spyadrian/digital-scale-pcb-firmware/docs/slides-fr.pdf

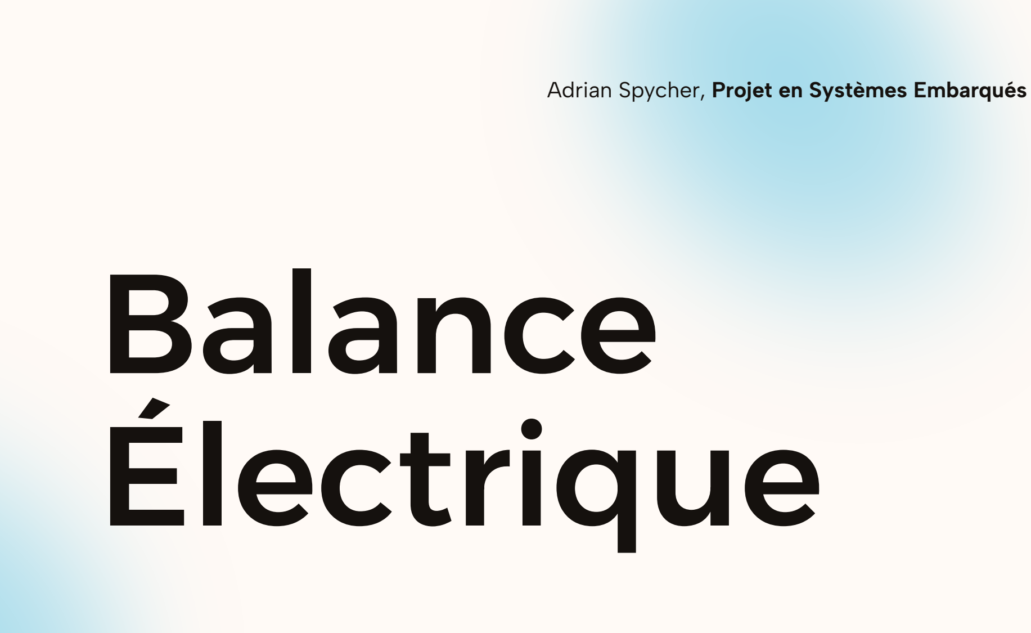
[picture p43: page 1]

# Balance Électrique

Adrian Spycher, Projet en Systèmes Embarqués

01 | Mon Projet
02 | Composants Principaux
03 | Ma Solution

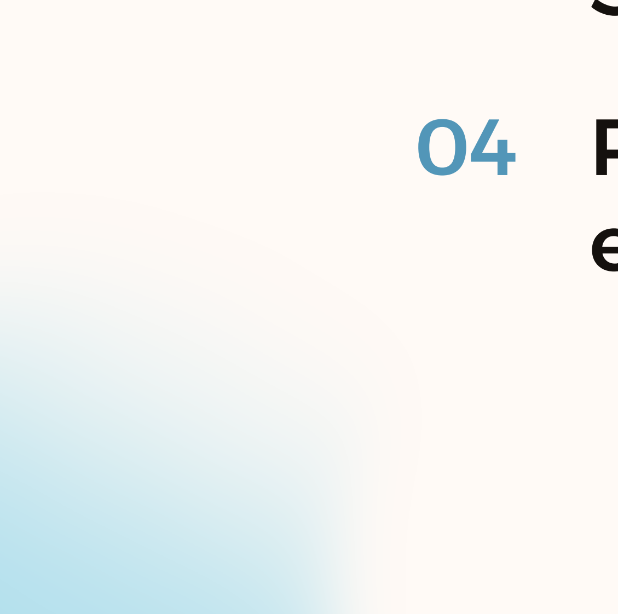
[picture p44: figure]

04 | Résultats et Problèmes

# Table des matières

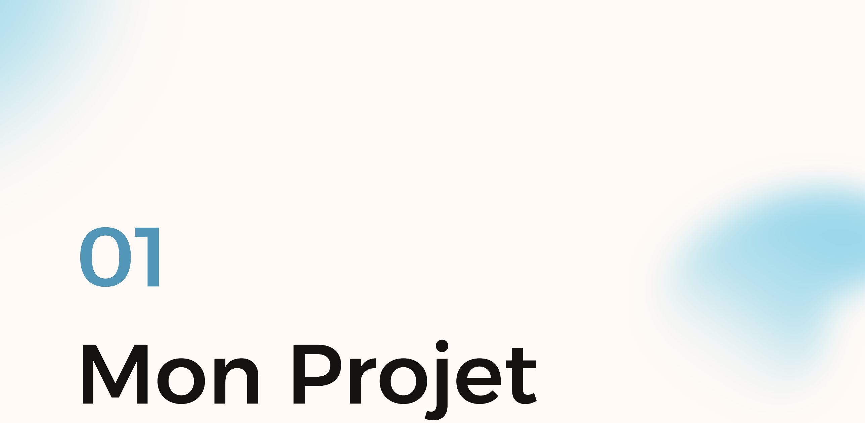
[picture p45: page 3]

01

# Mon Projet

# Balance

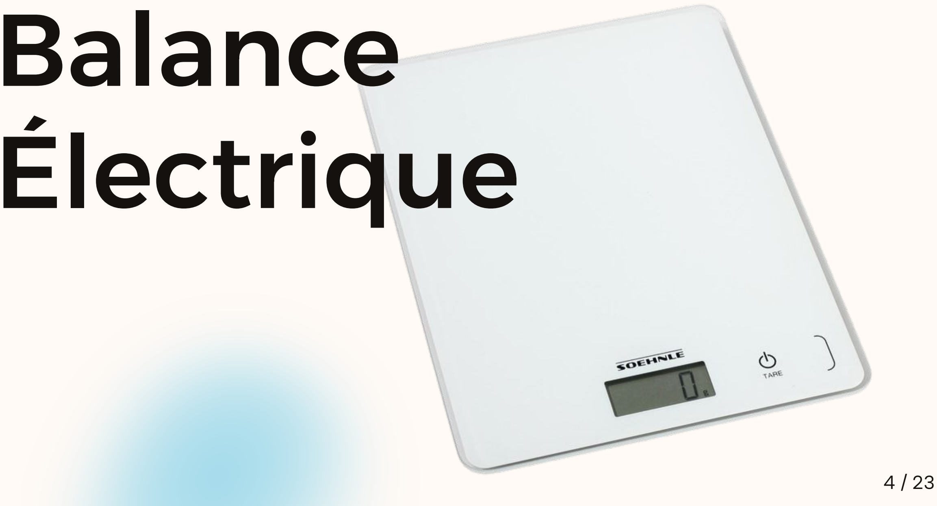
[picture p46: page 4]

# Électrique

NXP LPC804

# Contraintes

Deux I2C et GPIOs

## Basé sur un Microcontrôleur

## Protocole de Communication

SWDIO

Écran OLED 2x16 caractères

## Connecteur JTAG / SWDIO

## Capteur et Écran

Proche de celle du premier semestre

3cm x 3cm en dehors de l’écran

Autonome,

## sur Batterie

## Dimension Max

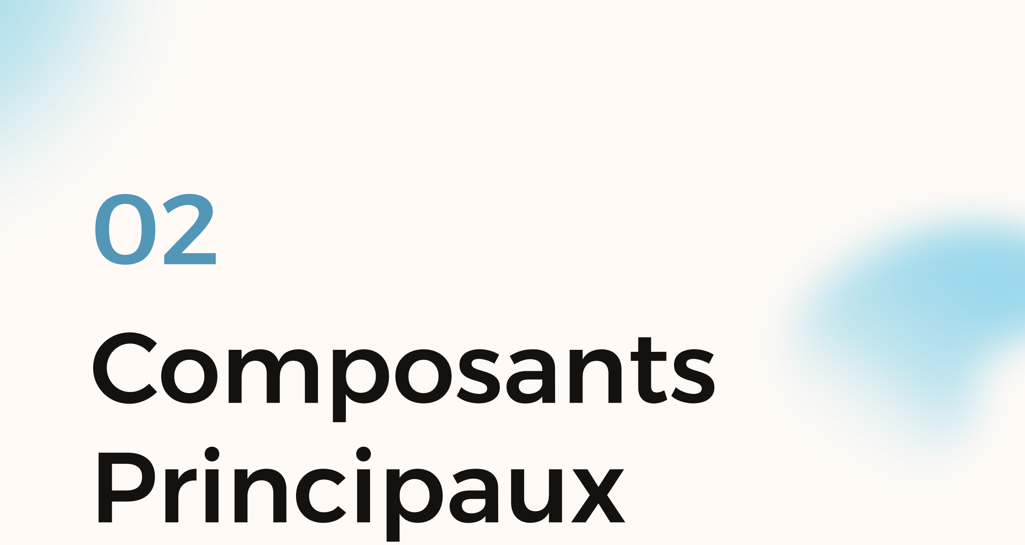
[picture p47: page 6]

# Principaux

02

# Composants

# Gestion de l’alimentation

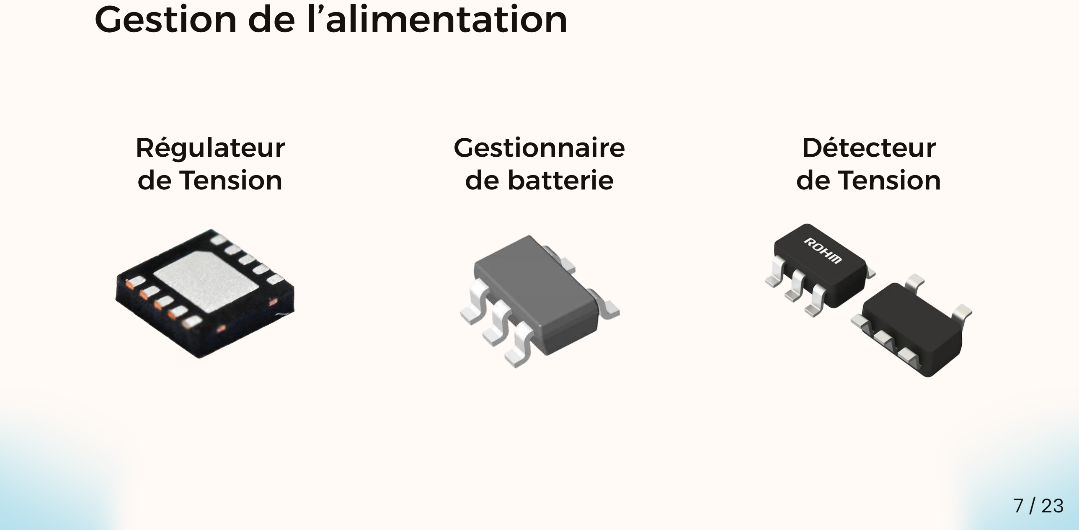
[picture p48: page 7]

## Régulateur de Tension

## Gestionnaire de batterie

## Détecteur de Tension

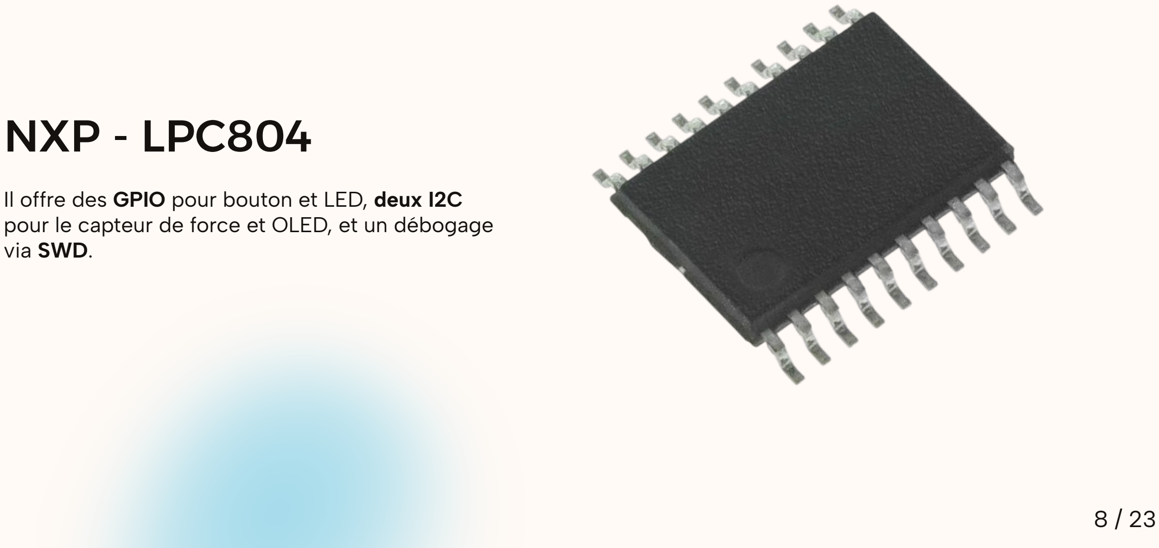
[picture p49: page 8]

# NXP - LPC804

Il offre des GPIO pour bouton et LED, deux I2C pour le capteur de force et OLED, et un débogage via SWD.

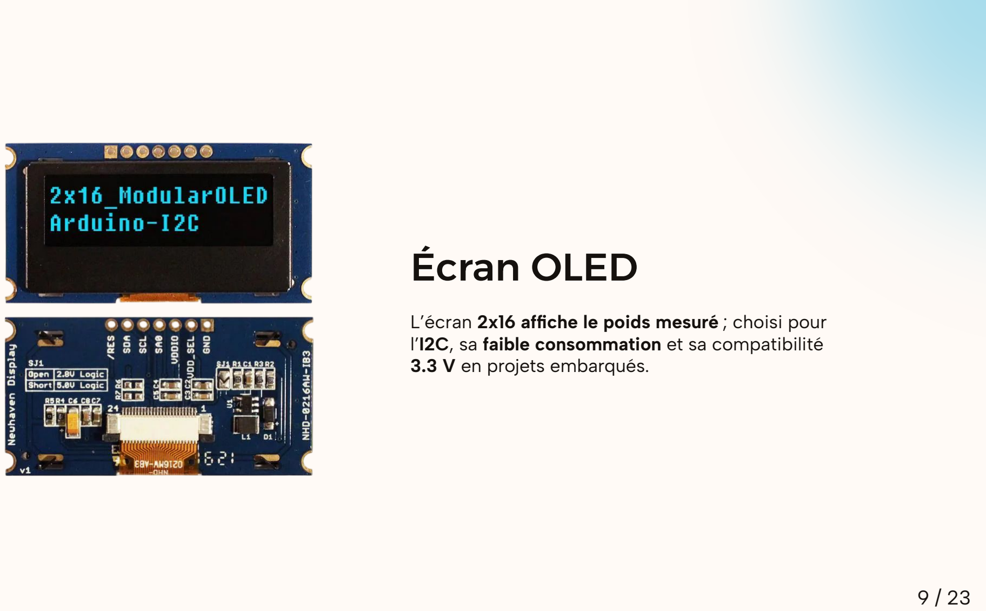
[picture p50: page 9]

# Écran OLED

L’écran 2x16 affiche le poids mesuré ; choisi pour l’I2C, sa faible consommation et sa compatibilité 3.3 V en projets embarqués.

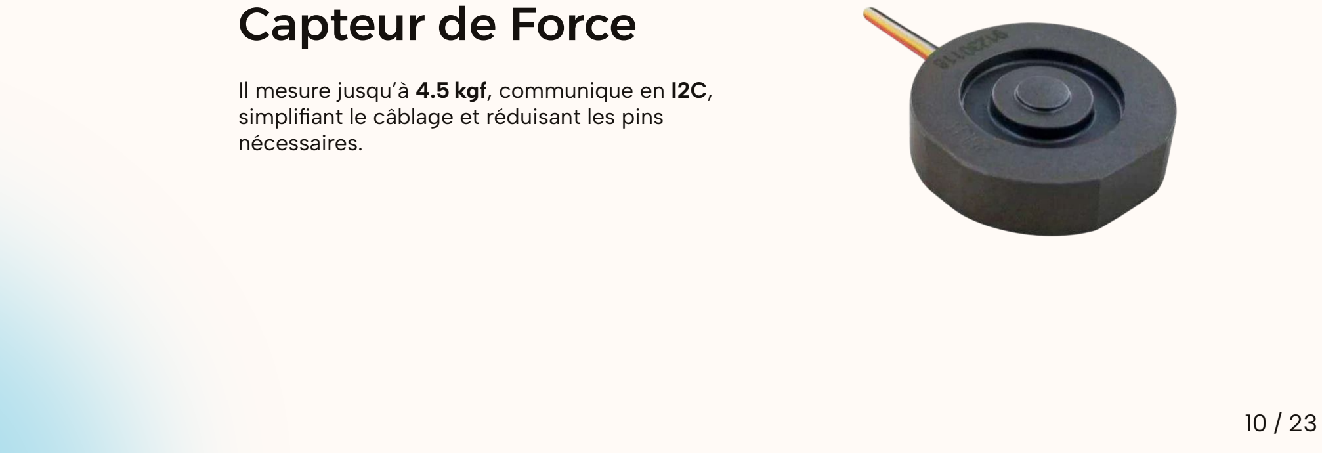
[picture p51: page 10]

# Capteur de Force

Il mesure jusqu’à 4.5 kgf, communique en I2C, simplifiant le câblage et réduisant les pins nécessaires.

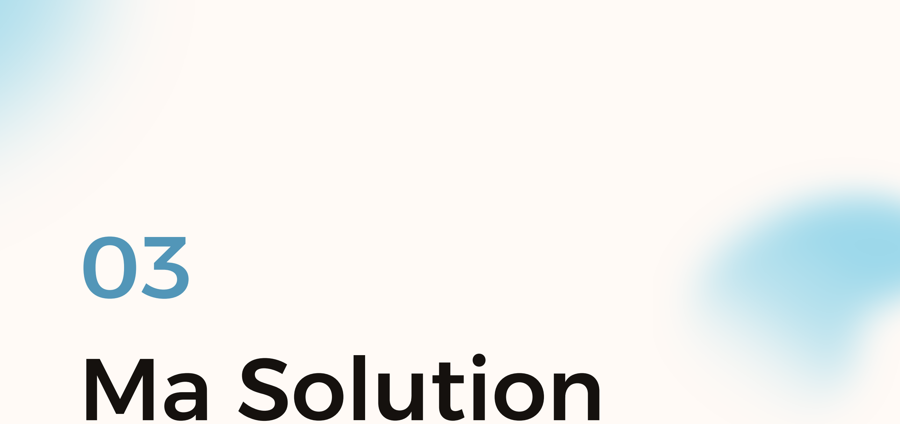
[picture p52: page 11]

03

# Ma Solution

# Schéma

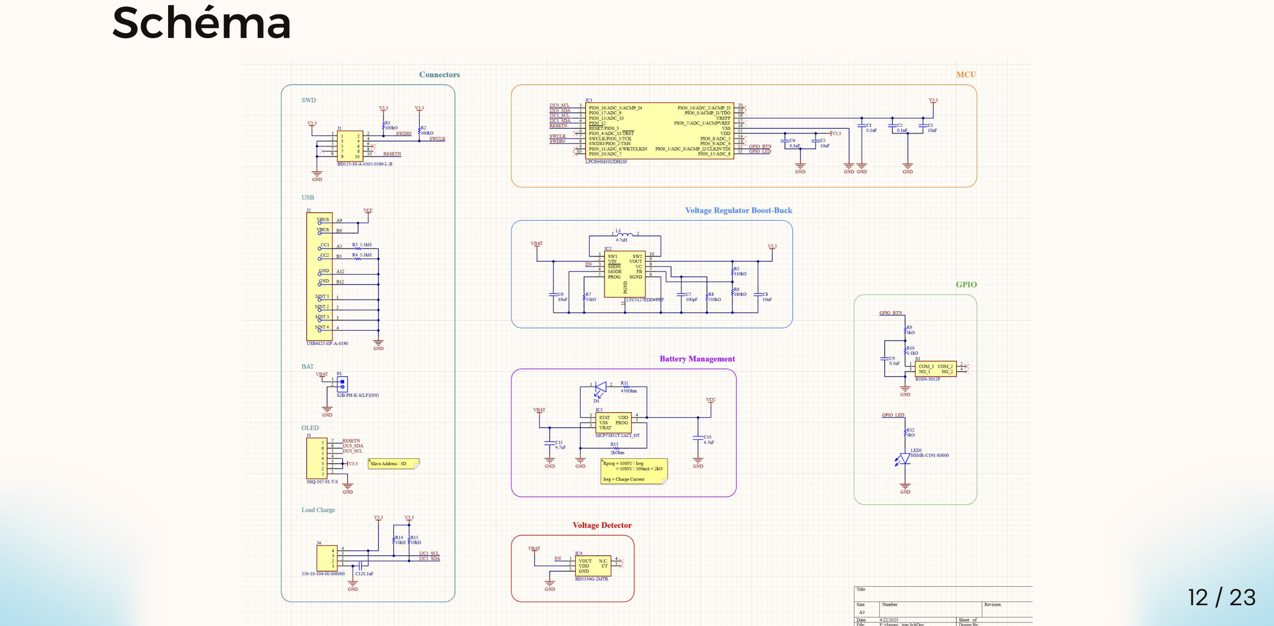
[picture p53: page 12]

# Schéma Bloc

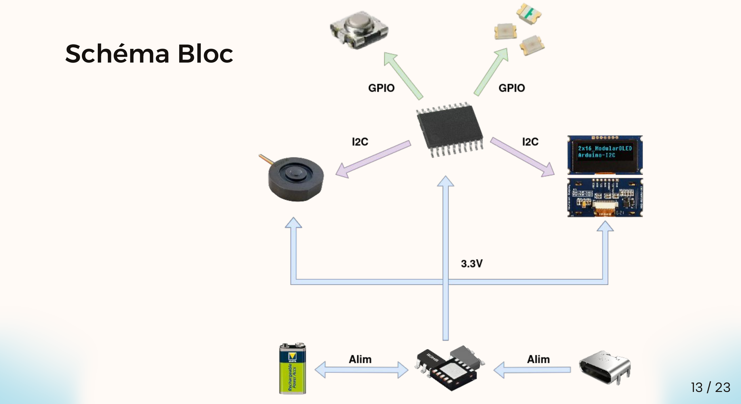
[picture p54: page 13]
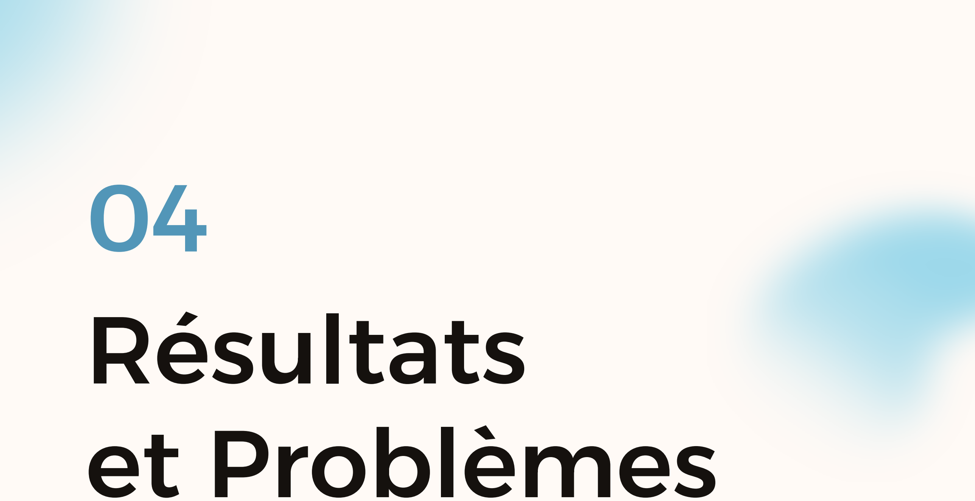
[picture p55: page 14]

# et Problèmes

04

# Résultats

## PCB Sur Altium

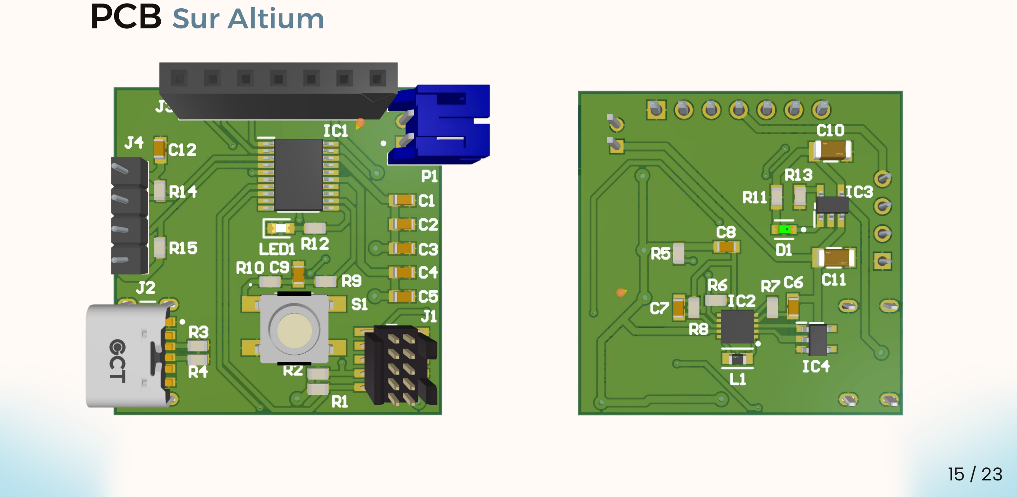
[picture p56: page 15]

## PCB Face avant

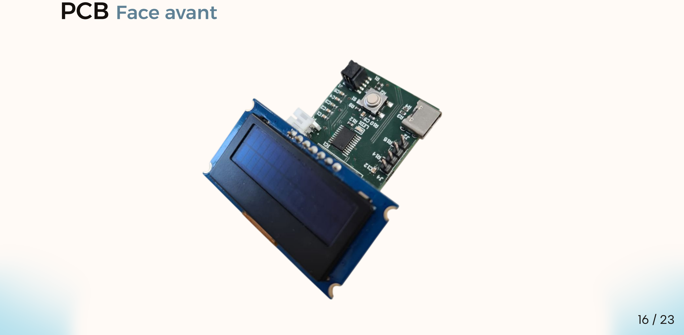
[picture p57: page 16]

## PCB Face arrière

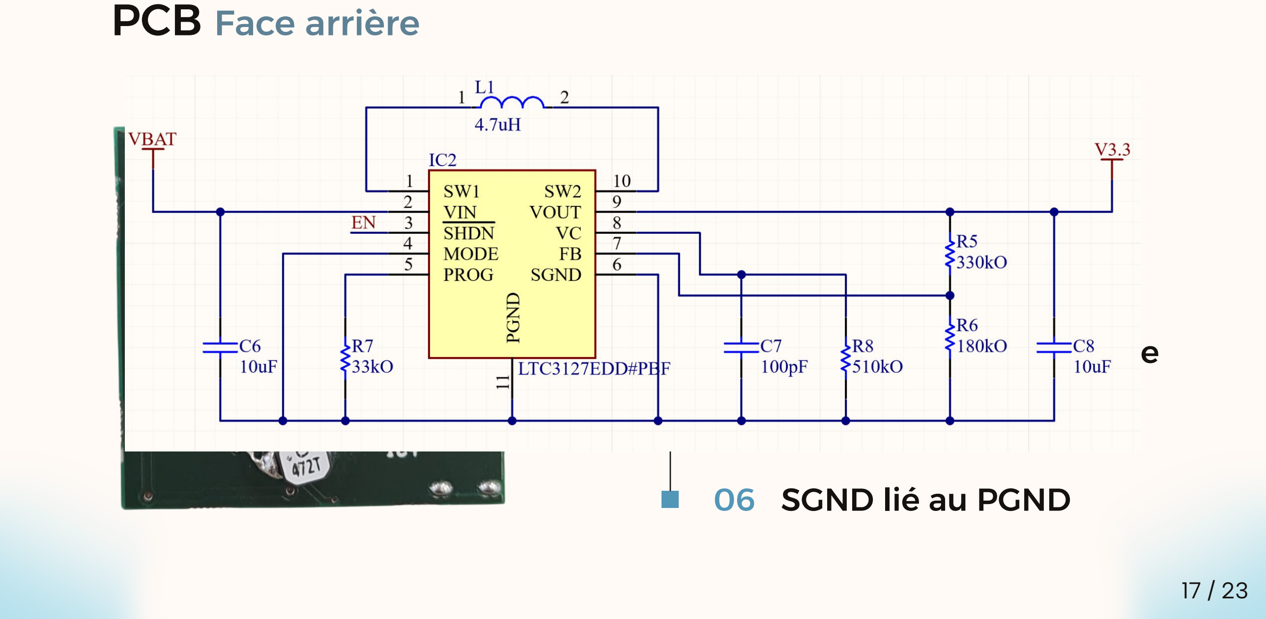
[picture p58: page 17]

01 | Signal Flottant
02 | Mauvais Footprint
03 | Tension entre 2 et 7 V
04 | Changement de Bobine
05 | Changement de COUT
06 | SGND lié au PGND

# Stabilité de la sortie 3.3V

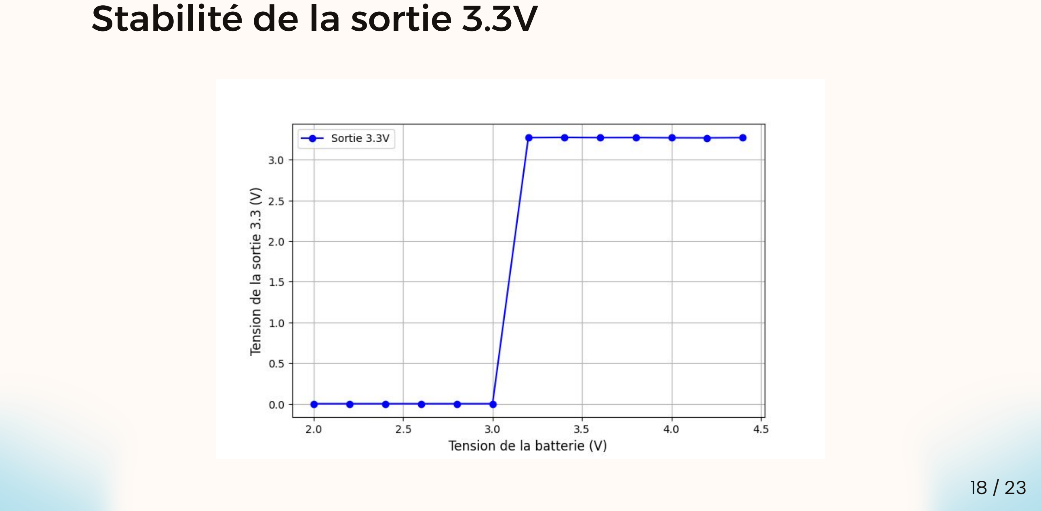
[picture p59: page 18]

# Programmation du PCB

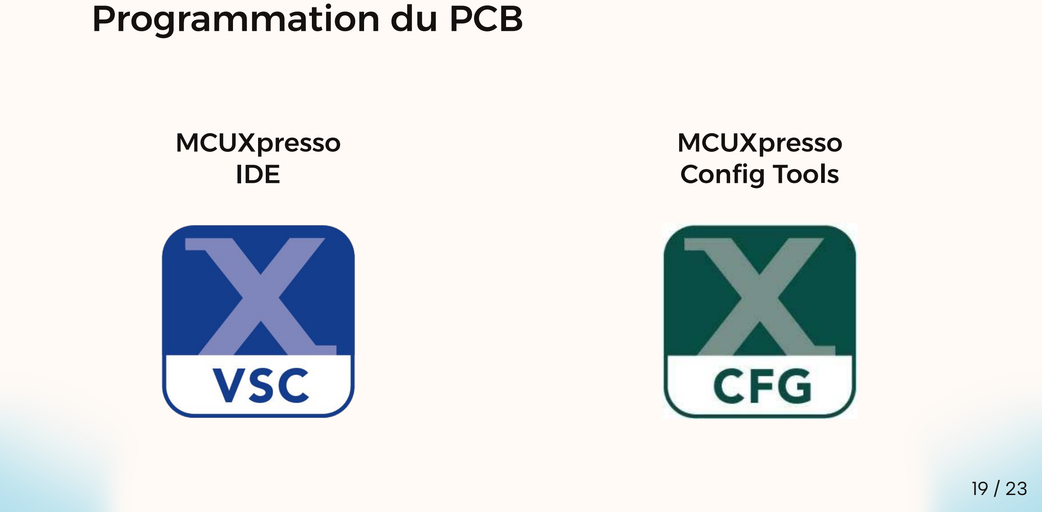
[picture p60: page 19]

## MCUXpresso IDE

## MCUXpresso Config Tools

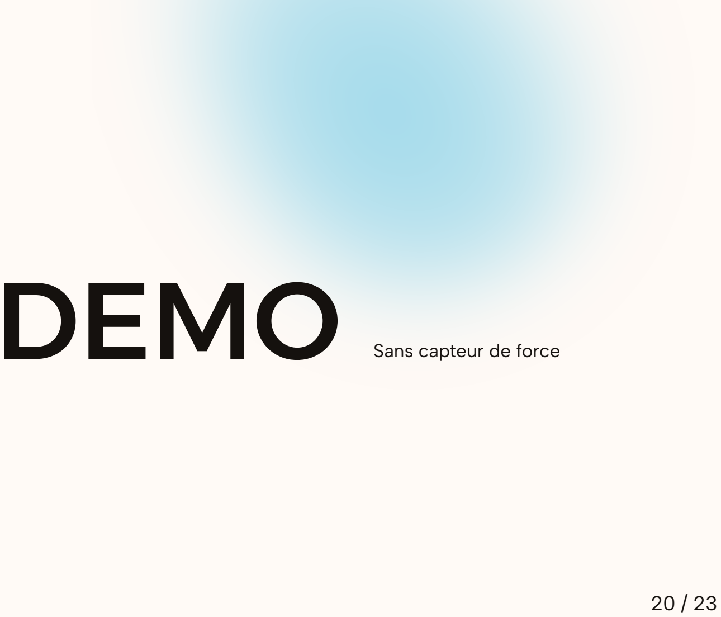
[picture p61: page 20]

# DEMO

Sans capteur de force

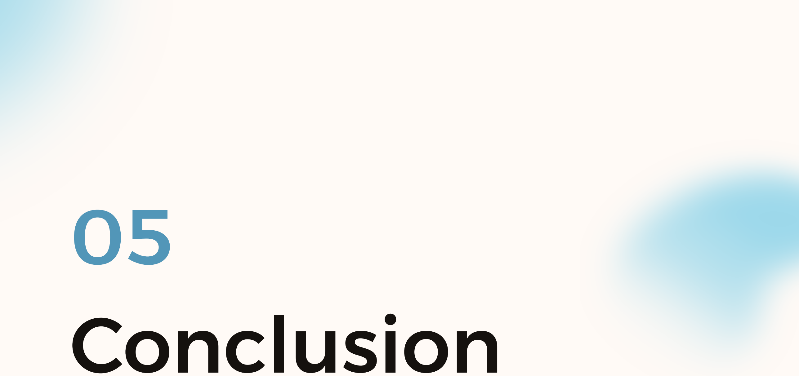
[picture p62: page 21]

05

# Conclusion

# Conclusion

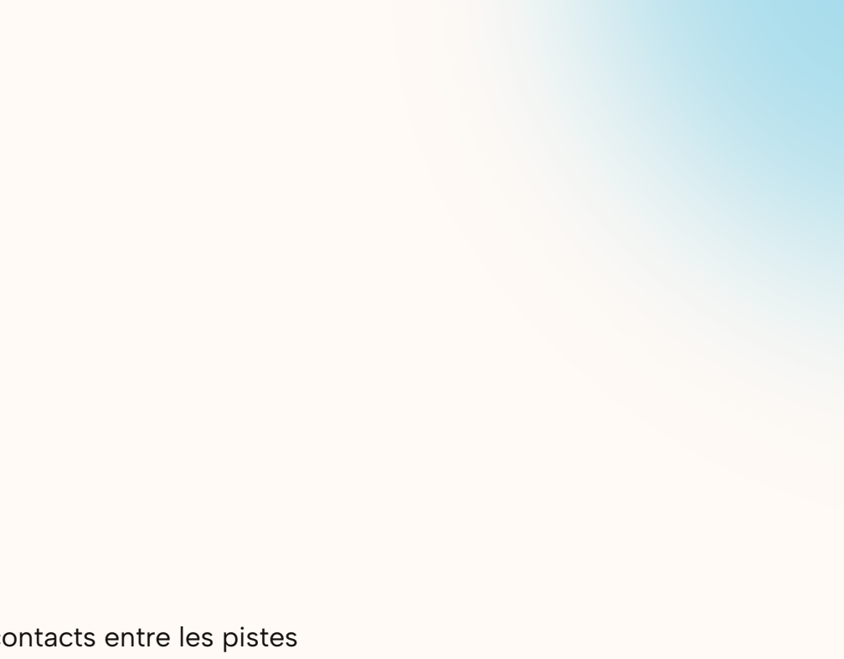
[picture p63: figure]

Lors d’un problème, je vérifierai plus rapidement les contacts entre les pistes

## Bilan du projet

## Si c’était à refaire

■ La conception et montage du PCB ■ À programmer le PCB
■ PCB fonctionnel

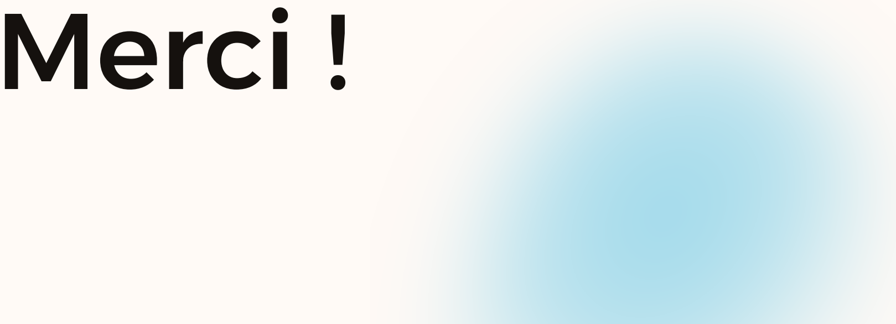
[picture p64: page 23]

# Merci !
