spyadrian/digital-scale-pcb-firmware/docs/photos/pcb-3d-back.png

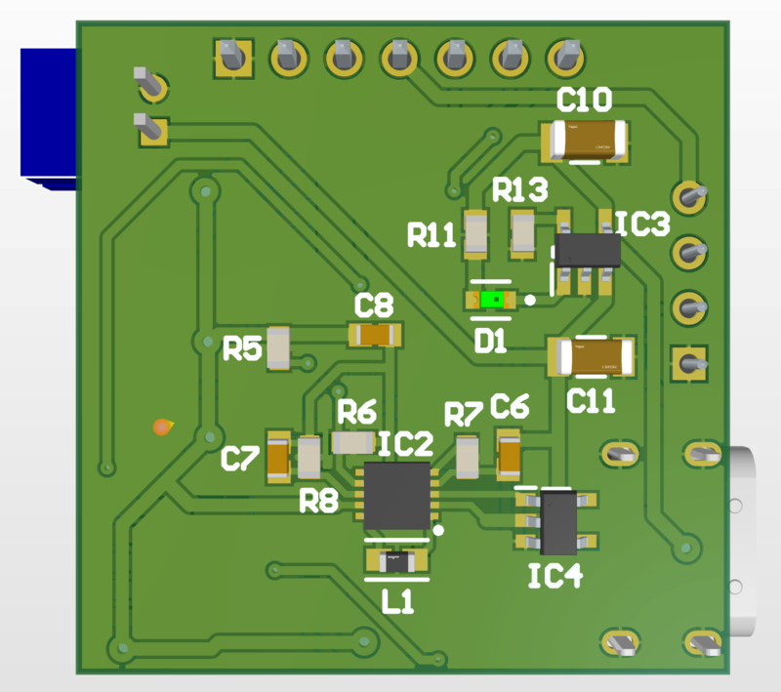
docs/photos/pcb-3d-back.png
