spyadrian/digital-scale-pcb-firmware/docs/photos/pcb-back.jpg

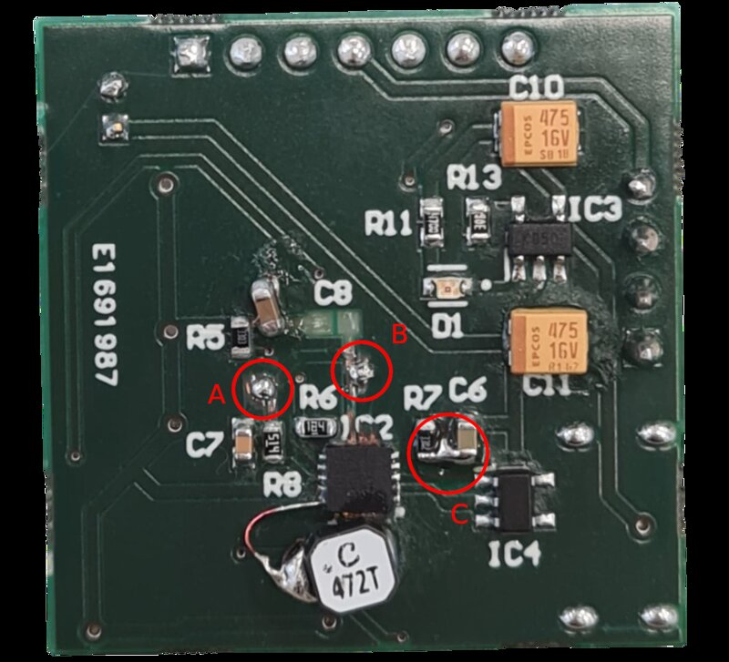
docs/photos/pcb-back.jpg
