spyadrian/digital-scale-pcb-firmware/hardware/Project Outputs for scale_project/scale_project.csv

Name | Description | Designator
0.1uF | Chip Capacitor, 100 pF, +/- 5%, 50 V, -55 to 125 degC, 0603 (1608 Metric), RoHS, Tape and Reel | C1
0.1uF | Chip Capacitor, 100 pF, +/- 5%, 50 V, -55 to 125 degC, 0603 (1608 Metric), RoHS, Tape and Reel | C2
10uF | Chip Capacitor, 100 pF, +/- 5%, 50 V, -55 to 125 degC, 0603 (1608 Metric), RoHS, Tape and Reel | C3
0.1uF | Chip Capacitor, 100 pF, +/- 5%, 50 V, -55 to 125 degC, 0603 (1608 Metric), RoHS, Tape and Reel | C4
10uF | Chip Capacitor, 100 pF, +/- 5%, 50 V, -55 to 125 degC, 0603 (1608 Metric), RoHS, Tape and Reel | C5
10uF | Chip Capacitor, 100 pF, +/- 5%, 50 V, -55 to 125 degC, 0603 (1608 Metric), RoHS, Tape and Reel | C6
100pF | Chip Capacitor, 100 pF, +/- 5%, 50 V, -55 to 125 degC, 0603 (1608 Metric), RoHS, Tape and Reel | C7
10uF | Chip Capacitor, 100 pF, +/- 5%, 50 V, -55 to 125 degC, 0603 (1608 Metric), RoHS, Tape and Reel | C8
0.1uF | Chip Capacitor, 100 pF, +/- 5%, 50 V, -55 to 125 degC, 0603 (1608 Metric), RoHS, Tape and Reel | C9
4.7uF | CAP CER 4.7UF 50V X7R 1206 | C10
4.7uF | CAP CER 4.7UF 50V X7R 1206 | C11
0.1uF | Chip Capacitor, 100 pF, +/- 5%, 50 V, -55 to 125 degC, 0603 (1608 Metric), RoHS, Tape and Reel | C12
LTST-C190GKT | LED GREEN CLEAR CHIP SMD | D1
LPC804M101JDH20J | Integrated Circuit | IC1
LTC3127EDD#PBF | Integrated Circuit | IC2
MCP73831T-2ACI_OT | Integrated Circuit | IC3
BD5330G-2MTR | Integrated Circuit | IC4
BD125-10-A-0305-0580-L-B | Connector | J1
USB4125-GF-A-0190 | CONN RCPT TYPE C 6P SMD RA | J2
SSQ-107-01-T-S | Connector | J3
350-10-104-00-006000 | Connector | J4
4.7uH | FIXED IND 4.7UH 80MA 600 MOHM | L1
HSMR-C191-S0000 | LED | LED1
S2B-PH-K-S(LF)(SN) | Male Header, Pitch 2 mm, 1 x 2 Position, Height 4.8 mm, Tail Length 3.4 mm, -25 to 85 degC, RoHS, Bulk | P1
100kO |  | R1
100kO |  | R2
5.1kO |  | R3
5.1kO |  | R4
330kO |  | R5
180kO |  | R6
33kO |  | R7
510kO |  | R8
1kO |  | R9
0.1kO |  | R10
470Ohm |  | R11
1kO |  | R12
2kOhm |  | R13
10kO |  | R14
10kO |  | R15
B3SN-3012P | Switch | S1
