spyadrian/digital-scale-pcb-firmware/hardware/scale_project.pdf

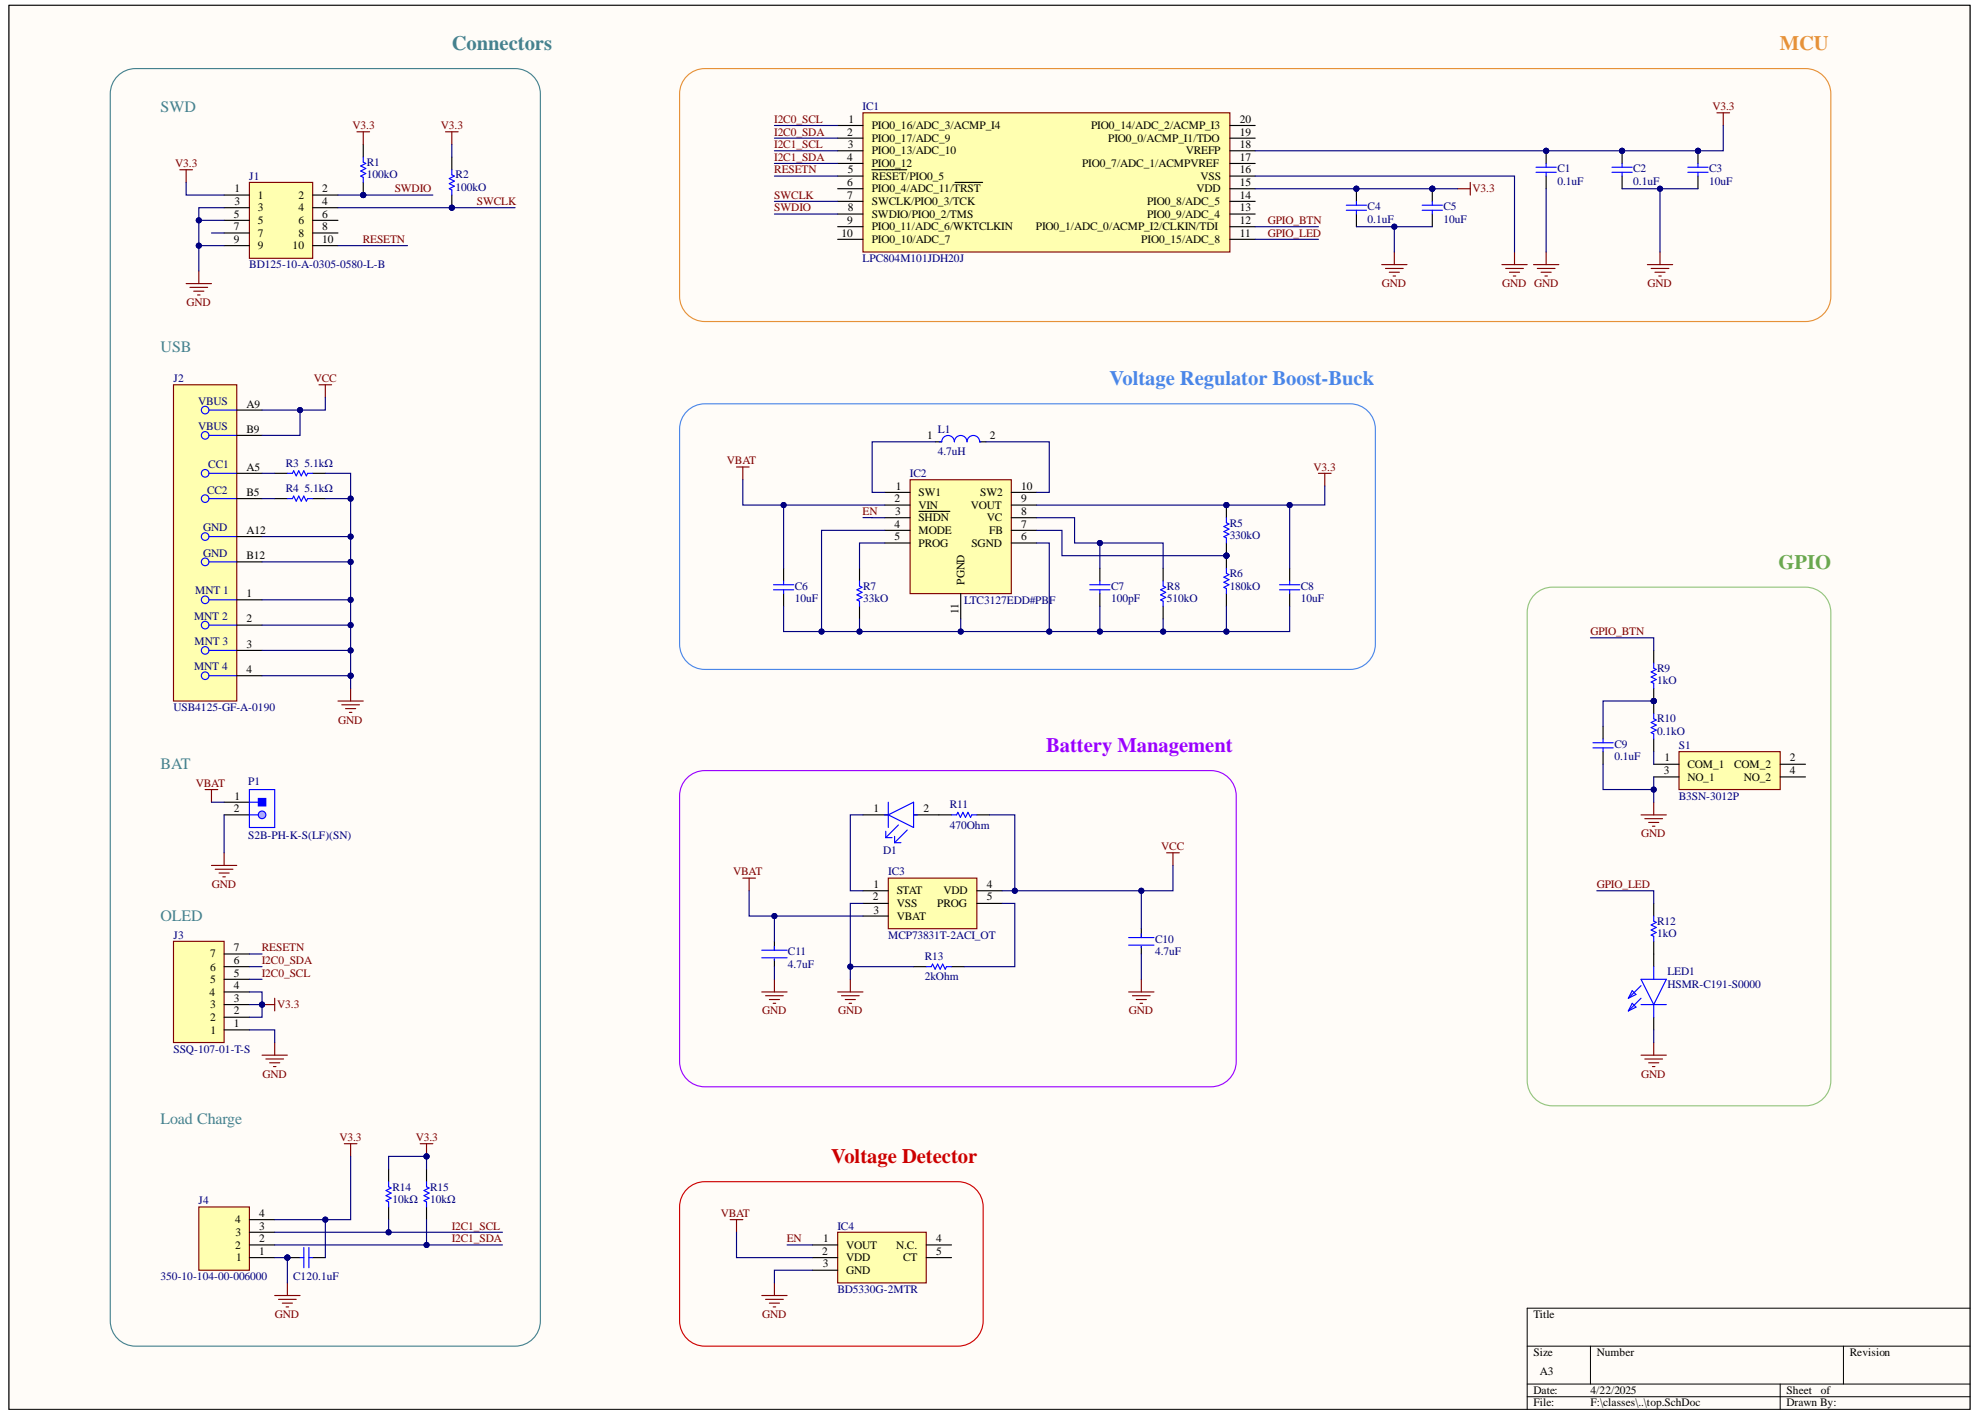
[picture p67: page 1]

Voltage Regulator Boost-Buck

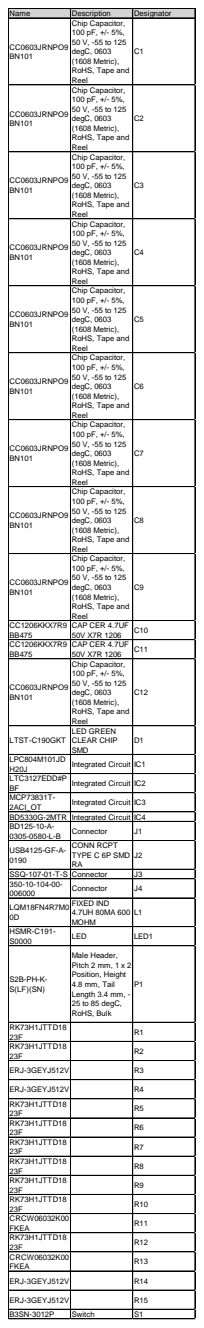
[picture p68: page 2]

Name | Description | Designator
CC0603JRNPO9 BN101 | Chip Capacitor, 100 pF, +/- 5%, 50 V, -55 to 125 degC, 0603 (1608 Metric), RoHS, Tape and Reel | C1

CC0603JRNPO9 BN101 | Chip Capacitor, 100 pF, +/- 5%, 50 V, -55 to 125 degC, 0603 (1608 Metric), RoHS, Tape and Reel | C2

CC0603JRNPO9 BN101 | Chip Capacitor, 100 pF, +/- 5%, 50 V, -55 to 125 degC, 0603 (1608 Metric), RoHS, Tape and Reel | C3

CC0603JRNPO9 BN101 | Chip Capacitor, 100 pF, +/- 5%, 50 V, -55 to 125 degC, 0603 (1608 Metric), RoHS, Tape and Reel | C4

CC0603JRNPO9 BN101 | Chip Capacitor, 100 pF, +/- 5%, 50 V, -55 to 125 degC, 0603 (1608 Metric), RoHS, Tape and Reel | C5

CC0603JRNPO9 BN101 | Chip Capacitor, 100 pF, +/- 5%, 50 V, -55 to 125 degC, 0603 (1608 Metric), RoHS, Tape and Reel | C6

CC0603JRNPO9 BN101 | Chip Capacitor, 100 pF, +/- 5%, 50 V, -55 to 125 degC, 0603 (1608 Metric), RoHS, Tape and Reel | C7

CC0603JRNPO9 BN101 | Chip Capacitor, 100 pF, +/- 5%, 50 V, -55 to 125 degC, 0603 (1608 Metric), RoHS, Tape and Reel | C8

CC0603JRNPO9 BN101 | Chip Capacitor, 100 pF, +/- 5%, 50 V, -55 to 125 degC, 0603 (1608 Metric), RoHS, Tape and Reel | C9

CC1206KKX7R9 BB475 | CAP CER 4.7UF 50V X7R 1206 | C10

CC1206KKX7R9 BB475 | CAP CER 4.7UF 50V X7R 1206 | C11

CC0603JRNPO9 BN101 | Chip Capacitor, 100 pF, +/- 5%, 50 V, -55 to 125 degC, 0603 (1608 Metric), RoHS, Tape and Reel | C12

LTST-C190GKT | LED GREEN CLEAR CHIP SMD | D1

LPC804M101JD H20J | Integrated Circuit | IC1

LTC3127EDD#P BF | Integrated Circuit | IC2

MCP73831T-2ACI_OT | Integrated Circuit | IC3

BD5330G-2MTR | Integrated Circuit | IC4
BD125-10-A-0305-0580-L-B | Connector | J1

USB4125-GF-A-0190 | CONN RCPT TYPE C 6P SMD RA | J2

SSQ-107-01-T-S | Connector | J3
350-10-104-00-006000 | Connector | J4

LQM18FN4R7M0 0D | FIXED IND 4.7UH 80MA 600 MOHM | L1

HSMR-C191-S0000 | LED | LED1

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

RK73H1JTTD18 23F | | R1

RK73H1JTTD18 23F | | R2

ERJ-3GEYJ512V | | R3

ERJ-3GEYJ512V | | R4

RK73H1JTTD18 23F | | R5

RK73H1JTTD18 23F | | R6

RK73H1JTTD18 23F | | R7

RK73H1JTTD18 23F | | R8

RK73H1JTTD18 23F | | R9

RK73H1JTTD18 23F | | R10

CRCW06032K00 FKEA | | R11

RK73H1JTTD18 23F | | R12

CRCW06032K00 FKEA | | R13

ERJ-3GEYJ512V | | R14

ERJ-3GEYJ512V | | R15

B3SN-3012P | Switch | S1
