spyadrian/digital-scale-pcb-firmware/(list of files, drawings)

Other design files:
hardware/PCB1.PcbDoc
hardware/PcbLib1.PcbLib
hardware/scale_project.PrjPcb
hardware/Schlib1.SchLib
hardware/top.SchDoc
