spyadrian/digital-scale-pcb-firmware/firmware/device/periph5/PERI_PINT.h

/*
** ###################################################################
**     Processors:          LPC804M101JDH20
**                          LPC804M101JDH24
**                          LPC804M101JHI33
**                          LPC804M111JDH24
**                          LPC804UK
**
**     Version:             rev. 1.0, 2018-01-09
**     Build:               b240704
**
**     Abstract:
**         CMSIS Peripheral Access Layer for PINT
**
**     Copyright 1997-2016 Freescale Semiconductor, Inc.
**     Copyright 2016-2024 NXP
**     SPDX-License-Identifier: BSD-3-Clause
**
**     http:                 www.nxp.com
**     mail:                 support@nxp.com
**
**     Revisions:
**     - rev. 1.0 (2018-01-09)
**         Initial version.
**
** ###################################################################
*/

/*!
 * @file PINT.h
 * @version 1.0
 * @date 2018-01-09
 * @brief CMSIS Peripheral Access Layer for PINT
 *
 * CMSIS Peripheral Access Layer for PINT
 */

#if !defined(PINT_H_)
#define PINT_H_                                  /**< Symbol preventing repeated inclusion */

#if (defined(CPU_LPC804M101JDH20) || defined(CPU_LPC804M101JDH24) || defined(CPU_LPC804M101JHI33) || defined(CPU_LPC804M111JDH24) || defined(CPU_LPC804UK))
#include "LPC804_COMMON.h"
#else
  #error "No valid CPU defined!"
#endif

/* ----------------------------------------------------------------------------
   -- Device Peripheral Access Layer
   ---------------------------------------------------------------------------- */

/*!
 * @addtogroup Peripheral_access_layer Device Peripheral Access Layer
 * @{
 */


/*
** Start of section using anonymous unions
*/

#if defined(__ARMCC_VERSION)
  #if (__ARMCC_VERSION >= 6010050)
    #pragma clang diagnostic push
  #else
    #pragma push
    #pragma anon_unions
  #endif
#elif defined(__GNUC__)
  /* anonymous unions are enabled by default */
#elif defined(__IAR_SYSTEMS_ICC__)
  #pragma language=extended
#else
  #error Not supported compiler type
#endif

/* ----------------------------------------------------------------------------
   -- PINT Peripheral Access Layer
   ---------------------------------------------------------------------------- */

/*!
 * @addtogroup PINT_Peripheral_Access_Layer PINT Peripheral Access Layer
 * @{
 */

/** PINT - Register Layout Typedef */
typedef struct {
  __IO uint32_t ISEL;                              /**< Pin Interrupt Mode register, offset: 0x0 */
  __IO uint32_t IENR;                              /**< Pin interrupt level or rising edge interrupt enable register, offset: 0x4 */
  __O  uint32_t SIENR;                             /**< Pin interrupt level or rising edge interrupt set register, offset: 0x8 */
  __O  uint32_t CIENR;                             /**< Pin interrupt level (rising edge interrupt) clear register, offset: 0xC */
  __IO uint32_t IENF;                              /**< Pin interrupt active level or falling edge interrupt enable register, offset: 0x10 */
  __O  uint32_t SIENF;                             /**< Pin interrupt active level or falling edge interrupt set register, offset: 0x14 */
  __O  uint32_t CIENF;                             /**< Pin interrupt active level or falling edge interrupt clear register, offset: 0x18 */
  __IO uint32_t RISE;                              /**< Pin interrupt rising edge register, offset: 0x1C */
  __IO uint32_t FALL;                              /**< Pin interrupt falling edge register, offset: 0x20 */
  __IO uint32_t IST;                               /**< Pin interrupt status register, offset: 0x24 */
  __IO uint32_t PMCTRL;                            /**< Pattern match interrupt control register, offset: 0x28 */
  __IO uint32_t PMSRC;                             /**< Pattern match interrupt bit-slice source register, offset: 0x2C */
  __IO uint32_t PMCFG;                             /**< Pattern match interrupt bit slice configuration register, offset: 0x30 */
} PINT_Type;

/* ----------------------------------------------------------------------------
   -- PINT Register Masks
   ---------------------------------------------------------------------------- */

/*!
 * @addtogroup PINT_Register_Masks PINT Register Masks
 * @{
 */

/*! @name ISEL - Pin Interrupt Mode register */
/*! @{ */

#define PINT_ISEL_PMODE_MASK                     (0xFFU)
#define PINT_ISEL_PMODE_SHIFT                    (0U)
/*! PMODE - Selects the interrupt mode for each pin interrupt. Bit n configures the pin interrupt
 *    selected in PINTSELn. 0 = Edge sensitive 1 = Level sensitive
 */
#define PINT_ISEL_PMODE(x)                       (((uint32_t)(((uint32_t)(x)) << PINT_ISEL_PMODE_SHIFT)) & PINT_ISEL_PMODE_MASK)
/*! @} */

/*! @name IENR - Pin interrupt level or rising edge interrupt enable register */
/*! @{ */

#define PINT_IENR_ENRL_MASK                      (0xFFU)
#define PINT_IENR_ENRL_SHIFT                     (0U)
/*! ENRL - Enables the rising edge or level interrupt for each pin interrupt. Bit n configures the
 *    pin interrupt selected in PINTSELn. 0 = Disable rising edge or level interrupt. 1 = Enable
 *    rising edge or level interrupt.
 */
#define PINT_IENR_ENRL(x)                        (((uint32_t)(((uint32_t)(x)) << PINT_IENR_ENRL_SHIFT)) & PINT_IENR_ENRL_MASK)
/*! @} */

/*! @name SIENR - Pin interrupt level or rising edge interrupt set register */
/*! @{ */

#define PINT_SIENR_SETENRL_MASK                  (0xFFU)
#define PINT_SIENR_SETENRL_SHIFT                 (0U)
/*! SETENRL - Ones written to this address set bits in the IENR, thus enabling interrupts. Bit n
 *    sets bit n in the IENR register. 0 = No operation. 1 = Enable rising edge or level interrupt.
 */
#define PINT_SIENR_SETENRL(x)                    (((uint32_t)(((uint32_t)(x)) << PINT_SIENR_SETENRL_SHIFT)) & PINT_SIENR_SETENRL_MASK)
/*! @} */

/*! @name CIENR - Pin interrupt level (rising edge interrupt) clear register */
/*! @{ */

#define PINT_CIENR_CENRL_MASK                    (0xFFU)
#define PINT_CIENR_CENRL_SHIFT                   (0U)
/*! CENRL - Ones written to this address clear bits in the IENR, thus disabling the interrupts. Bit
 *    n clears bit n in the IENR register. 0 = No operation. 1 = Disable rising edge or level
 *    interrupt.
 */
#define PINT_CIENR_CENRL(x)                      (((uint32_t)(((uint32_t)(x)) << PINT_CIENR_CENRL_SHIFT)) & PINT_CIENR_CENRL_MASK)
/*! @} */

/*! @name IENF - Pin interrupt active level or falling edge interrupt enable register */
/*! @{ */

#define PINT_IENF_ENAF_MASK                      (0xFFU)
#define PINT_IENF_ENAF_SHIFT                     (0U)
/*! ENAF - Enables the falling edge or configures the active level interrupt for each pin interrupt.
 *    Bit n configures the pin interrupt selected in PINTSELn. 0 = Disable falling edge interrupt
 *    or set active interrupt level LOW. 1 = Enable falling edge interrupt enabled or set active
 *    interrupt level HIGH.
 */
#define PINT_IENF_ENAF(x)                        (((uint32_t)(((uint32_t)(x)) << PINT_IENF_ENAF_SHIFT)) & PINT_IENF_ENAF_MASK)
/*! @} */

/*! @name SIENF - Pin interrupt active level or falling edge interrupt set register */
/*! @{ */

#define PINT_SIENF_SETENAF_MASK                  (0xFFU)
#define PINT_SIENF_SETENAF_SHIFT                 (0U)
/*! SETENAF - Ones written to this address set bits in the IENF, thus enabling interrupts. Bit n
 *    sets bit n in the IENF register. 0 = No operation. 1 = Select HIGH-active interrupt or enable
 *    falling edge interrupt.
 */
#define PINT_SIENF_SETENAF(x)                    (((uint32_t)(((uint32_t)(x)) << PINT_SIENF_SETENAF_SHIFT)) & PINT_SIENF_SETENAF_MASK)
/*! @} */

/*! @name CIENF - Pin interrupt active level or falling edge interrupt clear register */
/*! @{ */

#define PINT_CIENF_CENAF_MASK                    (0xFFU)
#define PINT_CIENF_CENAF_SHIFT                   (0U)
/*! CENAF - Ones written to this address clears bits in the IENF, thus disabling interrupts. Bit n
 *    clears bit n in the IENF register. 0 = No operation. 1 = LOW-active interrupt selected or
 *    falling edge interrupt disabled.
 */
#define PINT_CIENF_CENAF(x)                      (((uint32_t)(((uint32_t)(x)) << PINT_CIENF_CENAF_SHIFT)) & PINT_CIENF_CENAF_MASK)
/*! @} */

/*! @name RISE - Pin interrupt rising edge register */
/*! @{ */

#define PINT_RISE_RDET_MASK                      (0xFFU)
#define PINT_RISE_RDET_SHIFT                     (0U)
/*! RDET - Rising edge detect. Bit n detects the rising edge of the pin selected in PINTSELn. Read
 *    0: No rising edge has been detected on this pin since Reset or the last time a one was written
 *    to this bit. Write 0: no operation. Read 1: a rising edge has been detected since Reset or the
 *    last time a one was written to this bit. Write 1: clear rising edge detection for this pin.
 */
#define PINT_RISE_RDET(x)                        (((uint32_t)(((uint32_t)(x)) << PINT_RISE_RDET_SHIFT)) & PINT_RISE_RDET_MASK)
/*! @} */

/*! @name FALL - Pin interrupt falling edge register */
/*! @{ */

#define PINT_FALL_FDET_MASK                      (0xFFU)
#define PINT_FALL_FDET_SHIFT                     (0U)
/*! FDET - Falling edge detect. Bit n detects the falling edge of the pin selected in PINTSELn. Read
 *    0: No falling edge has been detected on this pin since Reset or the last time a one was
 *    written to this bit. Write 0: no operation. Read 1: a falling edge has been detected since Reset or
 *    the last time a one was written to this bit. Write 1: clear falling edge detection for this
 *    pin.
 */
#define PINT_FALL_FDET(x)                        (((uint32_t)(((uint32_t)(x)) << PINT_FALL_FDET_SHIFT)) & PINT_FALL_FDET_MASK)
/*! @} */

/*! @name IST - Pin interrupt status register */
/*! @{ */

#define PINT_IST_PSTAT_MASK                      (0xFFU)
#define PINT_IST_PSTAT_SHIFT                     (0U)
/*! PSTAT - Pin interrupt status. Bit n returns the status, clears the edge interrupt, or inverts
 *    the active level of the pin selected in PINTSELn. Read 0: interrupt is not being requested for
 *    this interrupt pin. Write 0: no operation. Read 1: interrupt is being requested for this
 *    interrupt pin. Write 1 (edge-sensitive): clear rising- and falling-edge detection for this pin.
 *    Write 1 (level-sensitive): switch the active level for this pin (in the IENF register).
 */
#define PINT_IST_PSTAT(x)                        (((uint32_t)(((uint32_t)(x)) << PINT_IST_PSTAT_SHIFT)) & PINT_IST_PSTAT_MASK)
/*! @} */

/*! @name PMCTRL - Pattern match interrupt control register */
/*! @{ */

#define PINT_PMCTRL_SEL_PMATCH_MASK              (0x1U)
#define PINT_PMCTRL_SEL_PMATCH_SHIFT             (0U)
/*! SEL_PMATCH - Specifies whether the 8 pin interrupts are controlled by the pin interrupt function or by the pattern match function.
 *  0b0..Pin interrupt. Interrupts are driven in response to the standard pin interrupt function.
 *  0b1..Pattern match. Interrupts are driven in response to pattern matches.
 */
#define PINT_PMCTRL_SEL_PMATCH(x)                (((uint32_t)(((uint32_t)(x)) << PINT_PMCTRL_SEL_PMATCH_SHIFT)) & PINT_PMCTRL_SEL_PMATCH_MASK)

#define PINT_PMCTRL_ENA_RXEV_MASK                (0x2U)
#define PINT_PMCTRL_ENA_RXEV_SHIFT               (1U)
/*! ENA_RXEV - Enables the RXEV output to the CPU and/or to a GPIO output when the specified boolean expression evaluates to true.
 *  0b0..Disabled. RXEV output to the CPU is disabled.
 *  0b1..Enabled. RXEV output to the CPU is enabled.
 */
#define PINT_PMCTRL_ENA_RXEV(x)                  (((uint32_t)(((uint32_t)(x)) << PINT_PMCTRL_ENA_RXEV_SHIFT)) & PINT_PMCTRL_ENA_RXEV_MASK)

#define PINT_PMCTRL_PMAT_MASK                    (0xFF000000U)
#define PINT_PMCTRL_PMAT_SHIFT                   (24U)
/*! PMAT - This field displays the current state of pattern matches. A 1 in any bit of this field
 *    indicates that the corresponding product term is matched by the current state of the appropriate
 *    inputs.
 */
#define PINT_PMCTRL_PMAT(x)                      (((uint32_t)(((uint32_t)(x)) << PINT_PMCTRL_PMAT_SHIFT)) & PINT_PMCTRL_PMAT_MASK)
/*! @} */

/*! @name PMSRC - Pattern match interrupt bit-slice source register */
/*! @{ */

#define PINT_PMSRC_SRC0_MASK                     (0x700U)
#define PINT_PMSRC_SRC0_SHIFT                    (8U)
/*! SRC0 - Selects the input source for bit slice 0
 *  0b000..Input 0. Selects the pin selected in the PINTSEL0 register as the source to bit slice 0.
 *  0b001..Input 1. Selects the pin selected in the PINTSEL1 register as the source to bit slice 0.
 *  0b010..Input 2. Selects the pin selected in the PINTSEL2 register as the source to bit slice 0.
 *  0b011..Input 3. Selects the pin selected in the PINTSEL3 register as the source to bit slice 0.
 *  0b100..Input 4. Selects the pin selected in the PINTSEL4 register as the source to bit slice 0.
 *  0b101..Input 5. Selects the pin selected in the PINTSEL5 register as the source to bit slice 0.
 *  0b110..Input 6. Selects the pin selected in the PINTSEL6 register as the source to bit slice 0.
 *  0b111..Input 7. Selects the pin selected in the PINTSEL7 register as the source to bit slice 0.
 */
#define PINT_PMSRC_SRC0(x)                       (((uint32_t)(((uint32_t)(x)) << PINT_PMSRC_SRC0_SHIFT)) & PINT_PMSRC_SRC0_MASK)

#define PINT_PMSRC_SRC1_MASK                     (0x3800U)
#define PINT_PMSRC_SRC1_SHIFT                    (11U)
/*! SRC1 - Selects the input source for bit slice 1
 *  0b000..Input 0. Selects the pin selected in the PINTSEL0 register as the source to bit slice 1.
 *  0b001..Input 1. Selects the pin selected in the PINTSEL1 register as the source to bit slice 1.
 *  0b010..Input 2. Selects the pin selected in the PINTSEL2 register as the source to bit slice 1.
 *  0b011..Input 3. Selects the pin selected in the PINTSEL3 register as the source to bit slice 1.
 *  0b100..Input 4. Selects the pin selected in the PINTSEL4 register as the source to bit slice 1.
 *  0b101..Input 5. Selects the pin selected in the PINTSEL5 register as the source to bit slice 1.
 *  0b110..Input 6. Selects the pin selected in the PINTSEL6 register as the source to bit slice 1.
 *  0b111..Input 7. Selects the pin selected in the PINTSEL7 register as the source to bit slice 1.
 */
#define PINT_PMSRC_SRC1(x)                       (((uint32_t)(((uint32_t)(x)) << PINT_PMSRC_SRC1_SHIFT)) & PINT_PMSRC_SRC1_MASK)

#define PINT_PMSRC_SRC2_MASK                     (0x1C000U)
#define PINT_PMSRC_SRC2_SHIFT                    (14U)
/*! SRC2 - Selects the input source for bit slice 2
 *  0b000..Input 0. Selects the pin selected in the PINTSEL0 register as the source to bit slice 2.
 *  0b001..Input 1. Selects the pin selected in the PINTSEL1 register as the source to bit slice 2.
 *  0b010..Input 2. Selects the pin selected in the PINTSEL2 register as the source to bit slice 2.
 *  0b011..Input 3. Selects the pin selected in the PINTSEL3 register as the source to bit slice 2.
 *  0b100..Input 4. Selects the pin selected in the PINTSEL4 register as the source to bit slice 2.
 *  0b101..Input 5. Selects the pin selected in the PINTSEL5 register as the source to bit slice 2.
 *  0b110..Input 6. Selects the pin selected in the PINTSEL6 register as the source to bit slice 2.
 *  0b111..Input 7. Selects the pin selected in the PINTSEL7 register as the source to bit slice 2.
 */
#define PINT_PMSRC_SRC2(x)                       (((uint32_t)(((uint32_t)(x)) << PINT_PMSRC_SRC2_SHIFT)) & PINT_PMSRC_SRC2_MASK)

#define PINT_PMSRC_SRC3_MASK                     (0xE0000U)
#define PINT_PMSRC_SRC3_SHIFT                    (17U)
/*! SRC3 - Selects the input source for bit slice 3
 *  0b000..Input 0. Selects the pin selected in the PINTSEL0 register as the source to bit slice 3.
 *  0b001..Input 1. Selects the pin selected in the PINTSEL1 register as the source to bit slice 3.
 *  0b010..Input 2. Selects the pin selected in the PINTSEL2 register as the source to bit slice 3.
 *  0b011..Input 3. Selects the pin selected in the PINTSEL3 register as the source to bit slice 3.
 *  0b100..Input 4. Selects the pin selected in the PINTSEL4 register as the source to bit slice 3.
 *  0b101..Input 5. Selects the pin selected in the PINTSEL5 register as the source to bit slice 3.
 *  0b110..Input 6. Selects the pin selected in the PINTSEL6 register as the source to bit slice 3.
 *  0b111..Input 7. Selects the pin selected in the PINTSEL7 register as the source to bit slice 3.
 */
#define PINT_PMSRC_SRC3(x)                       (((uint32_t)(((uint32_t)(x)) << PINT_PMSRC_SRC3_SHIFT)) & PINT_PMSRC_SRC3_MASK)

#define PINT_PMSRC_SRC4_MASK                     (0x700000U)
#define PINT_PMSRC_SRC4_SHIFT                    (20U)
/*! SRC4 - Selects the input source for bit slice 4
 *  0b000..Input 0. Selects the pin selected in the PINTSEL0 register as the source to bit slice 4.
 *  0b001..Input 1. Selects the pin selected in the PINTSEL1 register as the source to bit slice 4.
 *  0b010..Input 2. Selects the pin selected in the PINTSEL2 register as the source to bit slice 4.
 *  0b011..Input 3. Selects the pin selected in the PINTSEL3 register as the source to bit slice 4.
 *  0b100..Input 4. Selects the pin selected in the PINTSEL4 register as the source to bit slice 4.
 *  0b101..Input 5. Selects the pin selected in the PINTSEL5 register as the source to bit slice 4.
 *  0b110..Input 6. Selects the pin selected in the PINTSEL6 register as the source to bit slice 4.
 *  0b111..Input 7. Selects the pin selected in the PINTSEL7 register as the source to bit slice 4.
 */
#define PINT_PMSRC_SRC4(x)                       (((uint32_t)(((uint32_t)(x)) << PINT_PMSRC_SRC4_SHIFT)) & PINT_PMSRC_SRC4_MASK)

#define PINT_PMSRC_SRC5_MASK                     (0x3800000U)
#define PINT_PMSRC_SRC5_SHIFT                    (23U)
/*! SRC5 - Selects the input source for bit slice 5
 *  0b000..Input 0. Selects the pin selected in the PINTSEL0 register as the source to bit slice 5.
 *  0b001..Input 1. Selects the pin selected in the PINTSEL1 register as the source to bit slice 5.
 *  0b010..Input 2. Selects the pin selected in the PINTSEL2 register as the source to bit slice 5.
 *  0b011..Input 3. Selects the pin selected in the PINTSEL3 register as the source to bit slice 5.
 *  0b100..Input 4. Selects the pin selected in the PINTSEL4 register as the source to bit slice 5.
 *  0b101..Input 5. Selects the pin selected in the PINTSEL5 register as the source to bit slice 5.
 *  0b110..Input 6. Selects the pin selected in the PINTSEL6 register as the source to bit slice 5.
 *  0b111..Input 7. Selects the pin selected in the PINTSEL7 register as the source to bit slice 5.
 */
#define PINT_PMSRC_SRC5(x)                       (((uint32_t)(((uint32_t)(x)) << PINT_PMSRC_SRC5_SHIFT)) & PINT_PMSRC_SRC5_MASK)

#define PINT_PMSRC_SRC6_MASK                     (0x1C000000U)
#define PINT_PMSRC_SRC6_SHIFT                    (26U)
/*! SRC6 - Selects the input source for bit slice 6
 *  0b000..Input 0. Selects the pin selected in the PINTSEL0 register as the source to bit slice 6.
 *  0b001..Input 1. Selects the pin selected in the PINTSEL1 register as the source to bit slice 6.
 *  0b010..Input 2. Selects the pin selected in the PINTSEL2 register as the source to bit slice 6.
 *  0b011..Input 3. Selects the pin selected in the PINTSEL3 register as the source to bit slice 6.
 *  0b100..Input 4. Selects the pin selected in the PINTSEL4 register as the source to bit slice 6.
 *  0b101..Input 5. Selects the pin selected in the PINTSEL5 register as the source to bit slice 6.
 *  0b110..Input 6. Selects the pin selected in the PINTSEL6 register as the source to bit slice 6.
 *  0b111..Input 7. Selects the pin selected in the PINTSEL7 register as the source to bit slice 6.
 */
#define PINT_PMSRC_SRC6(x)                       (((uint32_t)(((uint32_t)(x)) << PINT_PMSRC_SRC6_SHIFT)) & PINT_PMSRC_SRC6_MASK)

#define PINT_PMSRC_SRC7_MASK                     (0xE0000000U)
#define PINT_PMSRC_SRC7_SHIFT                    (29U)
/*! SRC7 - Selects the input source for bit slice 7
 *  0b000..Input 0. Selects the pin selected in the PINTSEL0 register as the source to bit slice 7.
 *  0b001..Input 1. Selects the pin selected in the PINTSEL1 register as the source to bit slice 7.
 *  0b010..Input 2. Selects the pin selected in the PINTSEL2 register as the source to bit slice 7.
 *  0b011..Input 3. Selects the pin selected in the PINTSEL3 register as the source to bit slice 7.
 *  0b100..Input 4. Selects the pin selected in the PINTSEL4 register as the source to bit slice 7.
 *  0b101..Input 5. Selects the pin selected in the PINTSEL5 register as the source to bit slice 7.
 *  0b110..Input 6. Selects the pin selected in the PINTSEL6 register as the source to bit slice 7.
 *  0b111..Input 7. Selects the pin selected in the PINTSEL7 register as the source to bit slice 7.
 */
#define PINT_PMSRC_SRC7(x)                       (((uint32_t)(((uint32_t)(x)) << PINT_PMSRC_SRC7_SHIFT)) & PINT_PMSRC_SRC7_MASK)
/*! @} */

/*! @name PMCFG - Pattern match interrupt bit slice configuration register */
/*! @{ */

#define PINT_PMCFG_PROD_ENDPTS0_MASK             (0x1U)
#define PINT_PMCFG_PROD_ENDPTS0_SHIFT            (0U)
/*! PROD_ENDPTS0 - Determines whether slice 0 is an endpoint.
 *  0b0..No effect. Slice 0 is not an endpoint.
 *  0b1..endpoint. Slice 0 is the endpoint of a product term (minterm). Pin interrupt 0 in the NVIC is raised if the minterm evaluates as true.
 */
#define PINT_PMCFG_PROD_ENDPTS0(x)               (((uint32_t)(((uint32_t)(x)) << PINT_PMCFG_PROD_ENDPTS0_SHIFT)) & PINT_PMCFG_PROD_ENDPTS0_MASK)

#define PINT_PMCFG_PROD_ENDPTS1_MASK             (0x2U)
#define PINT_PMCFG_PROD_ENDPTS1_SHIFT            (1U)
/*! PROD_ENDPTS1 - Determines whether slice 1 is an endpoint.
 *  0b0..No effect. Slice 1 is not an endpoint.
 *  0b1..endpoint. Slice 1 is the endpoint of a product term (minterm). Pin interrupt 1 in the NVIC is raised if the minterm evaluates as true.
 */
#define PINT_PMCFG_PROD_ENDPTS1(x)               (((uint32_t)(((uint32_t)(x)) << PINT_PMCFG_PROD_ENDPTS1_SHIFT)) & PINT_PMCFG_PROD_ENDPTS1_MASK)

#define PINT_PMCFG_PROD_ENDPTS2_MASK             (0x4U)
#define PINT_PMCFG_PROD_ENDPTS2_SHIFT            (2U)
/*! PROD_ENDPTS2 - Determines whether slice 2 is an endpoint.
 *  0b0..No effect. Slice 2 is not an endpoint.
 *  0b1..endpoint. Slice 2 is the endpoint of a product term (minterm). Pin interrupt 2 in the NVIC is raised if the minterm evaluates as true.
 */
#define PINT_PMCFG_PROD_ENDPTS2(x)               (((uint32_t)(((uint32_t)(x)) << PINT_PMCFG_PROD_ENDPTS2_SHIFT)) & PINT_PMCFG_PROD_ENDPTS2_MASK)

#define PINT_PMCFG_PROD_ENDPTS3_MASK             (0x8U)
#define PINT_PMCFG_PROD_ENDPTS3_SHIFT            (3U)
/*! PROD_ENDPTS3 - Determines whether slice 3 is an endpoint.
 *  0b0..No effect. Slice 3 is not an endpoint.
 *  0b1..endpoint. Slice 3 is the endpoint of a product term (minterm). Pin interrupt 3 in the NVIC is raised if the minterm evaluates as true.
 */
#define PINT_PMCFG_PROD_ENDPTS3(x)               (((uint32_t)(((uint32_t)(x)) << PINT_PMCFG_PROD_ENDPTS3_SHIFT)) & PINT_PMCFG_PROD_ENDPTS3_MASK)

#define PINT_PMCFG_PROD_ENDPTS4_MASK             (0x10U)
#define PINT_PMCFG_PROD_ENDPTS4_SHIFT            (4U)
/*! PROD_ENDPTS4 - Determines whether slice 4 is an endpoint.
 *  0b0..No effect. Slice 4 is not an endpoint.
 *  0b1..endpoint. Slice 4 is the endpoint of a product term (minterm). Pin interrupt 4 in the NVIC is raised if the minterm evaluates as true.
 */
#define PINT_PMCFG_PROD_ENDPTS4(x)               (((uint32_t)(((uint32_t)(x)) << PINT_PMCFG_PROD_ENDPTS4_SHIFT)) & PINT_PMCFG_PROD_ENDPTS4_MASK)

#define PINT_PMCFG_PROD_ENDPTS5_MASK             (0x20U)
#define PINT_PMCFG_PROD_ENDPTS5_SHIFT            (5U)
/*! PROD_ENDPTS5 - Determines whether slice 5 is an endpoint.
 *  0b0..No effect. Slice 5 is not an endpoint.
 *  0b1..endpoint. Slice 5 is the endpoint of a product term (minterm). Pin interrupt 5 in the NVIC is raised if the minterm evaluates as true.
 */
#define PINT_PMCFG_PROD_ENDPTS5(x)               (((uint32_t)(((uint32_t)(x)) << PINT_PMCFG_PROD_ENDPTS5_SHIFT)) & PINT_PMCFG_PROD_ENDPTS5_MASK)

#define PINT_PMCFG_PROD_ENDPTS6_MASK             (0x40U)
#define PINT_PMCFG_PROD_ENDPTS6_SHIFT            (6U)
/*! PROD_ENDPTS6 - Determines whether slice 6 is an endpoint.
 *  0b0..No effect. Slice 6 is not an endpoint.
 *  0b1..endpoint. Slice 6 is the endpoint of a product term (minterm). Pin interrupt 6 in the NVIC is raised if the minterm evaluates as true.
 */
#define PINT_PMCFG_PROD_ENDPTS6(x)               (((uint32_t)(((uint32_t)(x)) << PINT_PMCFG_PROD_ENDPTS6_SHIFT)) & PINT_PMCFG_PROD_ENDPTS6_MASK)

#define PINT_PMCFG_CFG0_MASK                     (0x700U)
#define PINT_PMCFG_CFG0_SHIFT                    (8U)
/*! CFG0 - Specifies the match contribution condition for bit slice 0.
 *  0b000..Constant HIGH. This bit slice always contributes to a product term match.
 *  0b001..Sticky rising edge. Match occurs if a rising edge on the specified input has occurred since the last
 *         time the edge detection for this bit slice was cleared. This bit is only cleared when the PMCFG or the
 *         PMSRC registers are written to.
 *  0b010..Sticky falling edge. Match occurs if a falling edge on the specified input has occurred since the last
 *         time the edge detection for this bit slice was cleared. This bit is only cleared when the PMCFG or the
 *         PMSRC registers are written to.
 *  0b011..Sticky rising or falling edge. Match occurs if either a rising or falling edge on the specified input
 *         has occurred since the last time the edge detection for this bit slice was cleared. This bit is only
 *         cleared when the PMCFG or the PMSRC registers are written to.
 *  0b100..High level. Match (for this bit slice) occurs when there is a high level on the input specified for this bit slice in the PMSRC register.
 *  0b101..Low level. Match occurs when there is a low level on the specified input.
 *  0b110..Constant 0. This bit slice never contributes to a match (should be used to disable any unused bit slices).
 *  0b111..Event. Non-sticky rising or falling edge. Match occurs on an event - i.e. when either a rising or
 *         falling edge is first detected on the specified input (this is a non-sticky version of value 0x3) . This bit
 *         is cleared after one clock cycle.
 */
#define PINT_PMCFG_CFG0(x)                       (((uint32_t)(((uint32_t)(x)) << PINT_PMCFG_CFG0_SHIFT)) & PINT_PMCFG_CFG0_MASK)

#define PINT_PMCFG_CFG1_MASK                     (0x3800U)
#define PINT_PMCFG_CFG1_SHIFT                    (11U)
/*! CFG1 - Specifies the match contribution condition for bit slice 1.
 *  0b000..Constant HIGH. This bit slice always contributes to a product term match.
 *  0b001..Sticky rising edge. Match occurs if a rising edge on the specified input has occurred since the last
 *         time the edge detection for this bit slice was cleared. This bit is only cleared when the PMCFG or the
 *         PMSRC registers are written to.
 *  0b010..Sticky falling edge. Match occurs if a falling edge on the specified input has occurred since the last
 *         time the edge detection for this bit slice was cleared. This bit is only cleared when the PMCFG or the
 *         PMSRC registers are written to.
 *  0b011..Sticky rising or falling edge. Match occurs if either a rising or falling edge on the specified input
 *         has occurred since the last time the edge detection for this bit slice was cleared. This bit is only
 *         cleared when the PMCFG or the PMSRC registers are written to.
 *  0b100..High level. Match (for this bit slice) occurs when there is a high level on the input specified for this bit slice in the PMSRC register.
 *  0b101..Low level. Match occurs when there is a low level on the specified input.
 *  0b110..Constant 0. This bit slice never contributes to a match (should be used to disable any unused bit slices).
 *  0b111..Event. Non-sticky rising or falling edge. Match occurs on an event - i.e. when either a rising or
 *         falling edge is first detected on the specified input (this is a non-sticky version of value 0x3) . This bit
 *         is cleared after one clock cycle.
 */
#define PINT_PMCFG_CFG1(x)                       (((uint32_t)(((uint32_t)(x)) << PINT_PMCFG_CFG1_SHIFT)) & PINT_PMCFG_CFG1_MASK)

#define PINT_PMCFG_CFG2_MASK                     (0x1C000U)
#define PINT_PMCFG_CFG2_SHIFT                    (14U)
/*! CFG2 - Specifies the match contribution condition for bit slice 2.
 *  0b000..Constant HIGH. This bit slice always contributes to a product term match.
 *  0b001..Sticky rising edge. Match occurs if a rising edge on the specified input has occurred since the last
 *         time the edge detection for this bit slice was cleared. This bit is only cleared when the PMCFG or the
 *         PMSRC registers are written to.
 *  0b010..Sticky falling edge. Match occurs if a falling edge on the specified input has occurred since the last
 *         time the edge detection for this bit slice was cleared. This bit is only cleared when the PMCFG or the
 *         PMSRC registers are written to.
 *  0b011..Sticky rising or falling edge. Match occurs if either a rising or falling edge on the specified input
 *         has occurred since the last time the edge detection for this bit slice was cleared. This bit is only
 *         cleared when the PMCFG or the PMSRC registers are written to.
 *  0b100..High level. Match (for this bit slice) occurs when there is a high level on the input specified for this bit slice in the PMSRC register.
 *  0b101..Low level. Match occurs when there is a low level on the specified input.
 *  0b110..Constant 0. This bit slice never contributes to a match (should be used to disable any unused bit slices).
 *  0b111..Event. Non-sticky rising or falling edge. Match occurs on an event - i.e. when either a rising or
 *         falling edge is first detected on the specified input (this is a non-sticky version of value 0x3) . This bit
 *         is cleared after one clock cycle.
 */
#define PINT_PMCFG_CFG2(x)                       (((uint32_t)(((uint32_t)(x)) << PINT_PMCFG_CFG2_SHIFT)) & PINT_PMCFG_CFG2_MASK)

#define PINT_PMCFG_CFG3_MASK                     (0xE0000U)
#define PINT_PMCFG_CFG3_SHIFT                    (17U)
/*! CFG3 - Specifies the match contribution condition for bit slice 3.
 *  0b000..Constant HIGH. This bit slice always contributes to a product term match.
 *  0b001..Sticky rising edge. Match occurs if a rising edge on the specified input has occurred since the last
 *         time the edge detection for this bit slice was cleared. This bit is only cleared when the PMCFG or the
 *         PMSRC registers are written to.
 *  0b010..Sticky falling edge. Match occurs if a falling edge on the specified input has occurred since the last
 *         time the edge detection for this bit slice was cleared. This bit is only cleared when the PMCFG or the
 *         PMSRC registers are written to.
 *  0b011..Sticky rising or falling edge. Match occurs if either a rising or falling edge on the specified input
 *         has occurred since the last time the edge detection for this bit slice was cleared. This bit is only
 *         cleared when the PMCFG or the PMSRC registers are written to.
 *  0b100..High level. Match (for this bit slice) occurs when there is a high level on the input specified for this bit slice in the PMSRC register.
 *  0b101..Low level. Match occurs when there is a low level on the specified input.
 *  0b110..Constant 0. This bit slice never contributes to a match (should be used to disable any unused bit slices).
 *  0b111..Event. Non-sticky rising or falling edge. Match occurs on an event - i.e. when either a rising or
 *         falling edge is first detected on the specified input (this is a non-sticky version of value 0x3) . This bit
 *         is cleared after one clock cycle.
 */
#define PINT_PMCFG_CFG3(x)                       (((uint32_t)(((uint32_t)(x)) << PINT_PMCFG_CFG3_SHIFT)) & PINT_PMCFG_CFG3_MASK)

#define PINT_PMCFG_CFG4_MASK                     (0x700000U)
#define PINT_PMCFG_CFG4_SHIFT                    (20U)
/*! CFG4 - Specifies the match contribution condition for bit slice 4.
 *  0b000..Constant HIGH. This bit slice always contributes to a product term match.
 *  0b001..Sticky rising edge. Match occurs if a rising edge on the specified input has occurred since the last
 *         time the edge detection for this bit slice was cleared. This bit is only cleared when the PMCFG or the
 *         PMSRC registers are written to.
 *  0b010..Sticky falling edge. Match occurs if a falling edge on the specified input has occurred since the last
 *         time the edge detection for this bit slice was cleared. This bit is only cleared when the PMCFG or the
 *         PMSRC registers are written to.
 *  0b011..Sticky rising or falling edge. Match occurs if either a rising or falling edge on the specified input
 *         has occurred since the last time the edge detection for this bit slice was cleared. This bit is only
 *         cleared when the PMCFG or the PMSRC registers are written to.
 *  0b100..High level. Match (for this bit slice) occurs when there is a high level on the input specified for this bit slice in the PMSRC register.
 *  0b101..Low level. Match occurs when there is a low level on the specified input.
 *  0b110..Constant 0. This bit slice never contributes to a match (should be used to disable any unused bit slices).
 *  0b111..Event. Non-sticky rising or falling edge. Match occurs on an event - i.e. when either a rising or
 *         falling edge is first detected on the specified input (this is a non-sticky version of value 0x3) . This bit
 *         is cleared after one clock cycle.
 */
#define PINT_PMCFG_CFG4(x)                       (((uint32_t)(((uint32_t)(x)) << PINT_PMCFG_CFG4_SHIFT)) & PINT_PMCFG_CFG4_MASK)

#define PINT_PMCFG_CFG5_MASK                     (0x3800000U)
#define PINT_PMCFG_CFG5_SHIFT                    (23U)
/*! CFG5 - Specifies the match contribution condition for bit slice 5.
 *  0b000..Constant HIGH. This bit slice always contributes to a product term match.
 *  0b001..Sticky rising edge. Match occurs if a rising edge on the specified input has occurred since the last
 *         time the edge detection for this bit slice was cleared. This bit is only cleared when the PMCFG or the
 *         PMSRC registers are written to.
 *  0b010..Sticky falling edge. Match occurs if a falling edge on the specified input has occurred since the last
 *         time the edge detection for this bit slice was cleared. This bit is only cleared when the PMCFG or the
 *         PMSRC registers are written to.
 *  0b011..Sticky rising or falling edge. Match occurs if either a rising or falling edge on the specified input
 *         has occurred since the last time the edge detection for this bit slice was cleared. This bit is only
 *         cleared when the PMCFG or the PMSRC registers are written to.
 *  0b100..High level. Match (for this bit slice) occurs when there is a high level on the input specified for this bit slice in the PMSRC register.
 *  0b101..Low level. Match occurs when there is a low level on the specified input.
 *  0b110..Constant 0. This bit slice never contributes to a match (should be used to disable any unused bit slices).
 *  0b111..Event. Non-sticky rising or falling edge. Match occurs on an event - i.e. when either a rising or
 *         falling edge is first detected on the specified input (this is a non-sticky version of value 0x3) . This bit
 *         is cleared after one clock cycle.
 */
#define PINT_PMCFG_CFG5(x)                       (((uint32_t)(((uint32_t)(x)) << PINT_PMCFG_CFG5_SHIFT)) & PINT_PMCFG_CFG5_MASK)

#define PINT_PMCFG_CFG6_MASK                     (0x1C000000U)
#define PINT_PMCFG_CFG6_SHIFT                    (26U)
/*! CFG6 - Specifies the match contribution condition for bit slice 6.
 *  0b000..Constant HIGH. This bit slice always contributes to a product term match.
 *  0b001..Sticky rising edge. Match occurs if a rising edge on the specified input has occurred since the last
 *         time the edge detection for this bit slice was cleared. This bit is only cleared when the PMCFG or the
 *         PMSRC registers are written to.
 *  0b010..Sticky falling edge. Match occurs if a falling edge on the specified input has occurred since the last
 *         time the edge detection for this bit slice was cleared. This bit is only cleared when the PMCFG or the
 *         PMSRC registers are written to.
 *  0b011..Sticky rising or falling edge. Match occurs if either a rising or falling edge on the specified input
 *         has occurred since the last time the edge detection for this bit slice was cleared. This bit is only
 *         cleared when the PMCFG or the PMSRC registers are written to.
 *  0b100..High level. Match (for this bit slice) occurs when there is a high level on the input specified for this bit slice in the PMSRC register.
 *  0b101..Low level. Match occurs when there is a low level on the specified input.
 *  0b110..Constant 0. This bit slice never contributes to a match (should be used to disable any unused bit slices).
 *  0b111..Event. Non-sticky rising or falling edge. Match occurs on an event - i.e. when either a rising or
 *         falling edge is first detected on the specified input (this is a non-sticky version of value 0x3) . This bit
 *         is cleared after one clock cycle.
 */
#define PINT_PMCFG_CFG6(x)                       (((uint32_t)(((uint32_t)(x)) << PINT_PMCFG_CFG6_SHIFT)) & PINT_PMCFG_CFG6_MASK)

#define PINT_PMCFG_CFG7_MASK                     (0xE0000000U)
#define PINT_PMCFG_CFG7_SHIFT                    (29U)
/*! CFG7 - Specifies the match contribution condition for bit slice 7.
 *  0b000..Constant HIGH. This bit slice always contributes to a product term match.
 *  0b001..Sticky rising edge. Match occurs if a rising edge on the specified input has occurred since the last
 *         time the edge detection for this bit slice was cleared. This bit is only cleared when the PMCFG or the
 *         PMSRC registers are written to.
 *  0b010..Sticky falling edge. Match occurs if a falling edge on the specified input has occurred since the last
 *         time the edge detection for this bit slice was cleared. This bit is only cleared when the PMCFG or the
 *         PMSRC registers are written to.
 *  0b011..Sticky rising or falling edge. Match occurs if either a rising or falling edge on the specified input
 *         has occurred since the last time the edge detection for this bit slice was cleared. This bit is only
 *         cleared when the PMCFG or the PMSRC registers are written to.
 *  0b100..High level. Match (for this bit slice) occurs when there is a high level on the input specified for this bit slice in the PMSRC register.
 *  0b101..Low level. Match occurs when there is a low level on the specified input.
 *  0b110..Constant 0. This bit slice never contributes to a match (should be used to disable any unused bit slices).
 *  0b111..Event. Non-sticky rising or falling edge. Match occurs on an event - i.e. when either a rising or
 *         falling edge is first detected on the specified input (this is a non-sticky version of value 0x3) . This bit
 *         is cleared after one clock cycle.
 */
#define PINT_PMCFG_CFG7(x)                       (((uint32_t)(((uint32_t)(x)) << PINT_PMCFG_CFG7_SHIFT)) & PINT_PMCFG_CFG7_MASK)
/*! @} */


/*!
 * @}
 */ /* end of group PINT_Register_Masks */


/*!
 * @}
 */ /* end of group PINT_Peripheral_Access_Layer */


/*
** End of section using anonymous unions
*/

#if defined(__ARMCC_VERSION)
  #if (__ARMCC_VERSION >= 6010050)
    #pragma clang diagnostic pop
  #else
    #pragma pop
  #endif
#elif defined(__GNUC__)
  /* leave anonymous unions enabled */
#elif defined(__IAR_SYSTEMS_ICC__)
  #pragma language=default
#else
  #error Not supported compiler type
#endif

/*!
 * @}
 */ /* end of group Peripheral_access_layer */


#endif  /* PINT_H_ */
