spyadrian/digital-scale-pcb-firmware/firmware/device/LPC804_COMMON.h

/*
** ###################################################################
**     Processors:          LPC804M101JDH20
**                          LPC804M101JDH24
**                          LPC804M101JHI33
**                          LPC804M111JDH24
**                          LPC804UK
**
**     Compilers:           GNU C Compiler
**                          IAR ANSI C/C++ Compiler for ARM
**                          Keil ARM C/C++ Compiler
**                          MCUXpresso Compiler
**
**     Reference manual:    LPC804 User manual Rev.1.0  24 Jan 2018
**     Version:             rev. 1.0, 2018-01-09
**     Build:               b240704
**
**     Abstract:
**         CMSIS Peripheral Access Layer for LPC804
**
**     Copyright 1997-2016 Freescale Semiconductor, Inc.
**     Copyright 2016-2024 NXP
**     SPDX-License-Identifier: BSD-3-Clause
**
**     http:                 www.nxp.com
**     mail:                 support@nxp.com
**
**     Revisions:
**     - rev. 1.0 (2018-01-09)
**         Initial version.
**
** ###################################################################
*/

/*!
 * @file LPC804_COMMON.h
 * @version 1.0
 * @date 2018-01-09
 * @brief CMSIS Peripheral Access Layer for LPC804
 *
 * CMSIS Peripheral Access Layer for LPC804
 */

#if !defined(LPC804_COMMON_H_)
#define LPC804_COMMON_H_                         /**< Symbol preventing repeated inclusion */

/** Memory map major version (memory maps with equal major version number are
 * compatible) */
#define MCU_MEM_MAP_VERSION 0x0100U
/** Memory map minor version */
#define MCU_MEM_MAP_VERSION_MINOR 0x0000U


/* ----------------------------------------------------------------------------
   -- Interrupt vector numbers
   ---------------------------------------------------------------------------- */

/*!
 * @addtogroup Interrupt_vector_numbers Interrupt vector numbers
 * @{
 */

/** Interrupt Number Definitions */
#define NUMBER_OF_INT_VECTORS 48                 /**< Number of interrupts in the Vector table */

typedef enum IRQn {
  /* Auxiliary constants */
  NotAvail_IRQn                = -128,             /**< Not available device specific interrupt */

  /* Core interrupts */
  NonMaskableInt_IRQn          = -14,              /**< Non Maskable Interrupt */
  HardFault_IRQn               = -13,              /**< Cortex-M0 SV Hard Fault Interrupt */
  SVCall_IRQn                  = -5,               /**< Cortex-M0 SV Call Interrupt */
  PendSV_IRQn                  = -2,               /**< Cortex-M0 Pend SV Interrupt */
  SysTick_IRQn                 = -1,               /**< Cortex-M0 System Tick Interrupt */

  /* Device specific interrupts */
  SPI0_IRQn                    = 0,                /**< SPI0 interrupt */
  Reserved17_IRQn              = 1,                /**< Reserved interrupt */
  DAC0_IRQn                    = 2,                /**< DAC0 interrupt */
  USART0_IRQn                  = 3,                /**< USART0 interrupt */
  USART1_IRQn                  = 4,                /**< USART1 interrupt */
  Reserved21_IRQn              = 5,                /**< Reserved interrupt */
  Reserved22_IRQn              = 6,                /**< Reserved interrupt */
  I2C1_IRQn                    = 7,                /**< I2C1 interrupt */
  I2C0_IRQn                    = 8,                /**< I2C0 interrupt */
  Reserved25_IRQn              = 9,                /**< Reserved interrupt */
  MRT0_IRQn                    = 10,               /**< Multi-rate timer interrupt */
  CMP_CAPT_IRQn                = 11,               /**< Analog comparator interrupt or Capacitive Touch interrupt */
  WDT_IRQn                     = 12,               /**< Windowed watchdog timer interrupt */
  BOD_IRQn                     = 13,               /**< BOD interrupts */
  FLASH_IRQn                   = 14,               /**< flash interrupt */
  WKT_IRQn                     = 15,               /**< Self-wake-up timer interrupt */
  ADC_SEQA_IRQn                = 16,               /**< ADC sequence A completion. */
  ADC_SEQB_IRQn                = 17,               /**< ADC sequence B completion. */
  ADC_THCMP_IRQn               = 18,               /**< ADC threshold compare and error. */
  ADC_OVR_IRQn                 = 19,               /**< ADC overrun */
  Reserved36_IRQn              = 20,               /**< Reserved interrupt */
  Reserved37_IRQn              = 21,               /**< Reserved interrupt */
  Reserved38_IRQn              = 22,               /**< Reserved interrupt */
  CTIMER0_IRQn                 = 23,               /**< Timer interrupt */
  PIN_INT0_IRQn                = 24,               /**< Pin interrupt 0 or pattern match engine slice 0 interrupt */
  PIN_INT1_IRQn                = 25,               /**< Pin interrupt 1 or pattern match engine slice 1 interrupt */
  PIN_INT2_IRQn                = 26,               /**< Pin interrupt 2 or pattern match engine slice 2 interrupt */
  PIN_INT3_IRQn                = 27,               /**< Pin interrupt 3 or pattern match engine slice 3 interrupt */
  PIN_INT4_IRQn                = 28,               /**< Pin interrupt 4 or pattern match engine slice 4 interrupt */
  PIN_INT5_IRQn                = 29,               /**< Pin interrupt 5 or pattern match engine slice 5 interrupt */
  PIN_INT6_IRQn                = 30,               /**< Pin interrupt 6 or pattern match engine slice 6 interrupt */
  PIN_INT7_IRQn                = 31                /**< Pin interrupt 7 or pattern match engine slice 7 interrupt */
} IRQn_Type;

/*!
 * @}
 */ /* end of group Interrupt_vector_numbers */


/* ----------------------------------------------------------------------------
   -- Cortex M0 Core Configuration
   ---------------------------------------------------------------------------- */

/*!
 * @addtogroup Cortex_Core_Configuration Cortex M0 Core Configuration
 * @{
 */

#define __CM0PLUS_REV                  0x0000    /**< Core revision r0p0 */
#define __MPU_PRESENT                  0         /**< Defines if an MPU is present or not */
#define __VTOR_PRESENT                 1         /**< Defines if VTOR is present or not */
#define __NVIC_PRIO_BITS               2         /**< Number of priority bits implemented in the NVIC */
#define __Vendor_SysTickConfig         0         /**< Vendor specific implementation of SysTickConfig is defined */

#include "core_cm0plus.h"              /* Core Peripheral Access Layer */
#include "system_LPC804.h"             /* Device specific configuration file */

#define LPC804_SERIES
/* CPU specific feature definitions */
#include "LPC804_features.h"

/*!
 * @}
 */ /* end of group Cortex_Core_Configuration */


/* ACOMP - Peripheral instance base addresses */
/** Peripheral ACOMP base address */
#define ACOMP_BASE                               (0x40024000u)
/** Peripheral ACOMP base pointer */
#define ACOMP                                    ((ACOMP_Type *)ACOMP_BASE)
/** Array initializer of ACOMP peripheral base addresses */
#define ACOMP_BASE_ADDRS                         { ACOMP_BASE }
/** Array initializer of ACOMP peripheral base pointers */
#define ACOMP_BASE_PTRS                          { ACOMP }

/* ADC - Peripheral instance base addresses */
/** Peripheral ADC base address */
#define ADC_BASE                                 (0x4001C000u)
/** Peripheral ADC base pointer */
#define ADC                                      ((ADC_Type *)ADC_BASE)
/** Array initializer of ADC peripheral base addresses */
#define ADC_BASE_ADDRS                           { ADC_BASE }
/** Array initializer of ADC peripheral base pointers */
#define ADC_BASE_PTRS                            { ADC }
/** Interrupt vectors for the ADC peripheral type */
#define ADC_SEQ_IRQS                             { ADC_SEQA_IRQn, ADC_SEQB_IRQn }
#define ADC_THCMP_IRQS                           { ADC_THCMP_IRQn }

/* CAPT - Peripheral instance base addresses */
/** Peripheral CAPT base address */
#define CAPT_BASE                                (0x40060000u)
/** Peripheral CAPT base pointer */
#define CAPT                                     ((CAPT_Type *)CAPT_BASE)
/** Array initializer of CAPT peripheral base addresses */
#define CAPT_BASE_ADDRS                          { CAPT_BASE }
/** Array initializer of CAPT peripheral base pointers */
#define CAPT_BASE_PTRS                           { CAPT }
/** Interrupt vectors for the CAPT peripheral type */
#define CAPT_IRQS                                { CMP_CAPT_IRQn }

/* CRC - Peripheral instance base addresses */
/** Peripheral CRC base address */
#define CRC_BASE                                 (0x50000000u)
/** Peripheral CRC base pointer */
#define CRC                                      ((CRC_Type *)CRC_BASE)
/** Array initializer of CRC peripheral base addresses */
#define CRC_BASE_ADDRS                           { CRC_BASE }
/** Array initializer of CRC peripheral base pointers */
#define CRC_BASE_PTRS                            { CRC }

/* CTIMER - Peripheral instance base addresses */
/** Peripheral CTIMER0 base address */
#define CTIMER0_BASE                             (0x40038000u)
/** Peripheral CTIMER0 base pointer */
#define CTIMER0                                  ((CTIMER_Type *)CTIMER0_BASE)
/** Array initializer of CTIMER peripheral base addresses */
#define CTIMER_BASE_ADDRS                        { CTIMER0_BASE }
/** Array initializer of CTIMER peripheral base pointers */
#define CTIMER_BASE_PTRS                         { CTIMER0 }
/** Interrupt vectors for the CTIMER peripheral type */
#define CTIMER_IRQS                              { CTIMER0_IRQn }

/* DAC - Peripheral instance base addresses */
/** Peripheral DAC0 base address */
#define DAC0_BASE                                (0x40014000u)
/** Peripheral DAC0 base pointer */
#define DAC0                                     ((DAC_Type *)DAC0_BASE)
/** Array initializer of DAC peripheral base addresses */
#define DAC_BASE_ADDRS                           { DAC0_BASE }
/** Array initializer of DAC peripheral base pointers */
#define DAC_BASE_PTRS                            { DAC0 }

/* GPIO - Peripheral instance base addresses */
/** Peripheral GPIO base address */
#define GPIO_BASE                                (0xA0000000u)
/** Peripheral GPIO base pointer */
#define GPIO                                     ((GPIO_Type *)GPIO_BASE)
/** Array initializer of GPIO peripheral base addresses */
#define GPIO_BASE_ADDRS                          { GPIO_BASE }
/** Array initializer of GPIO peripheral base pointers */
#define GPIO_BASE_PTRS                           { GPIO }

/* I2C - Peripheral instance base addresses */
/** Peripheral I2C0 base address */
#define I2C0_BASE                                (0x40050000u)
/** Peripheral I2C0 base pointer */
#define I2C0                                     ((I2C_Type *)I2C0_BASE)
/** Peripheral I2C1 base address */
#define I2C1_BASE                                (0x40054000u)
/** Peripheral I2C1 base pointer */
#define I2C1                                     ((I2C_Type *)I2C1_BASE)
/** Array initializer of I2C peripheral base addresses */
#define I2C_BASE_ADDRS                           { I2C0_BASE, I2C1_BASE }
/** Array initializer of I2C peripheral base pointers */
#define I2C_BASE_PTRS                            { I2C0, I2C1 }
/** Interrupt vectors for the I2C peripheral type */
#define I2C_IRQS                                 { I2C0_IRQn, I2C1_IRQn }

/* IOCON - Peripheral instance base addresses */
/** Peripheral IOCON base address */
#define IOCON_BASE                               (0x40044000u)
/** Peripheral IOCON base pointer */
#define IOCON                                    ((IOCON_Type *)IOCON_BASE)
/** Array initializer of IOCON peripheral base addresses */
#define IOCON_BASE_ADDRS                         { IOCON_BASE }
/** Array initializer of IOCON peripheral base pointers */
#define IOCON_BASE_PTRS                          { IOCON }

/* MRT - Peripheral instance base addresses */
/** Peripheral MRT0 base address */
#define MRT0_BASE                                (0x40004000u)
/** Peripheral MRT0 base pointer */
#define MRT0                                     ((MRT_Type *)MRT0_BASE)
/** Array initializer of MRT peripheral base addresses */
#define MRT_BASE_ADDRS                           { MRT0_BASE }
/** Array initializer of MRT peripheral base pointers */
#define MRT_BASE_PTRS                            { MRT0 }
/** Interrupt vectors for the MRT peripheral type */
#define MRT_IRQS                                 { MRT0_IRQn }

/* PINT - Peripheral instance base addresses */
/** Peripheral PINT base address */
#define PINT_BASE                                (0xA0004000u)
/** Peripheral PINT base pointer */
#define PINT                                     ((PINT_Type *)PINT_BASE)
/** Array initializer of PINT peripheral base addresses */
#define PINT_BASE_ADDRS                          { PINT_BASE }
/** Array initializer of PINT peripheral base pointers */
#define PINT_BASE_PTRS                           { PINT }
/** Interrupt vectors for the PINT peripheral type */
#define PINT_IRQS                                { PIN_INT0_IRQn, PIN_INT1_IRQn, PIN_INT2_IRQn, PIN_INT3_IRQn, PIN_INT4_IRQn, PIN_INT5_IRQn, PIN_INT6_IRQn, PIN_INT7_IRQn }

/* PLU - Peripheral instance base addresses */
/** Peripheral PLU base address */
#define PLU_BASE                                 (0x40028000u)
/** Peripheral PLU base pointer */
#define PLU                                      ((PLU_Type *)PLU_BASE)
/** Array initializer of PLU peripheral base addresses */
#define PLU_BASE_ADDRS                           { PLU_BASE }
/** Array initializer of PLU peripheral base pointers */
#define PLU_BASE_PTRS                            { PLU }

/* PMU - Peripheral instance base addresses */
/** Peripheral PMU base address */
#define PMU_BASE                                 (0x40020000u)
/** Peripheral PMU base pointer */
#define PMU                                      ((PMU_Type *)PMU_BASE)
/** Array initializer of PMU peripheral base addresses */
#define PMU_BASE_ADDRS                           { PMU_BASE }
/** Array initializer of PMU peripheral base pointers */
#define PMU_BASE_PTRS                            { PMU }

/* SPI - Peripheral instance base addresses */
/** Peripheral SPI0 base address */
#define SPI0_BASE                                (0x40058000u)
/** Peripheral SPI0 base pointer */
#define SPI0                                     ((SPI_Type *)SPI0_BASE)
/** Array initializer of SPI peripheral base addresses */
#define SPI_BASE_ADDRS                           { SPI0_BASE }
/** Array initializer of SPI peripheral base pointers */
#define SPI_BASE_PTRS                            { SPI0 }
/** Interrupt vectors for the SPI peripheral type */
#define SPI_IRQS                                 { SPI0_IRQn }

/* SWM - Peripheral instance base addresses */
/** Peripheral SWM0 base address */
#define SWM0_BASE                                (0x4000C000u)
/** Peripheral SWM0 base pointer */
#define SWM0                                     ((SWM_Type *)SWM0_BASE)
/** Array initializer of SWM peripheral base addresses */
#define SWM_BASE_ADDRS                           { SWM0_BASE }
/** Array initializer of SWM peripheral base pointers */
#define SWM_BASE_PTRS                            { SWM0 }

/* SYSCON - Peripheral instance base addresses */
/** Peripheral SYSCON base address */
#define SYSCON_BASE                              (0x40048000u)
/** Peripheral SYSCON base pointer */
#define SYSCON                                   ((SYSCON_Type *)SYSCON_BASE)
/** Array initializer of SYSCON peripheral base addresses */
#define SYSCON_BASE_ADDRS                        { SYSCON_BASE }
/** Array initializer of SYSCON peripheral base pointers */
#define SYSCON_BASE_PTRS                         { SYSCON }

/* USART - Peripheral instance base addresses */
/** Peripheral USART0 base address */
#define USART0_BASE                              (0x40064000u)
/** Peripheral USART0 base pointer */
#define USART0                                   ((USART_Type *)USART0_BASE)
/** Peripheral USART1 base address */
#define USART1_BASE                              (0x40068000u)
/** Peripheral USART1 base pointer */
#define USART1                                   ((USART_Type *)USART1_BASE)
/** Array initializer of USART peripheral base addresses */
#define USART_BASE_ADDRS                         { USART0_BASE, USART1_BASE }
/** Array initializer of USART peripheral base pointers */
#define USART_BASE_PTRS                          { USART0, USART1 }
/** Interrupt vectors for the USART peripheral type */
#define USART_IRQS                               { USART0_IRQn, USART1_IRQn }

/* WKT - Peripheral instance base addresses */
/** Peripheral WKT base address */
#define WKT_BASE                                 (0x40008000u)
/** Peripheral WKT base pointer */
#define WKT                                      ((WKT_Type *)WKT_BASE)
/** Array initializer of WKT peripheral base addresses */
#define WKT_BASE_ADDRS                           { WKT_BASE }
/** Array initializer of WKT peripheral base pointers */
#define WKT_BASE_PTRS                            { WKT }
/** Interrupt vectors for the WKT peripheral type */
#define WKT_IRQS                                 { WKT_IRQn }

/* WWDT - Peripheral instance base addresses */
/** Peripheral WWDT base address */
#define WWDT_BASE                                (0x40000000u)
/** Peripheral WWDT base pointer */
#define WWDT                                     ((WWDT_Type *)WWDT_BASE)
/** Array initializer of WWDT peripheral base addresses */
#define WWDT_BASE_ADDRS                          { WWDT_BASE }
/** Array initializer of WWDT peripheral base pointers */
#define WWDT_BASE_PTRS                           { WWDT }
/** Interrupt vectors for the WWDT peripheral type */
#define WWDT_IRQS                                { WDT_IRQn }

/* ----------------------------------------------------------------------------
   -- Macros for use with bit field definitions (xxx_SHIFT, xxx_MASK).
   ---------------------------------------------------------------------------- */

/*!
 * @addtogroup Bit_Field_Generic_Macros Macros for use with bit field definitions (xxx_SHIFT, xxx_MASK).
 * @{
 */

#if defined(__ARMCC_VERSION)
  #if (__ARMCC_VERSION >= 6010050)
    #pragma clang system_header
  #endif
#elif defined(__IAR_SYSTEMS_ICC__)
  #pragma system_include
#endif

/**
 * @brief Mask and left-shift a bit field value for use in a register bit range.
 * @param field Name of the register bit field.
 * @param value Value of the bit field.
 * @return Masked and shifted value.
 */
#define NXP_VAL2FLD(field, value)    (((value) << (field ## _SHIFT)) & (field ## _MASK))
/**
 * @brief Mask and right-shift a register value to extract a bit field value.
 * @param field Name of the register bit field.
 * @param value Value of the register.
 * @return Masked and shifted bit field value.
 */
#define NXP_FLD2VAL(field, value)    (((value) & (field ## _MASK)) >> (field ## _SHIFT))

/*!
 * @}
 */ /* end of group Bit_Field_Generic_Macros */


/* ----------------------------------------------------------------------------
   -- SDK Compatibility
   ---------------------------------------------------------------------------- */

/*!
 * @addtogroup SDK_Compatibility_Symbols SDK Compatibility
 * @{
 */

/* No SDK compatibility issues. */

/*!
 * @}
 */ /* end of group SDK_Compatibility_Symbols */


#endif  /* LPC804_COMMON_H_ */
