spyadrian/digital-scale-pcb-firmware/firmware/device/periph5/PERI_ADC.h

/*
** ###################################################################
**     Processors:          LPC804M101JDH20
**                          LPC804M101JDH24
**                          LPC804M101JHI33
**                          LPC804M111JDH24
**                          LPC804UK
**
**     Version:             rev. 1.0, 2018-01-09
**     Build:               b240704
**
**     Abstract:
**         CMSIS Peripheral Access Layer for ADC
**
**     Copyright 1997-2016 Freescale Semiconductor, Inc.
**     Copyright 2016-2024 NXP
**     SPDX-License-Identifier: BSD-3-Clause
**
**     http:                 www.nxp.com
**     mail:                 support@nxp.com
**
**     Revisions:
**     - rev. 1.0 (2018-01-09)
**         Initial version.
**
** ###################################################################
*/

/*!
 * @file ADC.h
 * @version 1.0
 * @date 2018-01-09
 * @brief CMSIS Peripheral Access Layer for ADC
 *
 * CMSIS Peripheral Access Layer for ADC
 */

#if !defined(ADC_H_)
#define ADC_H_                                   /**< Symbol preventing repeated inclusion */

#if (defined(CPU_LPC804M101JDH20) || defined(CPU_LPC804M101JDH24) || defined(CPU_LPC804M101JHI33) || defined(CPU_LPC804M111JDH24) || defined(CPU_LPC804UK))
#include "LPC804_COMMON.h"
#else
  #error "No valid CPU defined!"
#endif

/* ----------------------------------------------------------------------------
   -- Device Peripheral Access Layer
   ---------------------------------------------------------------------------- */

/*!
 * @addtogroup Peripheral_access_layer Device Peripheral Access Layer
 * @{
 */


/*
** Start of section using anonymous unions
*/

#if defined(__ARMCC_VERSION)
  #if (__ARMCC_VERSION >= 6010050)
    #pragma clang diagnostic push
  #else
    #pragma push
    #pragma anon_unions
  #endif
#elif defined(__GNUC__)
  /* anonymous unions are enabled by default */
#elif defined(__IAR_SYSTEMS_ICC__)
  #pragma language=extended
#else
  #error Not supported compiler type
#endif

/* ----------------------------------------------------------------------------
   -- ADC Peripheral Access Layer
   ---------------------------------------------------------------------------- */

/*!
 * @addtogroup ADC_Peripheral_Access_Layer ADC Peripheral Access Layer
 * @{
 */

/** ADC - Size of Registers Arrays */
#define ADC_SEQ_CTRL_COUNT                        2u
#define ADC_SEQ_GDAT_COUNT                        2u
#define ADC_DAT_COUNT                             12u

/** ADC - Register Layout Typedef */
typedef struct {
  __IO uint32_t CTRL;                              /**< ADC Control register. Contains the clock divide value, resolution selection, sampling time selection, and mode controls., offset: 0x0 */
       uint8_t RESERVED_0[4];
  __IO uint32_t SEQ_CTRL[ADC_SEQ_CTRL_COUNT];      /**< ADC Conversion Sequence-n control register: Controls triggering and channel selection for conversion sequence-n. Also specifies interrupt mode for sequence-n., array offset: 0x8, array step: 0x4 */
  __I  uint32_t SEQ_GDAT[ADC_SEQ_GDAT_COUNT];      /**< ADC Sequence-n Global Data register. This register contains the result of the most recent ADC conversion performed under sequence-n., array offset: 0x10, array step: 0x4 */
       uint8_t RESERVED_1[8];
  __I  uint32_t DAT[ADC_DAT_COUNT];                /**< ADC Channel N Data register. This register contains the result of the most recent conversion completed on channel N., array offset: 0x20, array step: 0x4 */
  __IO uint32_t THR0_LOW;                          /**< ADC Low Compare Threshold register 0: Contains the lower threshold level for automatic threshold comparison for any channels linked to threshold pair 0., offset: 0x50 */
  __IO uint32_t THR1_LOW;                          /**< ADC Low Compare Threshold register 1: Contains the lower threshold level for automatic threshold comparison for any channels linked to threshold pair 1., offset: 0x54 */
  __IO uint32_t THR0_HIGH;                         /**< ADC High Compare Threshold register 0: Contains the upper threshold level for automatic threshold comparison for any channels linked to threshold pair 0., offset: 0x58 */
  __IO uint32_t THR1_HIGH;                         /**< ADC High Compare Threshold register 1: Contains the upper threshold level for automatic threshold comparison for any channels linked to threshold pair 1., offset: 0x5C */
  __IO uint32_t CHAN_THRSEL;                       /**< ADC Channel-Threshold Select register. Specifies which set of threshold compare registers are to be used for each channel, offset: 0x60 */
  __IO uint32_t INTEN;                             /**< ADC Interrupt Enable register. This register contains enable bits that enable the sequence-A, sequence-B, threshold compare and data overrun interrupts to be generated., offset: 0x64 */
  __IO uint32_t FLAGS;                             /**< ADC Flags register. Contains the four interrupt/DMA trigger flags and the individual component overrun and threshold-compare flags. (The overrun bits replicate information stored in the result registers)., offset: 0x68 */
} ADC_Type;

/* ----------------------------------------------------------------------------
   -- ADC Register Masks
   ---------------------------------------------------------------------------- */

/*!
 * @addtogroup ADC_Register_Masks ADC Register Masks
 * @{
 */

/*! @name CTRL - ADC Control register. Contains the clock divide value, resolution selection, sampling time selection, and mode controls. */
/*! @{ */

#define ADC_CTRL_CLKDIV_MASK                     (0xFFU)
#define ADC_CTRL_CLKDIV_SHIFT                    (0U)
/*! CLKDIV - In synchronous mode only, the system clock is divided by this value plus one to produce
 *    the clock for the ADC converter, which should be less than or equal to 72 MHz. Typically,
 *    software should program the smallest value in this field that yields this maximum clock rate or
 *    slightly less, but in certain cases (such as a high-impedance analog source) a slower clock may
 *    be desirable. This field is ignored in the asynchronous operating mode.
 */
#define ADC_CTRL_CLKDIV(x)                       (((uint32_t)(((uint32_t)(x)) << ADC_CTRL_CLKDIV_SHIFT)) & ADC_CTRL_CLKDIV_MASK)

#define ADC_CTRL_LPWRMODE_MASK                   (0x400U)
#define ADC_CTRL_LPWRMODE_SHIFT                  (10U)
/*! LPWRMODE - The low-power ADC mode
 *  0b0..The low-power ADC mode is disabled. The analog circuitry remains activated even when no conversions are requested.
 *  0b1..The low-power ADC mode is enabled. The analog circuitry is automatically powered-down when no conversions
 *       are taking place. When any (hardware or software) triggering event is detected, the analog circuitry is
 *       enabled. After the required start-up time, the requested conversion will be launched. Once the conversion
 *       completes, the analog-circuitry will again be powered-down provided no further conversions are pending.
 *       Using this mode can save an appreciable amount of current (approximately 2.5 mA) when conversions are
 *       required relatively infrequently. The penalty for using this mode is an approximately FIFTEEN ADC CLOCK delay (30
 *       clocks in 10-bit mode), based on the frequency specified in the CLKDIV field, from the time the trigger
 *       event occurs until sampling of the A/D input commences. Note: This mode will NOT power-up the A/D if the
 *       ADC_ENA bit is low.
 */
#define ADC_CTRL_LPWRMODE(x)                     (((uint32_t)(((uint32_t)(x)) << ADC_CTRL_LPWRMODE_SHIFT)) & ADC_CTRL_LPWRMODE_MASK)
/*! @} */

/*! @name SEQ_CTRL - ADC Conversion Sequence-n control register: Controls triggering and channel selection for conversion sequence-n. Also specifies interrupt mode for sequence-n. */
/*! @{ */

#define ADC_SEQ_CTRL_CHANNELS_MASK               (0xFFFU)
#define ADC_SEQ_CTRL_CHANNELS_SHIFT              (0U)
/*! CHANNELS - Selects which one or more of the ADC channels will be sampled and converted when this
 *    sequence is launched. A 1 in any bit of this field will cause the corresponding channel to be
 *    included in the conversion sequence, where bit 0 corresponds to channel 0, bit 1 to channel 1
 *    and so forth. When this conversion sequence is triggered, either by a hardware trigger or via
 *    software command, ADC conversions will be performed on each enabled channel, in sequence,
 *    beginning with the lowest-ordered channel. This field can ONLY be changed while SEQA_ENA (bit 31)
 *    is LOW. It is allowed to change this field and set bit 31 in the same write.
 */
#define ADC_SEQ_CTRL_CHANNELS(x)                 (((uint32_t)(((uint32_t)(x)) << ADC_SEQ_CTRL_CHANNELS_SHIFT)) & ADC_SEQ_CTRL_CHANNELS_MASK)

#define ADC_SEQ_CTRL_TRIGGER_MASK                (0x7000U)
#define ADC_SEQ_CTRL_TRIGGER_SHIFT               (12U)
/*! TRIGGER - Selects which of the available hardware trigger sources will cause this conversion
 *    sequence to be initiated. Program the trigger input number in this field. See Table 476. In order
 *    to avoid generating a spurious trigger, it is recommended writing to this field only when
 *    SEQA_ENA (bit 31) is low. It is safe to change this field and set bit 31 in the same write.
 */
#define ADC_SEQ_CTRL_TRIGGER(x)                  (((uint32_t)(((uint32_t)(x)) << ADC_SEQ_CTRL_TRIGGER_SHIFT)) & ADC_SEQ_CTRL_TRIGGER_MASK)

#define ADC_SEQ_CTRL_TRIGPOL_MASK                (0x40000U)
#define ADC_SEQ_CTRL_TRIGPOL_SHIFT               (18U)
/*! TRIGPOL - Select the polarity of the selected input trigger for this conversion sequence. In
 *    order to avoid generating a spurious trigger, it is recommended writing to this field only when
 *    SEQA_ENA (bit 31) is low. It is safe to change this field and set bit 31 in the same write.
 *  0b0..Negative edge. A negative edge launches the conversion sequence on the selected trigger input.
 *  0b1..Positive edge. A positive edge launches the conversion sequence on the selected trigger input.
 */
#define ADC_SEQ_CTRL_TRIGPOL(x)                  (((uint32_t)(((uint32_t)(x)) << ADC_SEQ_CTRL_TRIGPOL_SHIFT)) & ADC_SEQ_CTRL_TRIGPOL_MASK)

#define ADC_SEQ_CTRL_SYNCBYPASS_MASK             (0x80000U)
#define ADC_SEQ_CTRL_SYNCBYPASS_SHIFT            (19U)
/*! SYNCBYPASS - Setting this bit allows the hardware trigger input to bypass synchronization
 *    flip-flop stages and therefore shorten the time between the trigger input signal and the start of a
 *    conversion. There are slightly different criteria for whether or not this bit can be set
 *    depending on the clock operating mode: Synchronous mode (the ASYNMODE in the CTRL register = 0):
 *    Synchronization may be bypassed (this bit may be set) if the selected trigger source is already
 *    synchronous with the main system clock (eg. coming from an on-chip, system-clock-based timer).
 *    Whether this bit is set or not, a trigger pulse must be maintained for at least one system
 *    clock period. Asynchronous mode (the ASYNMODE in the CTRL register = 1): Synchronization may be
 *    bypassed (this bit may be set) if it is certain that the duration of a trigger input pulse
 *    will be at least one cycle of the ADC clock (regardless of whether the trigger comes from and
 *    on-chip or off-chip source). If this bit is NOT set, the trigger pulse must at least be
 *    maintained for one system clock period.
 *  0b0..Enable trigger synchronization. The hardware trigger bypass is not enabled.
 *  0b1..Bypass trigger synchronization. The hardware trigger bypass is enabled.
 */
#define ADC_SEQ_CTRL_SYNCBYPASS(x)               (((uint32_t)(((uint32_t)(x)) << ADC_SEQ_CTRL_SYNCBYPASS_SHIFT)) & ADC_SEQ_CTRL_SYNCBYPASS_MASK)

#define ADC_SEQ_CTRL_START_MASK                  (0x4000000U)
#define ADC_SEQ_CTRL_START_SHIFT                 (26U)
/*! START - Writing a 1 to this field will launch one pass through this conversion sequence. The
 *    behavior will be identical to a sequence triggered by a hardware trigger. Do not write 1 to this
 *    bit if the BURST bit is set. This bit is only set to a 1 momentarily when written to launch a
 *    conversion sequence. It will consequently always read back as a zero.
 */
#define ADC_SEQ_CTRL_START(x)                    (((uint32_t)(((uint32_t)(x)) << ADC_SEQ_CTRL_START_SHIFT)) & ADC_SEQ_CTRL_START_MASK)

#define ADC_SEQ_CTRL_BURST_MASK                  (0x8000000U)
#define ADC_SEQ_CTRL_BURST_SHIFT                 (27U)
/*! BURST - Writing a 1 to this bit will cause this conversion sequence to be continuously cycled
 *    through. Other sequence A triggers will be ignored while this bit is set. Repeated conversions
 *    can be halted by clearing this bit. The sequence currently in progress will be completed before
 *    conversions are terminated. Note that a new sequence could begin just before BURST is cleared.
 */
#define ADC_SEQ_CTRL_BURST(x)                    (((uint32_t)(((uint32_t)(x)) << ADC_SEQ_CTRL_BURST_SHIFT)) & ADC_SEQ_CTRL_BURST_MASK)

#define ADC_SEQ_CTRL_SINGLESTEP_MASK             (0x10000000U)
#define ADC_SEQ_CTRL_SINGLESTEP_SHIFT            (28U)
/*! SINGLESTEP - When this bit is set, a hardware trigger or a write to the START bit will launch a
 *    single conversion on the next channel in the sequence instead of the default response of
 *    launching an entire sequence of conversions. Once all of the channels comprising a sequence have
 *    been converted, a subsequent trigger will repeat the sequence beginning with the first enabled
 *    channel. Interrupt generation will still occur either after each individual conversion or at
 *    the end of the entire sequence, depending on the state of the MODE bit.
 */
#define ADC_SEQ_CTRL_SINGLESTEP(x)               (((uint32_t)(((uint32_t)(x)) << ADC_SEQ_CTRL_SINGLESTEP_SHIFT)) & ADC_SEQ_CTRL_SINGLESTEP_MASK)

#define ADC_SEQ_CTRL_LOWPRIO_MASK                (0x20000000U)
#define ADC_SEQ_CTRL_LOWPRIO_SHIFT               (29U)
/*! LOWPRIO - Set priority for sequence A.
 *  0b0..Low priority. Any B trigger which occurs while an A conversion sequence is active will be ignored and lost.
 *  0b1..High priority. Setting this bit to a 1 will permit any enabled B sequence trigger (including a B sequence
 *       software start) to immediately interrupt sequence A and launch a B sequence in it's place. The conversion
 *       currently in progress will be terminated. The A sequence that was interrupted will automatically resume
 *       after the B sequence completes. The channel whose conversion was terminated will be re-sampled and the
 *       conversion sequence will resume from that point.
 */
#define ADC_SEQ_CTRL_LOWPRIO(x)                  (((uint32_t)(((uint32_t)(x)) << ADC_SEQ_CTRL_LOWPRIO_SHIFT)) & ADC_SEQ_CTRL_LOWPRIO_MASK)

#define ADC_SEQ_CTRL_MODE_MASK                   (0x40000000U)
#define ADC_SEQ_CTRL_MODE_SHIFT                  (30U)
/*! MODE - Indicates whether the primary method for retrieving conversion results for this sequence
 *    will be accomplished via reading the global data register (SEQA_GDAT) at the end of each
 *    conversion, or the individual channel result registers at the end of the entire sequence. Impacts
 *    when conversion-complete interrupt/DMA trigger for sequence-A will be generated and which
 *    overrun conditions contribute to an overrun interrupt as described below.
 *  0b0..End of conversion. The sequence A interrupt/DMA trigger will be set at the end of each individual ADC
 *       conversion performed under sequence A. This flag will mirror the DATAVALID bit in the SEQA_GDAT register. The
 *       OVERRUN bit in the SEQA_GDAT register will contribute to generation of an overrun interrupt/DMA trigger
 *       if enabled.
 *  0b1..End of sequence. The sequence A interrupt/DMA trigger will be set when the entire set of sequence-A
 *       conversions completes. This flag will need to be explicitly cleared by software or by the DMA-clear signal in
 *       this mode. The OVERRUN bit in the SEQA_GDAT register will NOT contribute to generation of an overrun
 *       interrupt/DMA trigger since it is assumed this register may not be utilized in this mode.
 */
#define ADC_SEQ_CTRL_MODE(x)                     (((uint32_t)(((uint32_t)(x)) << ADC_SEQ_CTRL_MODE_SHIFT)) & ADC_SEQ_CTRL_MODE_MASK)

#define ADC_SEQ_CTRL_SEQ_ENA_MASK                (0x80000000U)
#define ADC_SEQ_CTRL_SEQ_ENA_SHIFT               (31U)
/*! SEQ_ENA - Sequence Enable. In order to avoid spuriously triggering the sequence, care should be
 *    taken to only set the SEQn_ENA bit when the selected trigger input is in its INACTIVE state
 *    (as defined by the TRIGPOL bit). If this condition is not met, the sequence will be triggered
 *    immediately upon being enabled. In order to avoid spuriously triggering the sequence, care
 *    should be taken to only set the SEQn_ENA bit when the selected trigger input is in its INACTIVE
 *    state (as defined by the TRIGPOL bit). If this condition is not met, the sequence will be
 *    triggered immediately upon being enabled.
 *  0b0..Disabled. Sequence n is disabled. Sequence n triggers are ignored. If this bit is cleared while sequence
 *       n is in progress, the sequence will be halted at the end of the current conversion. After the sequence is
 *       re-enabled, a new trigger will be required to restart the sequence beginning with the next enabled channel.
 *  0b1..Enabled. Sequence n is enabled.
 */
#define ADC_SEQ_CTRL_SEQ_ENA(x)                  (((uint32_t)(((uint32_t)(x)) << ADC_SEQ_CTRL_SEQ_ENA_SHIFT)) & ADC_SEQ_CTRL_SEQ_ENA_MASK)
/*! @} */

/*! @name SEQ_GDAT - ADC Sequence-n Global Data register. This register contains the result of the most recent ADC conversion performed under sequence-n. */
/*! @{ */

#define ADC_SEQ_GDAT_RESULT_MASK                 (0xFFF0U)
#define ADC_SEQ_GDAT_RESULT_SHIFT                (4U)
/*! RESULT - This field contains the 12-bit ADC conversion result from the most recent conversion
 *    performed under conversion sequence associated with this register. The result is a binary
 *    fraction representing the voltage on the currently-selected input channel as it falls within the
 *    range of VREFP to VREFN. Zero in the field indicates that the voltage on the input pin was less
 *    than, equal to, or close to that on VREFN, while 0xFFF indicates that the voltage on the input
 *    was close to, equal to, or greater than that on VREFP. DATAVALID = 1 indicates that this
 *    result has not yet been read.
 */
#define ADC_SEQ_GDAT_RESULT(x)                   (((uint32_t)(((uint32_t)(x)) << ADC_SEQ_GDAT_RESULT_SHIFT)) & ADC_SEQ_GDAT_RESULT_MASK)

#define ADC_SEQ_GDAT_THCMPRANGE_MASK             (0x30000U)
#define ADC_SEQ_GDAT_THCMPRANGE_SHIFT            (16U)
/*! THCMPRANGE - Indicates whether the result of the last conversion performed was above, below or
 *    within the range established by the designated threshold comparison registers (THRn_LOW and
 *    THRn_HIGH).
 */
#define ADC_SEQ_GDAT_THCMPRANGE(x)               (((uint32_t)(((uint32_t)(x)) << ADC_SEQ_GDAT_THCMPRANGE_SHIFT)) & ADC_SEQ_GDAT_THCMPRANGE_MASK)

#define ADC_SEQ_GDAT_THCMPCROSS_MASK             (0xC0000U)
#define ADC_SEQ_GDAT_THCMPCROSS_SHIFT            (18U)
/*! THCMPCROSS - Indicates whether the result of the last conversion performed represented a
 *    crossing of the threshold level established by the designated LOW threshold comparison register
 *    (THRn_LOW) and, if so, in what direction the crossing occurred.
 */
#define ADC_SEQ_GDAT_THCMPCROSS(x)               (((uint32_t)(((uint32_t)(x)) << ADC_SEQ_GDAT_THCMPCROSS_SHIFT)) & ADC_SEQ_GDAT_THCMPCROSS_MASK)

#define ADC_SEQ_GDAT_CHN_MASK                    (0x3C000000U)
#define ADC_SEQ_GDAT_CHN_SHIFT                   (26U)
/*! CHN - These bits contain the channel from which the RESULT bits were converted (e.g. 0000
 *    identifies channel 0, 0001 channel 1, etc.).
 */
#define ADC_SEQ_GDAT_CHN(x)                      (((uint32_t)(((uint32_t)(x)) << ADC_SEQ_GDAT_CHN_SHIFT)) & ADC_SEQ_GDAT_CHN_MASK)

#define ADC_SEQ_GDAT_OVERRUN_MASK                (0x40000000U)
#define ADC_SEQ_GDAT_OVERRUN_SHIFT               (30U)
/*! OVERRUN - This bit is set if a new conversion result is loaded into the RESULT field before a
 *    previous result has been read - i.e. while the DATAVALID bit is set. This bit is cleared, along
 *    with the DATAVALID bit, whenever this register is read. This bit will contribute to an overrun
 *    interrupt/DMA trigger if the MODE bit (in SEQAA_CTRL) for the corresponding sequence is set
 *    to '0' (and if the overrun interrupt is enabled).
 */
#define ADC_SEQ_GDAT_OVERRUN(x)                  (((uint32_t)(((uint32_t)(x)) << ADC_SEQ_GDAT_OVERRUN_SHIFT)) & ADC_SEQ_GDAT_OVERRUN_MASK)

#define ADC_SEQ_GDAT_DATAVALID_MASK              (0x80000000U)
#define ADC_SEQ_GDAT_DATAVALID_SHIFT             (31U)
/*! DATAVALID - This bit is set to '1' at the end of each conversion when a new result is loaded
 *    into the RESULT field. It is cleared whenever this register is read. This bit will cause a
 *    conversion-complete interrupt for the corresponding sequence if the MODE bit (in SEQA_CTRL) for that
 *    sequence is set to 0 (and if the interrupt is enabled).
 */
#define ADC_SEQ_GDAT_DATAVALID(x)                (((uint32_t)(((uint32_t)(x)) << ADC_SEQ_GDAT_DATAVALID_SHIFT)) & ADC_SEQ_GDAT_DATAVALID_MASK)
/*! @} */

/*! @name DAT - ADC Channel N Data register. This register contains the result of the most recent conversion completed on channel N. */
/*! @{ */

#define ADC_DAT_RESULT_MASK                      (0xFFF0U)
#define ADC_DAT_RESULT_SHIFT                     (4U)
/*! RESULT - This field contains the 12-bit ADC conversion result from the last conversion performed
 *    on this channel. This will be a binary fraction representing the voltage on the AD0[n] pin,
 *    as it falls within the range of VREFP to VREFN. Zero in the field indicates that the voltage on
 *    the input pin was less than, equal to, or close to that on VREFN, while 0xFFF indicates that
 *    the voltage on the input was close to, equal to, or greater than that on VREFP.
 */
#define ADC_DAT_RESULT(x)                        (((uint32_t)(((uint32_t)(x)) << ADC_DAT_RESULT_SHIFT)) & ADC_DAT_RESULT_MASK)

#define ADC_DAT_THCMPRANGE_MASK                  (0x30000U)
#define ADC_DAT_THCMPRANGE_SHIFT                 (16U)
/*! THCMPRANGE - Threshold Range Comparison result. 0x0 = In Range: The last completed conversion
 *    was greater than or equal to the value programmed into the designated LOW threshold register
 *    (THRn_LOW) but less than or equal to the value programmed into the designated HIGH threshold
 *    register (THRn_HIGH). 0x1 = Below Range: The last completed conversion on was less than the value
 *    programmed into the designated LOW threshold register (THRn_LOW). 0x2 = Above Range: The last
 *    completed conversion was greater than the value programmed into the designated HIGH threshold
 *    register (THRn_HIGH). 0x3 = Reserved.
 */
#define ADC_DAT_THCMPRANGE(x)                    (((uint32_t)(((uint32_t)(x)) << ADC_DAT_THCMPRANGE_SHIFT)) & ADC_DAT_THCMPRANGE_MASK)

#define ADC_DAT_THCMPCROSS_MASK                  (0xC0000U)
#define ADC_DAT_THCMPCROSS_SHIFT                 (18U)
/*! THCMPCROSS - Threshold Crossing Comparison result. 0x0 = No threshold Crossing detected: The
 *    most recent completed conversion on this channel had the same relationship (above or below) to
 *    the threshold value established by the designated LOW threshold register (THRn_LOW) as did the
 *    previous conversion on this channel. 0x1 = Reserved. 0x2 = Downward Threshold Crossing
 *    Detected. Indicates that a threshold crossing in the downward direction has occurred - i.e. the
 *    previous sample on this channel was above the threshold value established by the designated LOW
 *    threshold register (THRn_LOW) and the current sample is below that threshold. 0x3 = Upward
 *    Threshold Crossing Detected. Indicates that a threshold crossing in the upward direction has occurred
 *    - i.e. the previous sample on this channel was below the threshold value established by the
 *    designated LOW threshold register (THRn_LOW) and the current sample is above that threshold.
 */
#define ADC_DAT_THCMPCROSS(x)                    (((uint32_t)(((uint32_t)(x)) << ADC_DAT_THCMPCROSS_SHIFT)) & ADC_DAT_THCMPCROSS_MASK)

#define ADC_DAT_CHANNEL_MASK                     (0x3C000000U)
#define ADC_DAT_CHANNEL_SHIFT                    (26U)
/*! CHANNEL - This field is hard-coded to contain the channel number that this particular register
 *    relates to (i.e. this field will contain 0b0000 for the DAT0 register, 0b0001 for the DAT1
 *    register, etc)
 */
#define ADC_DAT_CHANNEL(x)                       (((uint32_t)(((uint32_t)(x)) << ADC_DAT_CHANNEL_SHIFT)) & ADC_DAT_CHANNEL_MASK)

#define ADC_DAT_OVERRUN_MASK                     (0x40000000U)
#define ADC_DAT_OVERRUN_SHIFT                    (30U)
/*! OVERRUN - This bit will be set to a 1 if a new conversion on this channel completes and
 *    overwrites the previous contents of the RESULT field before it has been read - i.e. while the DONE bit
 *    is set. This bit is cleared, along with the DONE bit, whenever this register is read or when
 *    the data related to this channel is read from either of the global SEQn_GDAT registers. This
 *    bit (in any of the 12 registers) will cause an overrun interrupt/DMA trigger to be asserted if
 *    the overrun interrupt is enabled. While it is allowed to include the same channels in both
 *    conversion sequences, doing so may cause erratic behavior of the DONE and OVERRUN bits in the
 *    data registers associated with any of the channels that are shared between the two sequences. Any
 *    erratic OVERRUN behavior will also affect overrun interrupt generation, if enabled.
 */
#define ADC_DAT_OVERRUN(x)                       (((uint32_t)(((uint32_t)(x)) << ADC_DAT_OVERRUN_SHIFT)) & ADC_DAT_OVERRUN_MASK)

#define ADC_DAT_DATAVALID_MASK                   (0x80000000U)
#define ADC_DAT_DATAVALID_SHIFT                  (31U)
/*! DATAVALID - This bit is set to 1 when an ADC conversion on this channel completes. This bit is
 *    cleared whenever this register is read or when the data related to this channel is read from
 *    either of the global SEQn_GDAT registers. While it is allowed to include the same channels in
 *    both conversion sequences, doing so may cause erratic behavior of the DONE and OVERRUN bits in
 *    the data registers associated with any of the channels that are shared between the two
 *    sequences. Any erratic OVERRUN behavior will also affect overrun interrupt generation, if enabled.
 */
#define ADC_DAT_DATAVALID(x)                     (((uint32_t)(((uint32_t)(x)) << ADC_DAT_DATAVALID_SHIFT)) & ADC_DAT_DATAVALID_MASK)
/*! @} */

/*! @name THR0_LOW - ADC Low Compare Threshold register 0: Contains the lower threshold level for automatic threshold comparison for any channels linked to threshold pair 0. */
/*! @{ */

#define ADC_THR0_LOW_THRLOW_MASK                 (0xFFF0U)
#define ADC_THR0_LOW_THRLOW_SHIFT                (4U)
/*! THRLOW - Low threshold value against which ADC results will be compared */
#define ADC_THR0_LOW_THRLOW(x)                   (((uint32_t)(((uint32_t)(x)) << ADC_THR0_LOW_THRLOW_SHIFT)) & ADC_THR0_LOW_THRLOW_MASK)
/*! @} */

/*! @name THR1_LOW - ADC Low Compare Threshold register 1: Contains the lower threshold level for automatic threshold comparison for any channels linked to threshold pair 1. */
/*! @{ */

#define ADC_THR1_LOW_THRLOW_MASK                 (0xFFF0U)
#define ADC_THR1_LOW_THRLOW_SHIFT                (4U)
/*! THRLOW - Low threshold value against which ADC results will be compared */
#define ADC_THR1_LOW_THRLOW(x)                   (((uint32_t)(((uint32_t)(x)) << ADC_THR1_LOW_THRLOW_SHIFT)) & ADC_THR1_LOW_THRLOW_MASK)
/*! @} */

/*! @name THR0_HIGH - ADC High Compare Threshold register 0: Contains the upper threshold level for automatic threshold comparison for any channels linked to threshold pair 0. */
/*! @{ */

#define ADC_THR0_HIGH_THRHIGH_MASK               (0xFFF0U)
#define ADC_THR0_HIGH_THRHIGH_SHIFT              (4U)
/*! THRHIGH - High threshold value against which ADC results will be compared */
#define ADC_THR0_HIGH_THRHIGH(x)                 (((uint32_t)(((uint32_t)(x)) << ADC_THR0_HIGH_THRHIGH_SHIFT)) & ADC_THR0_HIGH_THRHIGH_MASK)
/*! @} */

/*! @name THR1_HIGH - ADC High Compare Threshold register 1: Contains the upper threshold level for automatic threshold comparison for any channels linked to threshold pair 1. */
/*! @{ */

#define ADC_THR1_HIGH_THRHIGH_MASK               (0xFFF0U)
#define ADC_THR1_HIGH_THRHIGH_SHIFT              (4U)
/*! THRHIGH - High threshold value against which ADC results will be compared */
#define ADC_THR1_HIGH_THRHIGH(x)                 (((uint32_t)(((uint32_t)(x)) << ADC_THR1_HIGH_THRHIGH_SHIFT)) & ADC_THR1_HIGH_THRHIGH_MASK)
/*! @} */

/*! @name CHAN_THRSEL - ADC Channel-Threshold Select register. Specifies which set of threshold compare registers are to be used for each channel */
/*! @{ */

#define ADC_CHAN_THRSEL_CH0_THRSEL_MASK          (0x1U)
#define ADC_CHAN_THRSEL_CH0_THRSEL_SHIFT         (0U)
/*! CH0_THRSEL - Threshold select for channel 0.
 *  0b0..Threshold 0. Results for this channel will be compared against the threshold levels indicated in the THR0_LOW and THR0_HIGH registers.
 *  0b1..Threshold 1. Results for this channel will be compared against the threshold levels indicated in the THR1_LOW and THR1_HIGH registers.
 */
#define ADC_CHAN_THRSEL_CH0_THRSEL(x)            (((uint32_t)(((uint32_t)(x)) << ADC_CHAN_THRSEL_CH0_THRSEL_SHIFT)) & ADC_CHAN_THRSEL_CH0_THRSEL_MASK)

#define ADC_CHAN_THRSEL_CH1_THRSEL_MASK          (0x2U)
#define ADC_CHAN_THRSEL_CH1_THRSEL_SHIFT         (1U)
/*! CH1_THRSEL - Threshold select for channel 1. See description for channel 0. */
#define ADC_CHAN_THRSEL_CH1_THRSEL(x)            (((uint32_t)(((uint32_t)(x)) << ADC_CHAN_THRSEL_CH1_THRSEL_SHIFT)) & ADC_CHAN_THRSEL_CH1_THRSEL_MASK)

#define ADC_CHAN_THRSEL_CH2_THRSEL_MASK          (0x4U)
#define ADC_CHAN_THRSEL_CH2_THRSEL_SHIFT         (2U)
/*! CH2_THRSEL - Threshold select for channel 2. See description for channel 0. */
#define ADC_CHAN_THRSEL_CH2_THRSEL(x)            (((uint32_t)(((uint32_t)(x)) << ADC_CHAN_THRSEL_CH2_THRSEL_SHIFT)) & ADC_CHAN_THRSEL_CH2_THRSEL_MASK)

#define ADC_CHAN_THRSEL_CH3_THRSEL_MASK          (0x8U)
#define ADC_CHAN_THRSEL_CH3_THRSEL_SHIFT         (3U)
/*! CH3_THRSEL - Threshold select for channel 3. See description for channel 0. */
#define ADC_CHAN_THRSEL_CH3_THRSEL(x)            (((uint32_t)(((uint32_t)(x)) << ADC_CHAN_THRSEL_CH3_THRSEL_SHIFT)) & ADC_CHAN_THRSEL_CH3_THRSEL_MASK)

#define ADC_CHAN_THRSEL_CH4_THRSEL_MASK          (0x10U)
#define ADC_CHAN_THRSEL_CH4_THRSEL_SHIFT         (4U)
/*! CH4_THRSEL - Threshold select for channel 4. See description for channel 0. */
#define ADC_CHAN_THRSEL_CH4_THRSEL(x)            (((uint32_t)(((uint32_t)(x)) << ADC_CHAN_THRSEL_CH4_THRSEL_SHIFT)) & ADC_CHAN_THRSEL_CH4_THRSEL_MASK)

#define ADC_CHAN_THRSEL_CH5_THRSEL_MASK          (0x20U)
#define ADC_CHAN_THRSEL_CH5_THRSEL_SHIFT         (5U)
/*! CH5_THRSEL - Threshold select for channel 5. See description for channel 0. */
#define ADC_CHAN_THRSEL_CH5_THRSEL(x)            (((uint32_t)(((uint32_t)(x)) << ADC_CHAN_THRSEL_CH5_THRSEL_SHIFT)) & ADC_CHAN_THRSEL_CH5_THRSEL_MASK)

#define ADC_CHAN_THRSEL_CH6_THRSEL_MASK          (0x40U)
#define ADC_CHAN_THRSEL_CH6_THRSEL_SHIFT         (6U)
/*! CH6_THRSEL - Threshold select for channel 6. See description for channel 0. */
#define ADC_CHAN_THRSEL_CH6_THRSEL(x)            (((uint32_t)(((uint32_t)(x)) << ADC_CHAN_THRSEL_CH6_THRSEL_SHIFT)) & ADC_CHAN_THRSEL_CH6_THRSEL_MASK)

#define ADC_CHAN_THRSEL_CH7_THRSEL_MASK          (0x80U)
#define ADC_CHAN_THRSEL_CH7_THRSEL_SHIFT         (7U)
/*! CH7_THRSEL - Threshold select for channel 7. See description for channel 0. */
#define ADC_CHAN_THRSEL_CH7_THRSEL(x)            (((uint32_t)(((uint32_t)(x)) << ADC_CHAN_THRSEL_CH7_THRSEL_SHIFT)) & ADC_CHAN_THRSEL_CH7_THRSEL_MASK)

#define ADC_CHAN_THRSEL_CH8_THRSEL_MASK          (0x100U)
#define ADC_CHAN_THRSEL_CH8_THRSEL_SHIFT         (8U)
/*! CH8_THRSEL - Threshold select for channel 8. See description for channel 0. */
#define ADC_CHAN_THRSEL_CH8_THRSEL(x)            (((uint32_t)(((uint32_t)(x)) << ADC_CHAN_THRSEL_CH8_THRSEL_SHIFT)) & ADC_CHAN_THRSEL_CH8_THRSEL_MASK)

#define ADC_CHAN_THRSEL_CH9_THRSEL_MASK          (0x200U)
#define ADC_CHAN_THRSEL_CH9_THRSEL_SHIFT         (9U)
/*! CH9_THRSEL - Threshold select for channel 9. See description for channel 0. */
#define ADC_CHAN_THRSEL_CH9_THRSEL(x)            (((uint32_t)(((uint32_t)(x)) << ADC_CHAN_THRSEL_CH9_THRSEL_SHIFT)) & ADC_CHAN_THRSEL_CH9_THRSEL_MASK)

#define ADC_CHAN_THRSEL_CH10_THRSEL_MASK         (0x400U)
#define ADC_CHAN_THRSEL_CH10_THRSEL_SHIFT        (10U)
/*! CH10_THRSEL - Threshold select for channel 10. See description for channel 0. */
#define ADC_CHAN_THRSEL_CH10_THRSEL(x)           (((uint32_t)(((uint32_t)(x)) << ADC_CHAN_THRSEL_CH10_THRSEL_SHIFT)) & ADC_CHAN_THRSEL_CH10_THRSEL_MASK)

#define ADC_CHAN_THRSEL_CH11_THRSEL_MASK         (0x800U)
#define ADC_CHAN_THRSEL_CH11_THRSEL_SHIFT        (11U)
/*! CH11_THRSEL - Threshold select for channel 11. See description for channel 0. */
#define ADC_CHAN_THRSEL_CH11_THRSEL(x)           (((uint32_t)(((uint32_t)(x)) << ADC_CHAN_THRSEL_CH11_THRSEL_SHIFT)) & ADC_CHAN_THRSEL_CH11_THRSEL_MASK)
/*! @} */

/*! @name INTEN - ADC Interrupt Enable register. This register contains enable bits that enable the sequence-A, sequence-B, threshold compare and data overrun interrupts to be generated. */
/*! @{ */

#define ADC_INTEN_SEQA_INTEN_MASK                (0x1U)
#define ADC_INTEN_SEQA_INTEN_SHIFT               (0U)
/*! SEQA_INTEN - Sequence A interrupt enable.
 *  0b0..Disabled. The sequence A interrupt/DMA trigger is disabled.
 *  0b1..Enabled. The sequence A interrupt/DMA trigger is enabled and will be asserted either upon completion of
 *       each individual conversion performed as part of sequence A, or upon completion of the entire A sequence of
 *       conversions, depending on the MODE bit in the SEQA_CTRL register.
 */
#define ADC_INTEN_SEQA_INTEN(x)                  (((uint32_t)(((uint32_t)(x)) << ADC_INTEN_SEQA_INTEN_SHIFT)) & ADC_INTEN_SEQA_INTEN_MASK)

#define ADC_INTEN_SEQB_INTEN_MASK                (0x2U)
#define ADC_INTEN_SEQB_INTEN_SHIFT               (1U)
/*! SEQB_INTEN - Sequence B interrupt enable.
 *  0b0..Disabled. The sequence B interrupt/DMA trigger is disabled.
 *  0b1..Enabled. The sequence B interrupt/DMA trigger is enabled and will be asserted either upon completion of
 *       each individual conversion performed as part of sequence B, or upon completion of the entire B sequence of
 *       conversions, depending on the MODE bit in the SEQB_CTRL register.
 */
#define ADC_INTEN_SEQB_INTEN(x)                  (((uint32_t)(((uint32_t)(x)) << ADC_INTEN_SEQB_INTEN_SHIFT)) & ADC_INTEN_SEQB_INTEN_MASK)

#define ADC_INTEN_OVR_INTEN_MASK                 (0x4U)
#define ADC_INTEN_OVR_INTEN_SHIFT                (2U)
/*! OVR_INTEN - Overrun interrupt enable.
 *  0b0..Disabled. The overrun interrupt is disabled.
 *  0b1..Enabled. The overrun interrupt is enabled. Detection of an overrun condition on any of the 12 channel
 *       data registers will cause an overrun interrupt/DMA trigger. In addition, if the MODE bit for a particular
 *       sequence is 0, then an overrun in the global data register for that sequence will also cause this
 *       interrupt/DMA trigger to be asserted.
 */
#define ADC_INTEN_OVR_INTEN(x)                   (((uint32_t)(((uint32_t)(x)) << ADC_INTEN_OVR_INTEN_SHIFT)) & ADC_INTEN_OVR_INTEN_MASK)

#define ADC_INTEN_ADCMPINTEN0_MASK               (0x18U)
#define ADC_INTEN_ADCMPINTEN0_SHIFT              (3U)
/*! ADCMPINTEN0 - Threshold comparison interrupt enable for channel 0.
 *  0b00..Disabled.
 *  0b01..Outside threshold.
 *  0b10..Crossing threshold.
 *  0b11..Reserved
 */
#define ADC_INTEN_ADCMPINTEN0(x)                 (((uint32_t)(((uint32_t)(x)) << ADC_INTEN_ADCMPINTEN0_SHIFT)) & ADC_INTEN_ADCMPINTEN0_MASK)

#define ADC_INTEN_ADCMPINTEN1_MASK               (0x60U)
#define ADC_INTEN_ADCMPINTEN1_SHIFT              (5U)
/*! ADCMPINTEN1 - Channel 1 threshold comparison interrupt enable. See description for channel 0. */
#define ADC_INTEN_ADCMPINTEN1(x)                 (((uint32_t)(((uint32_t)(x)) << ADC_INTEN_ADCMPINTEN1_SHIFT)) & ADC_INTEN_ADCMPINTEN1_MASK)

#define ADC_INTEN_ADCMPINTEN2_MASK               (0x180U)
#define ADC_INTEN_ADCMPINTEN2_SHIFT              (7U)
/*! ADCMPINTEN2 - Channel 2 threshold comparison interrupt enable. See description for channel 0. */
#define ADC_INTEN_ADCMPINTEN2(x)                 (((uint32_t)(((uint32_t)(x)) << ADC_INTEN_ADCMPINTEN2_SHIFT)) & ADC_INTEN_ADCMPINTEN2_MASK)

#define ADC_INTEN_ADCMPINTEN3_MASK               (0x600U)
#define ADC_INTEN_ADCMPINTEN3_SHIFT              (9U)
/*! ADCMPINTEN3 - Channel 3 threshold comparison interrupt enable. See description for channel 0. */
#define ADC_INTEN_ADCMPINTEN3(x)                 (((uint32_t)(((uint32_t)(x)) << ADC_INTEN_ADCMPINTEN3_SHIFT)) & ADC_INTEN_ADCMPINTEN3_MASK)

#define ADC_INTEN_ADCMPINTEN4_MASK               (0x1800U)
#define ADC_INTEN_ADCMPINTEN4_SHIFT              (11U)
/*! ADCMPINTEN4 - Channel 4 threshold comparison interrupt enable. See description for channel 0. */
#define ADC_INTEN_ADCMPINTEN4(x)                 (((uint32_t)(((uint32_t)(x)) << ADC_INTEN_ADCMPINTEN4_SHIFT)) & ADC_INTEN_ADCMPINTEN4_MASK)

#define ADC_INTEN_ADCMPINTEN5_MASK               (0x6000U)
#define ADC_INTEN_ADCMPINTEN5_SHIFT              (13U)
/*! ADCMPINTEN5 - Channel 5 threshold comparison interrupt enable. See description for channel 0. */
#define ADC_INTEN_ADCMPINTEN5(x)                 (((uint32_t)(((uint32_t)(x)) << ADC_INTEN_ADCMPINTEN5_SHIFT)) & ADC_INTEN_ADCMPINTEN5_MASK)

#define ADC_INTEN_ADCMPINTEN6_MASK               (0x18000U)
#define ADC_INTEN_ADCMPINTEN6_SHIFT              (15U)
/*! ADCMPINTEN6 - Channel 6 threshold comparison interrupt enable. See description for channel 0. */
#define ADC_INTEN_ADCMPINTEN6(x)                 (((uint32_t)(((uint32_t)(x)) << ADC_INTEN_ADCMPINTEN6_SHIFT)) & ADC_INTEN_ADCMPINTEN6_MASK)

#define ADC_INTEN_ADCMPINTEN7_MASK               (0x60000U)
#define ADC_INTEN_ADCMPINTEN7_SHIFT              (17U)
/*! ADCMPINTEN7 - Channel 7 threshold comparison interrupt enable. See description for channel 0. */
#define ADC_INTEN_ADCMPINTEN7(x)                 (((uint32_t)(((uint32_t)(x)) << ADC_INTEN_ADCMPINTEN7_SHIFT)) & ADC_INTEN_ADCMPINTEN7_MASK)

#define ADC_INTEN_ADCMPINTEN8_MASK               (0x180000U)
#define ADC_INTEN_ADCMPINTEN8_SHIFT              (19U)
/*! ADCMPINTEN8 - Channel 8 threshold comparison interrupt enable. See description for channel 0. */
#define ADC_INTEN_ADCMPINTEN8(x)                 (((uint32_t)(((uint32_t)(x)) << ADC_INTEN_ADCMPINTEN8_SHIFT)) & ADC_INTEN_ADCMPINTEN8_MASK)

#define ADC_INTEN_ADCMPINTEN9_MASK               (0x600000U)
#define ADC_INTEN_ADCMPINTEN9_SHIFT              (21U)
/*! ADCMPINTEN9 - Channel 9 threshold comparison interrupt enable. See description for channel 0. */
#define ADC_INTEN_ADCMPINTEN9(x)                 (((uint32_t)(((uint32_t)(x)) << ADC_INTEN_ADCMPINTEN9_SHIFT)) & ADC_INTEN_ADCMPINTEN9_MASK)

#define ADC_INTEN_ADCMPINTEN10_MASK              (0x1800000U)
#define ADC_INTEN_ADCMPINTEN10_SHIFT             (23U)
/*! ADCMPINTEN10 - Channel 10 threshold comparison interrupt enable. See description for channel 0. */
#define ADC_INTEN_ADCMPINTEN10(x)                (((uint32_t)(((uint32_t)(x)) << ADC_INTEN_ADCMPINTEN10_SHIFT)) & ADC_INTEN_ADCMPINTEN10_MASK)

#define ADC_INTEN_ADCMPINTEN11_MASK              (0x6000000U)
#define ADC_INTEN_ADCMPINTEN11_SHIFT             (25U)
/*! ADCMPINTEN11 - Channel 21 threshold comparison interrupt enable. See description for channel 0. */
#define ADC_INTEN_ADCMPINTEN11(x)                (((uint32_t)(((uint32_t)(x)) << ADC_INTEN_ADCMPINTEN11_SHIFT)) & ADC_INTEN_ADCMPINTEN11_MASK)
/*! @} */

/*! @name FLAGS - ADC Flags register. Contains the four interrupt/DMA trigger flags and the individual component overrun and threshold-compare flags. (The overrun bits replicate information stored in the result registers). */
/*! @{ */

#define ADC_FLAGS_THCMP0_MASK                    (0x1U)
#define ADC_FLAGS_THCMP0_SHIFT                   (0U)
/*! THCMP0 - Threshold comparison event on Channel 0. Set to 1 upon either an out-of-range result or
 *    a threshold-crossing result if enabled to do so in the INTEN register. This bit is cleared by
 *    writing a 1.
 */
#define ADC_FLAGS_THCMP0(x)                      (((uint32_t)(((uint32_t)(x)) << ADC_FLAGS_THCMP0_SHIFT)) & ADC_FLAGS_THCMP0_MASK)

#define ADC_FLAGS_THCMP1_MASK                    (0x2U)
#define ADC_FLAGS_THCMP1_SHIFT                   (1U)
/*! THCMP1 - Threshold comparison event on Channel 1. See description for channel 0. */
#define ADC_FLAGS_THCMP1(x)                      (((uint32_t)(((uint32_t)(x)) << ADC_FLAGS_THCMP1_SHIFT)) & ADC_FLAGS_THCMP1_MASK)

#define ADC_FLAGS_THCMP2_MASK                    (0x4U)
#define ADC_FLAGS_THCMP2_SHIFT                   (2U)
/*! THCMP2 - Threshold comparison event on Channel 2. See description for channel 0. */
#define ADC_FLAGS_THCMP2(x)                      (((uint32_t)(((uint32_t)(x)) << ADC_FLAGS_THCMP2_SHIFT)) & ADC_FLAGS_THCMP2_MASK)

#define ADC_FLAGS_THCMP3_MASK                    (0x8U)
#define ADC_FLAGS_THCMP3_SHIFT                   (3U)
/*! THCMP3 - Threshold comparison event on Channel 3. See description for channel 0. */
#define ADC_FLAGS_THCMP3(x)                      (((uint32_t)(((uint32_t)(x)) << ADC_FLAGS_THCMP3_SHIFT)) & ADC_FLAGS_THCMP3_MASK)

#define ADC_FLAGS_THCMP4_MASK                    (0x10U)
#define ADC_FLAGS_THCMP4_SHIFT                   (4U)
/*! THCMP4 - Threshold comparison event on Channel 4. See description for channel 0. */
#define ADC_FLAGS_THCMP4(x)                      (((uint32_t)(((uint32_t)(x)) << ADC_FLAGS_THCMP4_SHIFT)) & ADC_FLAGS_THCMP4_MASK)

#define ADC_FLAGS_THCMP5_MASK                    (0x20U)
#define ADC_FLAGS_THCMP5_SHIFT                   (5U)
/*! THCMP5 - Threshold comparison event on Channel 5. See description for channel 0. */
#define ADC_FLAGS_THCMP5(x)                      (((uint32_t)(((uint32_t)(x)) << ADC_FLAGS_THCMP5_SHIFT)) & ADC_FLAGS_THCMP5_MASK)

#define ADC_FLAGS_THCMP6_MASK                    (0x40U)
#define ADC_FLAGS_THCMP6_SHIFT                   (6U)
/*! THCMP6 - Threshold comparison event on Channel 6. See description for channel 0. */
#define ADC_FLAGS_THCMP6(x)                      (((uint32_t)(((uint32_t)(x)) << ADC_FLAGS_THCMP6_SHIFT)) & ADC_FLAGS_THCMP6_MASK)

#define ADC_FLAGS_THCMP7_MASK                    (0x80U)
#define ADC_FLAGS_THCMP7_SHIFT                   (7U)
/*! THCMP7 - Threshold comparison event on Channel 7. See description for channel 0. */
#define ADC_FLAGS_THCMP7(x)                      (((uint32_t)(((uint32_t)(x)) << ADC_FLAGS_THCMP7_SHIFT)) & ADC_FLAGS_THCMP7_MASK)

#define ADC_FLAGS_THCMP8_MASK                    (0x100U)
#define ADC_FLAGS_THCMP8_SHIFT                   (8U)
/*! THCMP8 - Threshold comparison event on Channel 8. See description for channel 0. */
#define ADC_FLAGS_THCMP8(x)                      (((uint32_t)(((uint32_t)(x)) << ADC_FLAGS_THCMP8_SHIFT)) & ADC_FLAGS_THCMP8_MASK)

#define ADC_FLAGS_THCMP9_MASK                    (0x200U)
#define ADC_FLAGS_THCMP9_SHIFT                   (9U)
/*! THCMP9 - Threshold comparison event on Channel 9. See description for channel 0. */
#define ADC_FLAGS_THCMP9(x)                      (((uint32_t)(((uint32_t)(x)) << ADC_FLAGS_THCMP9_SHIFT)) & ADC_FLAGS_THCMP9_MASK)

#define ADC_FLAGS_THCMP10_MASK                   (0x400U)
#define ADC_FLAGS_THCMP10_SHIFT                  (10U)
/*! THCMP10 - Threshold comparison event on Channel 10. See description for channel 0. */
#define ADC_FLAGS_THCMP10(x)                     (((uint32_t)(((uint32_t)(x)) << ADC_FLAGS_THCMP10_SHIFT)) & ADC_FLAGS_THCMP10_MASK)

#define ADC_FLAGS_THCMP11_MASK                   (0x800U)
#define ADC_FLAGS_THCMP11_SHIFT                  (11U)
/*! THCMP11 - Threshold comparison event on Channel 11. See description for channel 0. */
#define ADC_FLAGS_THCMP11(x)                     (((uint32_t)(((uint32_t)(x)) << ADC_FLAGS_THCMP11_SHIFT)) & ADC_FLAGS_THCMP11_MASK)

#define ADC_FLAGS_OVERRUN0_MASK                  (0x1000U)
#define ADC_FLAGS_OVERRUN0_SHIFT                 (12U)
/*! OVERRUN0 - Mirrors the OVERRRUN status flag from the result register for ADC channel 0 */
#define ADC_FLAGS_OVERRUN0(x)                    (((uint32_t)(((uint32_t)(x)) << ADC_FLAGS_OVERRUN0_SHIFT)) & ADC_FLAGS_OVERRUN0_MASK)

#define ADC_FLAGS_OVERRUN1_MASK                  (0x2000U)
#define ADC_FLAGS_OVERRUN1_SHIFT                 (13U)
/*! OVERRUN1 - Mirrors the OVERRRUN status flag from the result register for ADC channel 1 */
#define ADC_FLAGS_OVERRUN1(x)                    (((uint32_t)(((uint32_t)(x)) << ADC_FLAGS_OVERRUN1_SHIFT)) & ADC_FLAGS_OVERRUN1_MASK)

#define ADC_FLAGS_OVERRUN2_MASK                  (0x4000U)
#define ADC_FLAGS_OVERRUN2_SHIFT                 (14U)
/*! OVERRUN2 - Mirrors the OVERRRUN status flag from the result register for ADC channel 2 */
#define ADC_FLAGS_OVERRUN2(x)                    (((uint32_t)(((uint32_t)(x)) << ADC_FLAGS_OVERRUN2_SHIFT)) & ADC_FLAGS_OVERRUN2_MASK)

#define ADC_FLAGS_OVERRUN3_MASK                  (0x8000U)
#define ADC_FLAGS_OVERRUN3_SHIFT                 (15U)
/*! OVERRUN3 - Mirrors the OVERRRUN status flag from the result register for ADC channel 3 */
#define ADC_FLAGS_OVERRUN3(x)                    (((uint32_t)(((uint32_t)(x)) << ADC_FLAGS_OVERRUN3_SHIFT)) & ADC_FLAGS_OVERRUN3_MASK)

#define ADC_FLAGS_OVERRUN4_MASK                  (0x10000U)
#define ADC_FLAGS_OVERRUN4_SHIFT                 (16U)
/*! OVERRUN4 - Mirrors the OVERRRUN status flag from the result register for ADC channel 4 */
#define ADC_FLAGS_OVERRUN4(x)                    (((uint32_t)(((uint32_t)(x)) << ADC_FLAGS_OVERRUN4_SHIFT)) & ADC_FLAGS_OVERRUN4_MASK)

#define ADC_FLAGS_OVERRUN5_MASK                  (0x20000U)
#define ADC_FLAGS_OVERRUN5_SHIFT                 (17U)
/*! OVERRUN5 - Mirrors the OVERRRUN status flag from the result register for ADC channel 5 */
#define ADC_FLAGS_OVERRUN5(x)                    (((uint32_t)(((uint32_t)(x)) << ADC_FLAGS_OVERRUN5_SHIFT)) & ADC_FLAGS_OVERRUN5_MASK)

#define ADC_FLAGS_OVERRUN6_MASK                  (0x40000U)
#define ADC_FLAGS_OVERRUN6_SHIFT                 (18U)
/*! OVERRUN6 - Mirrors the OVERRRUN status flag from the result register for ADC channel 6 */
#define ADC_FLAGS_OVERRUN6(x)                    (((uint32_t)(((uint32_t)(x)) << ADC_FLAGS_OVERRUN6_SHIFT)) & ADC_FLAGS_OVERRUN6_MASK)

#define ADC_FLAGS_OVERRUN7_MASK                  (0x80000U)
#define ADC_FLAGS_OVERRUN7_SHIFT                 (19U)
/*! OVERRUN7 - Mirrors the OVERRRUN status flag from the result register for ADC channel 7 */
#define ADC_FLAGS_OVERRUN7(x)                    (((uint32_t)(((uint32_t)(x)) << ADC_FLAGS_OVERRUN7_SHIFT)) & ADC_FLAGS_OVERRUN7_MASK)

#define ADC_FLAGS_OVERRUN8_MASK                  (0x100000U)
#define ADC_FLAGS_OVERRUN8_SHIFT                 (20U)
/*! OVERRUN8 - Mirrors the OVERRRUN status flag from the result register for ADC channel 8 */
#define ADC_FLAGS_OVERRUN8(x)                    (((uint32_t)(((uint32_t)(x)) << ADC_FLAGS_OVERRUN8_SHIFT)) & ADC_FLAGS_OVERRUN8_MASK)

#define ADC_FLAGS_OVERRUN9_MASK                  (0x200000U)
#define ADC_FLAGS_OVERRUN9_SHIFT                 (21U)
/*! OVERRUN9 - Mirrors the OVERRRUN status flag from the result register for ADC channel 9 */
#define ADC_FLAGS_OVERRUN9(x)                    (((uint32_t)(((uint32_t)(x)) << ADC_FLAGS_OVERRUN9_SHIFT)) & ADC_FLAGS_OVERRUN9_MASK)

#define ADC_FLAGS_OVERRUN10_MASK                 (0x400000U)
#define ADC_FLAGS_OVERRUN10_SHIFT                (22U)
/*! OVERRUN10 - Mirrors the OVERRRUN status flag from the result register for ADC channel 10 */
#define ADC_FLAGS_OVERRUN10(x)                   (((uint32_t)(((uint32_t)(x)) << ADC_FLAGS_OVERRUN10_SHIFT)) & ADC_FLAGS_OVERRUN10_MASK)

#define ADC_FLAGS_OVERRUN11_MASK                 (0x800000U)
#define ADC_FLAGS_OVERRUN11_SHIFT                (23U)
/*! OVERRUN11 - Mirrors the OVERRRUN status flag from the result register for ADC channel 11 */
#define ADC_FLAGS_OVERRUN11(x)                   (((uint32_t)(((uint32_t)(x)) << ADC_FLAGS_OVERRUN11_SHIFT)) & ADC_FLAGS_OVERRUN11_MASK)

#define ADC_FLAGS_SEQA_OVR_MASK                  (0x1000000U)
#define ADC_FLAGS_SEQA_OVR_SHIFT                 (24U)
/*! SEQA_OVR - Mirrors the global OVERRUN status flag in the SEQA_GDAT register */
#define ADC_FLAGS_SEQA_OVR(x)                    (((uint32_t)(((uint32_t)(x)) << ADC_FLAGS_SEQA_OVR_SHIFT)) & ADC_FLAGS_SEQA_OVR_MASK)

#define ADC_FLAGS_SEQB_OVR_MASK                  (0x2000000U)
#define ADC_FLAGS_SEQB_OVR_SHIFT                 (25U)
/*! SEQB_OVR - Mirrors the global OVERRUN status flag in the SEQB_GDAT register */
#define ADC_FLAGS_SEQB_OVR(x)                    (((uint32_t)(((uint32_t)(x)) << ADC_FLAGS_SEQB_OVR_SHIFT)) & ADC_FLAGS_SEQB_OVR_MASK)

#define ADC_FLAGS_SEQA_INT_MASK                  (0x10000000U)
#define ADC_FLAGS_SEQA_INT_SHIFT                 (28U)
/*! SEQA_INT - Sequence A interrupt/DMA trigger. If the MODE bit in the SEQA_CTRL register is 0,
 *    this flag will mirror the DATAVALID bit in the sequence A global data register (SEQA_GDAT), which
 *    is set at the end of every ADC conversion performed as part of sequence A. It will be cleared
 *    automatically when the SEQA_GDAT register is read. If the MODE bit in the SEQA_CTRL register
 *    is 1, this flag will be set upon completion of an entire A sequence. In this case it must be
 *    cleared by writing a 1 to this SEQA_INT bit. This interrupt must be enabled in the INTEN
 *    register.
 */
#define ADC_FLAGS_SEQA_INT(x)                    (((uint32_t)(((uint32_t)(x)) << ADC_FLAGS_SEQA_INT_SHIFT)) & ADC_FLAGS_SEQA_INT_MASK)

#define ADC_FLAGS_SEQB_INT_MASK                  (0x20000000U)
#define ADC_FLAGS_SEQB_INT_SHIFT                 (29U)
/*! SEQB_INT - Sequence A interrupt/DMA trigger. If the MODE bit in the SEQB_CTRL register is 0,
 *    this flag will mirror the DATAVALID bit in the sequence A global data register (SEQB_GDAT), which
 *    is set at the end of every ADC conversion performed as part of sequence B. It will be cleared
 *    automatically when the SEQB_GDAT register is read. If the MODE bit in the SEQB_CTRL register
 *    is 1, this flag will be set upon completion of an entire B sequence. In this case it must be
 *    cleared by writing a 1 to this SEQB_INT bit. This interrupt must be enabled in the INTEN
 *    register.
 */
#define ADC_FLAGS_SEQB_INT(x)                    (((uint32_t)(((uint32_t)(x)) << ADC_FLAGS_SEQB_INT_SHIFT)) & ADC_FLAGS_SEQB_INT_MASK)

#define ADC_FLAGS_THCMP_INT_MASK                 (0x40000000U)
#define ADC_FLAGS_THCMP_INT_SHIFT                (30U)
/*! THCMP_INT - Threshold Comparison Interrupt. This bit will be set if any of the THCMP flags in
 *    the lower bits of this register are set to 1 (due to an enabled out-of-range or
 *    threshold-crossing event on any channel). Each type of threshold comparison interrupt on each channel must be
 *    individually enabled in the INTEN register to cause this interrupt. This bit will be cleared
 *    when all of the individual threshold flags are cleared via writing 1s to those bits.
 */
#define ADC_FLAGS_THCMP_INT(x)                   (((uint32_t)(((uint32_t)(x)) << ADC_FLAGS_THCMP_INT_SHIFT)) & ADC_FLAGS_THCMP_INT_MASK)

#define ADC_FLAGS_OVR_INT_MASK                   (0x80000000U)
#define ADC_FLAGS_OVR_INT_SHIFT                  (31U)
/*! OVR_INT - Overrun Interrupt flag. Any overrun bit in any of the individual channel data
 *    registers will cause this interrupt. In addition, if the MODE bit in either of the SEQn_CTRL registers
 *    is 0 then the OVERRUN bit in the corresponding SEQn_GDAT register will also cause this
 *    interrupt. This interrupt must be enabled in the INTEN register. This bit will be cleared when all
 *    of the individual overrun bits have been cleared via reading the corresponding data registers.
 */
#define ADC_FLAGS_OVR_INT(x)                     (((uint32_t)(((uint32_t)(x)) << ADC_FLAGS_OVR_INT_SHIFT)) & ADC_FLAGS_OVR_INT_MASK)
/*! @} */


/*!
 * @}
 */ /* end of group ADC_Register_Masks */


/*!
 * @}
 */ /* end of group ADC_Peripheral_Access_Layer */


/*
** End of section using anonymous unions
*/

#if defined(__ARMCC_VERSION)
  #if (__ARMCC_VERSION >= 6010050)
    #pragma clang diagnostic pop
  #else
    #pragma pop
  #endif
#elif defined(__GNUC__)
  /* leave anonymous unions enabled */
#elif defined(__IAR_SYSTEMS_ICC__)
  #pragma language=default
#else
  #error Not supported compiler type
#endif

/*!
 * @}
 */ /* end of group Peripheral_access_layer */


#endif  /* ADC_H_ */
