spyadrian/digital-scale-pcb-firmware/firmware/device/periph5/PERI_I2C.h

/*
** ###################################################################
**     Processors:          LPC804M101JDH20
**                          LPC804M101JDH24
**                          LPC804M101JHI33
**                          LPC804M111JDH24
**                          LPC804UK
**
**     Version:             rev. 1.0, 2018-01-09
**     Build:               b240704
**
**     Abstract:
**         CMSIS Peripheral Access Layer for I2C
**
**     Copyright 1997-2016 Freescale Semiconductor, Inc.
**     Copyright 2016-2024 NXP
**     SPDX-License-Identifier: BSD-3-Clause
**
**     http:                 www.nxp.com
**     mail:                 support@nxp.com
**
**     Revisions:
**     - rev. 1.0 (2018-01-09)
**         Initial version.
**
** ###################################################################
*/

/*!
 * @file I2C.h
 * @version 1.0
 * @date 2018-01-09
 * @brief CMSIS Peripheral Access Layer for I2C
 *
 * CMSIS Peripheral Access Layer for I2C
 */

#if !defined(I2C_H_)
#define I2C_H_                                   /**< Symbol preventing repeated inclusion */

#if (defined(CPU_LPC804M101JDH20) || defined(CPU_LPC804M101JDH24) || defined(CPU_LPC804M101JHI33) || defined(CPU_LPC804M111JDH24) || defined(CPU_LPC804UK))
#include "LPC804_COMMON.h"
#else
  #error "No valid CPU defined!"
#endif

/* ----------------------------------------------------------------------------
   -- Device Peripheral Access Layer
   ---------------------------------------------------------------------------- */

/*!
 * @addtogroup Peripheral_access_layer Device Peripheral Access Layer
 * @{
 */


/*
** Start of section using anonymous unions
*/

#if defined(__ARMCC_VERSION)
  #if (__ARMCC_VERSION >= 6010050)
    #pragma clang diagnostic push
  #else
    #pragma push
    #pragma anon_unions
  #endif
#elif defined(__GNUC__)
  /* anonymous unions are enabled by default */
#elif defined(__IAR_SYSTEMS_ICC__)
  #pragma language=extended
#else
  #error Not supported compiler type
#endif

/* ----------------------------------------------------------------------------
   -- I2C Peripheral Access Layer
   ---------------------------------------------------------------------------- */

/*!
 * @addtogroup I2C_Peripheral_Access_Layer I2C Peripheral Access Layer
 * @{
 */

/** I2C - Size of Registers Arrays */
#define I2C_SLVADR_COUNT                          4u

/** I2C - Register Layout Typedef */
typedef struct {
  __IO uint32_t CFG;                               /**< Configuration for shared functions., offset: 0x0 */
  __IO uint32_t STAT;                              /**< Status register for Master, Slave, and Monitor functions., offset: 0x4 */
  __IO uint32_t INTENSET;                          /**< Interrupt Enable Set and read register., offset: 0x8 */
  __O  uint32_t INTENCLR;                          /**< Interrupt Enable Clear register., offset: 0xC */
  __IO uint32_t TIMEOUT;                           /**< Time-out value register., offset: 0x10 */
  __IO uint32_t CLKDIV;                            /**< Clock pre-divider for the entire I2C interface. This determines what time increments are used for the MSTTIME register, and controls some timing of the Slave function., offset: 0x14 */
  __I  uint32_t INTSTAT;                           /**< Interrupt Status register for Master, Slave, and Monitor functions., offset: 0x18 */
       uint8_t RESERVED_0[4];
  __IO uint32_t MSTCTL;                            /**< Master control register., offset: 0x20 */
  __IO uint32_t MSTTIME;                           /**< Master timing configuration., offset: 0x24 */
  __IO uint32_t MSTDAT;                            /**< Combined Master receiver and transmitter data register., offset: 0x28 */
       uint8_t RESERVED_1[20];
  __IO uint32_t SLVCTL;                            /**< Slave control register., offset: 0x40 */
  __IO uint32_t SLVDAT;                            /**< Combined Slave receiver and transmitter data register., offset: 0x44 */
  __IO uint32_t SLVADR[I2C_SLVADR_COUNT];          /**< Slave address register., array offset: 0x48, array step: 0x4 */
  __IO uint32_t SLVQUAL0;                          /**< Slave Qualification for address 0., offset: 0x58 */
       uint8_t RESERVED_2[36];
  __I  uint32_t MONRXDAT;                          /**< Monitor receiver data register., offset: 0x80 */
} I2C_Type;

/* ----------------------------------------------------------------------------
   -- I2C Register Masks
   ---------------------------------------------------------------------------- */

/*!
 * @addtogroup I2C_Register_Masks I2C Register Masks
 * @{
 */

/*! @name CFG - Configuration for shared functions. */
/*! @{ */

#define I2C_CFG_MSTEN_MASK                       (0x1U)
#define I2C_CFG_MSTEN_SHIFT                      (0U)
/*! MSTEN - Master Enable. When disabled, configurations settings for the Master function are not
 *    changed, but the Master function is internally reset.
 *  0b0..Disabled. The I2C Master function is disabled.
 *  0b1..Enabled. The I2C Master function is enabled.
 */
#define I2C_CFG_MSTEN(x)                         (((uint32_t)(((uint32_t)(x)) << I2C_CFG_MSTEN_SHIFT)) & I2C_CFG_MSTEN_MASK)

#define I2C_CFG_SLVEN_MASK                       (0x2U)
#define I2C_CFG_SLVEN_SHIFT                      (1U)
/*! SLVEN - Slave Enable. When disabled, configurations settings for the Slave function are not
 *    changed, but the Slave function is internally reset.
 *  0b0..Disabled. The I2C slave function is disabled.
 *  0b1..Enabled. The I2C slave function is enabled.
 */
#define I2C_CFG_SLVEN(x)                         (((uint32_t)(((uint32_t)(x)) << I2C_CFG_SLVEN_SHIFT)) & I2C_CFG_SLVEN_MASK)

#define I2C_CFG_MONEN_MASK                       (0x4U)
#define I2C_CFG_MONEN_SHIFT                      (2U)
/*! MONEN - Monitor Enable. When disabled, configurations settings for the Monitor function are not
 *    changed, but the Monitor function is internally reset.
 *  0b0..Disabled. The I2C Monitor function is disabled.
 *  0b1..Enabled. The I2C Monitor function is enabled.
 */
#define I2C_CFG_MONEN(x)                         (((uint32_t)(((uint32_t)(x)) << I2C_CFG_MONEN_SHIFT)) & I2C_CFG_MONEN_MASK)

#define I2C_CFG_TIMEOUTEN_MASK                   (0x8U)
#define I2C_CFG_TIMEOUTEN_SHIFT                  (3U)
/*! TIMEOUTEN - I2C bus Time-out Enable. When disabled, the time-out function is internally reset.
 *  0b0..Disabled. Time-out function is disabled.
 *  0b1..Enabled. Time-out function is enabled. Both types of time-out flags will be generated and will cause
 *       interrupts if they are enabled. Typically, only one time-out will be used in a system.
 */
#define I2C_CFG_TIMEOUTEN(x)                     (((uint32_t)(((uint32_t)(x)) << I2C_CFG_TIMEOUTEN_SHIFT)) & I2C_CFG_TIMEOUTEN_MASK)

#define I2C_CFG_MONCLKSTR_MASK                   (0x10U)
#define I2C_CFG_MONCLKSTR_SHIFT                  (4U)
/*! MONCLKSTR - Monitor function Clock Stretching.
 *  0b0..Disabled. The Monitor function will not perform clock stretching. Software or DMA may not always be able
 *       to read data provided by the Monitor function before it is overwritten. This mode may be used when
 *       non-invasive monitoring is critical.
 *  0b1..Enabled. The Monitor function will perform clock stretching in order to ensure that software or DMA can
 *       read all incoming data supplied by the Monitor function.
 */
#define I2C_CFG_MONCLKSTR(x)                     (((uint32_t)(((uint32_t)(x)) << I2C_CFG_MONCLKSTR_SHIFT)) & I2C_CFG_MONCLKSTR_MASK)
/*! @} */

/*! @name STAT - Status register for Master, Slave, and Monitor functions. */
/*! @{ */

#define I2C_STAT_MSTPENDING_MASK                 (0x1U)
#define I2C_STAT_MSTPENDING_SHIFT                (0U)
/*! MSTPENDING - Master Pending. Indicates that the Master is waiting to continue communication on
 *    the I2C-bus (pending) or is idle. When the master is pending, the MSTSTATE bits indicate what
 *    type of software service if any the master expects. This flag will cause an interrupt when set
 *    if, enabled via the INTENSET register. The MSTPENDING flag is not set when the DMA is handling
 *    an event (if the MSTDMA bit in the MSTCTL register is set). If the master is in the idle
 *    state, and no communication is needed, mask this interrupt.
 *  0b0..In progress. Communication is in progress and the Master function is busy and cannot currently accept a command.
 *  0b1..Pending. The Master function needs software service or is in the idle state. If the master is not in the
 *       idle state, it is waiting to receive or transmit data or the NACK bit.
 */
#define I2C_STAT_MSTPENDING(x)                   (((uint32_t)(((uint32_t)(x)) << I2C_STAT_MSTPENDING_SHIFT)) & I2C_STAT_MSTPENDING_MASK)

#define I2C_STAT_MSTSTATE_MASK                   (0xEU)
#define I2C_STAT_MSTSTATE_SHIFT                  (1U)
/*! MSTSTATE - Master State code. The master state code reflects the master state when the
 *    MSTPENDING bit is set, that is the master is pending or in the idle state. Each value of this field
 *    indicates a specific required service for the Master function. All other values are reserved. See
 *    Table 400 for details of state values and appropriate responses.
 *  0b000..Idle. The Master function is available to be used for a new transaction.
 *  0b001..Receive ready. Received data available (Master Receiver mode). Address plus Read was previously sent and Acknowledged by slave.
 *  0b010..Transmit ready. Data can be transmitted (Master Transmitter mode). Address plus Write was previously sent and Acknowledged by slave.
 *  0b011..NACK Address. Slave NACKed address.
 *  0b100..NACK Data. Slave NACKed transmitted data.
 */
#define I2C_STAT_MSTSTATE(x)                     (((uint32_t)(((uint32_t)(x)) << I2C_STAT_MSTSTATE_SHIFT)) & I2C_STAT_MSTSTATE_MASK)

#define I2C_STAT_MSTARBLOSS_MASK                 (0x10U)
#define I2C_STAT_MSTARBLOSS_SHIFT                (4U)
/*! MSTARBLOSS - Master Arbitration Loss flag. This flag can be cleared by software writing a 1 to
 *    this bit. It is also cleared automatically a 1 is written to MSTCONTINUE.
 *  0b0..No Arbitration Loss has occurred.
 *  0b1..Arbitration loss. The Master function has experienced an Arbitration Loss. At this point, the Master
 *       function has already stopped driving the bus and gone to an idle state. Software can respond by doing nothing,
 *       or by sending a Start in order to attempt to gain control of the bus when it next becomes idle.
 */
#define I2C_STAT_MSTARBLOSS(x)                   (((uint32_t)(((uint32_t)(x)) << I2C_STAT_MSTARBLOSS_SHIFT)) & I2C_STAT_MSTARBLOSS_MASK)

#define I2C_STAT_MSTSTSTPERR_MASK                (0x40U)
#define I2C_STAT_MSTSTSTPERR_SHIFT               (6U)
/*! MSTSTSTPERR - Master Start/Stop Error flag. This flag can be cleared by software writing a 1 to
 *    this bit. It is also cleared automatically a 1 is written to MSTCONTINUE.
 *  0b0..No Start/Stop Error has occurred.
 *  0b1..The Master function has experienced a Start/Stop Error. A Start or Stop was detected at a time when it is
 *       not allowed by the I2C specification. The Master interface has stopped driving the bus and gone to an
 *       idle state, no action is required. A request for a Start could be made, or software could attempt to insure
 *       that the bus has not stalled.
 */
#define I2C_STAT_MSTSTSTPERR(x)                  (((uint32_t)(((uint32_t)(x)) << I2C_STAT_MSTSTSTPERR_SHIFT)) & I2C_STAT_MSTSTSTPERR_MASK)

#define I2C_STAT_SLVPENDING_MASK                 (0x100U)
#define I2C_STAT_SLVPENDING_SHIFT                (8U)
/*! SLVPENDING - Slave Pending. Indicates that the Slave function is waiting to continue
 *    communication on the I2C-bus and needs software service. This flag will cause an interrupt when set if
 *    enabled via INTENSET. The SLVPENDING flag is not set when the DMA is handling an event (if the
 *    SLVDMA bit in the SLVCTL register is set). The SLVPENDING flag is read-only and is
 *    automatically cleared when a 1 is written to the SLVCONTINUE bit in the SLVCTL register. The point in time
 *    when SlvPending is set depends on whether the I2C interface is in HSCAPABLE mode. See Section
 *    25.7.2.2.2. When the I2C interface is configured to be HSCAPABLE, HS master codes are
 *    detected automatically. Due to the requirements of the HS I2C specification, slave addresses must
 *    also be detected automatically, since the address must be acknowledged before the clock can be
 *    stretched.
 *  0b0..In progress. The Slave function does not currently need service.
 *  0b1..Pending. The Slave function needs service. Information on what is needed can be found in the adjacent SLVSTATE field.
 */
#define I2C_STAT_SLVPENDING(x)                   (((uint32_t)(((uint32_t)(x)) << I2C_STAT_SLVPENDING_SHIFT)) & I2C_STAT_SLVPENDING_MASK)

#define I2C_STAT_SLVSTATE_MASK                   (0x600U)
#define I2C_STAT_SLVSTATE_SHIFT                  (9U)
/*! SLVSTATE - Slave State code. Each value of this field indicates a specific required service for
 *    the Slave function. All other values are reserved. See Table 401 for state values and actions.
 *    note that the occurrence of some states and how they are handled are affected by DMA mode and
 *    Automatic Operation modes.
 *  0b00..Slave address. Address plus R/W received. At least one of the four slave addresses has been matched by hardware.
 *  0b01..Slave receive. Received data is available (Slave Receiver mode).
 *  0b10..Slave transmit. Data can be transmitted (Slave Transmitter mode).
 */
#define I2C_STAT_SLVSTATE(x)                     (((uint32_t)(((uint32_t)(x)) << I2C_STAT_SLVSTATE_SHIFT)) & I2C_STAT_SLVSTATE_MASK)

#define I2C_STAT_SLVNOTSTR_MASK                  (0x800U)
#define I2C_STAT_SLVNOTSTR_SHIFT                 (11U)
/*! SLVNOTSTR - Slave Not Stretching. Indicates when the slave function is stretching the I2C clock.
 *    This is needed in order to gracefully invoke Deep Sleep or Power-down modes during slave
 *    operation. This read-only flag reflects the slave function status in real time.
 *  0b0..Stretching. The slave function is currently stretching the I2C bus clock. Deep-Sleep or Power-down mode cannot be entered at this time.
 *  0b1..Not stretching. The slave function is not currently stretching the I 2C bus clock. Deep-sleep or
 *       Power-down mode could be entered at this time.
 */
#define I2C_STAT_SLVNOTSTR(x)                    (((uint32_t)(((uint32_t)(x)) << I2C_STAT_SLVNOTSTR_SHIFT)) & I2C_STAT_SLVNOTSTR_MASK)

#define I2C_STAT_SLVIDX_MASK                     (0x3000U)
#define I2C_STAT_SLVIDX_SHIFT                    (12U)
/*! SLVIDX - Slave address match Index. This field is valid when the I2C slave function has been
 *    selected by receiving an address that matches one of the slave addresses defined by any enabled
 *    slave address registers, and provides an identification of the address that was matched. It is
 *    possible that more than one address could be matched, but only one match can be reported here.
 *  0b00..Address 0. Slave address 0 was matched.
 *  0b01..Address 1. Slave address 1 was matched.
 *  0b10..Address 2. Slave address 2 was matched.
 *  0b11..Address 3. Slave address 3 was matched.
 */
#define I2C_STAT_SLVIDX(x)                       (((uint32_t)(((uint32_t)(x)) << I2C_STAT_SLVIDX_SHIFT)) & I2C_STAT_SLVIDX_MASK)

#define I2C_STAT_SLVSEL_MASK                     (0x4000U)
#define I2C_STAT_SLVSEL_SHIFT                    (14U)
/*! SLVSEL - Slave selected flag. SLVSEL is set after an address match when software tells the Slave
 *    function to acknowledge the address, or when the address has been automatically acknowledged.
 *    It is cleared when another address cycle presents an address that does not match an enabled
 *    address on the Slave function, when slave software decides to NACK a matched address, when
 *    there is a Stop detected on the bus, when the master NACKs slave data, and in some combinations of
 *    Automatic Operation. SLVSEL is not cleared if software NACKs data.
 *  0b0..Not selected. The Slave function is not currently selected.
 *  0b1..Selected. The Slave function is currently selected.
 */
#define I2C_STAT_SLVSEL(x)                       (((uint32_t)(((uint32_t)(x)) << I2C_STAT_SLVSEL_SHIFT)) & I2C_STAT_SLVSEL_MASK)

#define I2C_STAT_SLVDESEL_MASK                   (0x8000U)
#define I2C_STAT_SLVDESEL_SHIFT                  (15U)
/*! SLVDESEL - Slave Deselected flag. This flag will cause an interrupt when set if enabled via
 *    INTENSET. This flag can be cleared by writing a 1 to this bit.
 *  0b0..Not deselected. The Slave function has not become deselected. This does not mean that it is currently
 *       selected. That information can be found in the SLVSEL flag.
 *  0b1..Deselected. The Slave function has become deselected. This is specifically caused by the SLVSEL flag
 *       changing from 1 to 0. See the description of SLVSEL for details on when that event occurs.
 */
#define I2C_STAT_SLVDESEL(x)                     (((uint32_t)(((uint32_t)(x)) << I2C_STAT_SLVDESEL_SHIFT)) & I2C_STAT_SLVDESEL_MASK)

#define I2C_STAT_MONRDY_MASK                     (0x10000U)
#define I2C_STAT_MONRDY_SHIFT                    (16U)
/*! MONRDY - Monitor Ready. This flag is cleared when the MONRXDAT register is read.
 *  0b0..No data. The Monitor function does not currently have data available.
 *  0b1..Data waiting. The Monitor function has data waiting to be read.
 */
#define I2C_STAT_MONRDY(x)                       (((uint32_t)(((uint32_t)(x)) << I2C_STAT_MONRDY_SHIFT)) & I2C_STAT_MONRDY_MASK)

#define I2C_STAT_MONOV_MASK                      (0x20000U)
#define I2C_STAT_MONOV_SHIFT                     (17U)
/*! MONOV - Monitor Overflow flag.
 *  0b0..No overrun. Monitor data has not overrun.
 *  0b1..Overrun. A Monitor data overrun has occurred. This can only happen when Monitor clock stretching not
 *       enabled via the MONCLKSTR bit in the CFG register. Writing 1 to this bit clears the flag.
 */
#define I2C_STAT_MONOV(x)                        (((uint32_t)(((uint32_t)(x)) << I2C_STAT_MONOV_SHIFT)) & I2C_STAT_MONOV_MASK)

#define I2C_STAT_MONACTIVE_MASK                  (0x40000U)
#define I2C_STAT_MONACTIVE_SHIFT                 (18U)
/*! MONACTIVE - Monitor Active flag. Indicates when the Monitor function considers the I 2C bus to
 *    be active. Active is defined here as when some Master is on the bus: a bus Start has occurred
 *    more recently than a bus Stop.
 *  0b0..Inactive. The Monitor function considers the I2C bus to be inactive.
 *  0b1..Active. The Monitor function considers the I2C bus to be active.
 */
#define I2C_STAT_MONACTIVE(x)                    (((uint32_t)(((uint32_t)(x)) << I2C_STAT_MONACTIVE_SHIFT)) & I2C_STAT_MONACTIVE_MASK)

#define I2C_STAT_MONIDLE_MASK                    (0x80000U)
#define I2C_STAT_MONIDLE_SHIFT                   (19U)
/*! MONIDLE - Monitor Idle flag. This flag is set when the Monitor function sees the I2C bus change
 *    from active to inactive. This can be used by software to decide when to process data
 *    accumulated by the Monitor function. This flag will cause an interrupt when set if enabled via the
 *    INTENSET register. The flag can be cleared by writing a 1 to this bit.
 *  0b0..Not idle. The I2C bus is not idle, or this flag has been cleared by software.
 *  0b1..Idle. The I2C bus has gone idle at least once since the last time this flag was cleared by software.
 */
#define I2C_STAT_MONIDLE(x)                      (((uint32_t)(((uint32_t)(x)) << I2C_STAT_MONIDLE_SHIFT)) & I2C_STAT_MONIDLE_MASK)

#define I2C_STAT_EVENTTIMEOUT_MASK               (0x1000000U)
#define I2C_STAT_EVENTTIMEOUT_SHIFT              (24U)
/*! EVENTTIMEOUT - Event Time-out Interrupt flag. Indicates when the time between events has been
 *    longer than the time specified by the TIMEOUT register. Events include Start, Stop, and clock
 *    edges. The flag is cleared by writing a 1 to this bit. No time-out is created when the I2C-bus
 *    is idle.
 *  0b0..No time-out. I2C bus events have not caused a time-out.
 *  0b1..Event time-out. The time between I2C bus events has been longer than the time specified by the TIMEOUT register.
 */
#define I2C_STAT_EVENTTIMEOUT(x)                 (((uint32_t)(((uint32_t)(x)) << I2C_STAT_EVENTTIMEOUT_SHIFT)) & I2C_STAT_EVENTTIMEOUT_MASK)

#define I2C_STAT_SCLTIMEOUT_MASK                 (0x2000000U)
#define I2C_STAT_SCLTIMEOUT_SHIFT                (25U)
/*! SCLTIMEOUT - SCL Time-out Interrupt flag. Indicates when SCL has remained low longer than the
 *    time specific by the TIMEOUT register. The flag is cleared by writing a 1 to this bit.
 *  0b0..No time-out. SCL low time has not caused a time-out.
 *  0b1..Time-out. SCL low time has caused a time-out.
 */
#define I2C_STAT_SCLTIMEOUT(x)                   (((uint32_t)(((uint32_t)(x)) << I2C_STAT_SCLTIMEOUT_SHIFT)) & I2C_STAT_SCLTIMEOUT_MASK)
/*! @} */

/*! @name INTENSET - Interrupt Enable Set and read register. */
/*! @{ */

#define I2C_INTENSET_MSTPENDINGEN_MASK           (0x1U)
#define I2C_INTENSET_MSTPENDINGEN_SHIFT          (0U)
/*! MSTPENDINGEN - Master Pending interrupt Enable.
 *  0b0..Disabled. The MstPending interrupt is disabled.
 *  0b1..Enabled. The MstPending interrupt is enabled.
 */
#define I2C_INTENSET_MSTPENDINGEN(x)             (((uint32_t)(((uint32_t)(x)) << I2C_INTENSET_MSTPENDINGEN_SHIFT)) & I2C_INTENSET_MSTPENDINGEN_MASK)

#define I2C_INTENSET_MSTARBLOSSEN_MASK           (0x10U)
#define I2C_INTENSET_MSTARBLOSSEN_SHIFT          (4U)
/*! MSTARBLOSSEN - Master Arbitration Loss interrupt Enable.
 *  0b0..Disabled. The MstArbLoss interrupt is disabled.
 *  0b1..Enabled. The MstArbLoss interrupt is enabled.
 */
#define I2C_INTENSET_MSTARBLOSSEN(x)             (((uint32_t)(((uint32_t)(x)) << I2C_INTENSET_MSTARBLOSSEN_SHIFT)) & I2C_INTENSET_MSTARBLOSSEN_MASK)

#define I2C_INTENSET_MSTSTSTPERREN_MASK          (0x40U)
#define I2C_INTENSET_MSTSTSTPERREN_SHIFT         (6U)
/*! MSTSTSTPERREN - Master Start/Stop Error interrupt Enable.
 *  0b0..Disabled. The MstStStpErr interrupt is disabled.
 *  0b1..Enabled. The MstStStpErr interrupt is enabled.
 */
#define I2C_INTENSET_MSTSTSTPERREN(x)            (((uint32_t)(((uint32_t)(x)) << I2C_INTENSET_MSTSTSTPERREN_SHIFT)) & I2C_INTENSET_MSTSTSTPERREN_MASK)

#define I2C_INTENSET_SLVPENDINGEN_MASK           (0x100U)
#define I2C_INTENSET_SLVPENDINGEN_SHIFT          (8U)
/*! SLVPENDINGEN - Slave Pending interrupt Enable.
 *  0b0..Disabled. The SlvPending interrupt is disabled.
 *  0b1..Enabled. The SlvPending interrupt is enabled.
 */
#define I2C_INTENSET_SLVPENDINGEN(x)             (((uint32_t)(((uint32_t)(x)) << I2C_INTENSET_SLVPENDINGEN_SHIFT)) & I2C_INTENSET_SLVPENDINGEN_MASK)

#define I2C_INTENSET_SLVNOTSTREN_MASK            (0x800U)
#define I2C_INTENSET_SLVNOTSTREN_SHIFT           (11U)
/*! SLVNOTSTREN - Slave Not Stretching interrupt Enable.
 *  0b0..Disabled. The SlvNotStr interrupt is disabled.
 *  0b1..Enabled. The SlvNotStr interrupt is enabled.
 */
#define I2C_INTENSET_SLVNOTSTREN(x)              (((uint32_t)(((uint32_t)(x)) << I2C_INTENSET_SLVNOTSTREN_SHIFT)) & I2C_INTENSET_SLVNOTSTREN_MASK)

#define I2C_INTENSET_SLVDESELEN_MASK             (0x8000U)
#define I2C_INTENSET_SLVDESELEN_SHIFT            (15U)
/*! SLVDESELEN - Slave Deselect interrupt Enable.
 *  0b0..Disabled. The SlvDeSel interrupt is disabled.
 *  0b1..Enabled. The SlvDeSel interrupt is enabled.
 */
#define I2C_INTENSET_SLVDESELEN(x)               (((uint32_t)(((uint32_t)(x)) << I2C_INTENSET_SLVDESELEN_SHIFT)) & I2C_INTENSET_SLVDESELEN_MASK)

#define I2C_INTENSET_MONRDYEN_MASK               (0x10000U)
#define I2C_INTENSET_MONRDYEN_SHIFT              (16U)
/*! MONRDYEN - Monitor data Ready interrupt Enable.
 *  0b0..Disabled. The MonRdy interrupt is disabled.
 *  0b1..Enabled. The MonRdy interrupt is enabled.
 */
#define I2C_INTENSET_MONRDYEN(x)                 (((uint32_t)(((uint32_t)(x)) << I2C_INTENSET_MONRDYEN_SHIFT)) & I2C_INTENSET_MONRDYEN_MASK)

#define I2C_INTENSET_MONOVEN_MASK                (0x20000U)
#define I2C_INTENSET_MONOVEN_SHIFT               (17U)
/*! MONOVEN - Monitor Overrun interrupt Enable.
 *  0b0..Disabled. The MonOv interrupt is disabled.
 *  0b1..Enabled. The MonOv interrupt is enabled.
 */
#define I2C_INTENSET_MONOVEN(x)                  (((uint32_t)(((uint32_t)(x)) << I2C_INTENSET_MONOVEN_SHIFT)) & I2C_INTENSET_MONOVEN_MASK)

#define I2C_INTENSET_MONIDLEEN_MASK              (0x80000U)
#define I2C_INTENSET_MONIDLEEN_SHIFT             (19U)
/*! MONIDLEEN - Monitor Idle interrupt Enable.
 *  0b0..Disabled. The MonIdle interrupt is disabled.
 *  0b1..Enabled. The MonIdle interrupt is enabled.
 */
#define I2C_INTENSET_MONIDLEEN(x)                (((uint32_t)(((uint32_t)(x)) << I2C_INTENSET_MONIDLEEN_SHIFT)) & I2C_INTENSET_MONIDLEEN_MASK)

#define I2C_INTENSET_EVENTTIMEOUTEN_MASK         (0x1000000U)
#define I2C_INTENSET_EVENTTIMEOUTEN_SHIFT        (24U)
/*! EVENTTIMEOUTEN - Event time-out interrupt Enable.
 *  0b0..Disabled. The Event time-out interrupt is disabled.
 *  0b1..Enabled. The Event time-out interrupt is enabled.
 */
#define I2C_INTENSET_EVENTTIMEOUTEN(x)           (((uint32_t)(((uint32_t)(x)) << I2C_INTENSET_EVENTTIMEOUTEN_SHIFT)) & I2C_INTENSET_EVENTTIMEOUTEN_MASK)

#define I2C_INTENSET_SCLTIMEOUTEN_MASK           (0x2000000U)
#define I2C_INTENSET_SCLTIMEOUTEN_SHIFT          (25U)
/*! SCLTIMEOUTEN - SCL time-out interrupt Enable.
 *  0b0..Disabled. The SCL time-out interrupt is disabled.
 *  0b1..Enabled. The SCL time-out interrupt is enabled.
 */
#define I2C_INTENSET_SCLTIMEOUTEN(x)             (((uint32_t)(((uint32_t)(x)) << I2C_INTENSET_SCLTIMEOUTEN_SHIFT)) & I2C_INTENSET_SCLTIMEOUTEN_MASK)
/*! @} */

/*! @name INTENCLR - Interrupt Enable Clear register. */
/*! @{ */

#define I2C_INTENCLR_MSTPENDINGCLR_MASK          (0x1U)
#define I2C_INTENCLR_MSTPENDINGCLR_SHIFT         (0U)
/*! MSTPENDINGCLR - Master Pending interrupt clear. Writing 1 to this bit clears the corresponding
 *    bit in the INTENSET register if implemented.
 */
#define I2C_INTENCLR_MSTPENDINGCLR(x)            (((uint32_t)(((uint32_t)(x)) << I2C_INTENCLR_MSTPENDINGCLR_SHIFT)) & I2C_INTENCLR_MSTPENDINGCLR_MASK)

#define I2C_INTENCLR_MSTARBLOSSCLR_MASK          (0x10U)
#define I2C_INTENCLR_MSTARBLOSSCLR_SHIFT         (4U)
/*! MSTARBLOSSCLR - Master Arbitration Loss interrupt clear. */
#define I2C_INTENCLR_MSTARBLOSSCLR(x)            (((uint32_t)(((uint32_t)(x)) << I2C_INTENCLR_MSTARBLOSSCLR_SHIFT)) & I2C_INTENCLR_MSTARBLOSSCLR_MASK)

#define I2C_INTENCLR_MSTSTSTPERRCLR_MASK         (0x40U)
#define I2C_INTENCLR_MSTSTSTPERRCLR_SHIFT        (6U)
/*! MSTSTSTPERRCLR - Master Start/Stop Error interrupt clear. */
#define I2C_INTENCLR_MSTSTSTPERRCLR(x)           (((uint32_t)(((uint32_t)(x)) << I2C_INTENCLR_MSTSTSTPERRCLR_SHIFT)) & I2C_INTENCLR_MSTSTSTPERRCLR_MASK)

#define I2C_INTENCLR_SLVPENDINGCLR_MASK          (0x100U)
#define I2C_INTENCLR_SLVPENDINGCLR_SHIFT         (8U)
/*! SLVPENDINGCLR - Slave Pending interrupt clear. */
#define I2C_INTENCLR_SLVPENDINGCLR(x)            (((uint32_t)(((uint32_t)(x)) << I2C_INTENCLR_SLVPENDINGCLR_SHIFT)) & I2C_INTENCLR_SLVPENDINGCLR_MASK)

#define I2C_INTENCLR_SLVNOTSTRCLR_MASK           (0x800U)
#define I2C_INTENCLR_SLVNOTSTRCLR_SHIFT          (11U)
/*! SLVNOTSTRCLR - Slave Not Stretching interrupt clear. */
#define I2C_INTENCLR_SLVNOTSTRCLR(x)             (((uint32_t)(((uint32_t)(x)) << I2C_INTENCLR_SLVNOTSTRCLR_SHIFT)) & I2C_INTENCLR_SLVNOTSTRCLR_MASK)

#define I2C_INTENCLR_SLVDESELCLR_MASK            (0x8000U)
#define I2C_INTENCLR_SLVDESELCLR_SHIFT           (15U)
/*! SLVDESELCLR - Slave Deselect interrupt clear. */
#define I2C_INTENCLR_SLVDESELCLR(x)              (((uint32_t)(((uint32_t)(x)) << I2C_INTENCLR_SLVDESELCLR_SHIFT)) & I2C_INTENCLR_SLVDESELCLR_MASK)

#define I2C_INTENCLR_MONRDYCLR_MASK              (0x10000U)
#define I2C_INTENCLR_MONRDYCLR_SHIFT             (16U)
/*! MONRDYCLR - Monitor data Ready interrupt clear. */
#define I2C_INTENCLR_MONRDYCLR(x)                (((uint32_t)(((uint32_t)(x)) << I2C_INTENCLR_MONRDYCLR_SHIFT)) & I2C_INTENCLR_MONRDYCLR_MASK)

#define I2C_INTENCLR_MONOVCLR_MASK               (0x20000U)
#define I2C_INTENCLR_MONOVCLR_SHIFT              (17U)
/*! MONOVCLR - Monitor Overrun interrupt clear. */
#define I2C_INTENCLR_MONOVCLR(x)                 (((uint32_t)(((uint32_t)(x)) << I2C_INTENCLR_MONOVCLR_SHIFT)) & I2C_INTENCLR_MONOVCLR_MASK)

#define I2C_INTENCLR_MONIDLECLR_MASK             (0x80000U)
#define I2C_INTENCLR_MONIDLECLR_SHIFT            (19U)
/*! MONIDLECLR - Monitor Idle interrupt clear. */
#define I2C_INTENCLR_MONIDLECLR(x)               (((uint32_t)(((uint32_t)(x)) << I2C_INTENCLR_MONIDLECLR_SHIFT)) & I2C_INTENCLR_MONIDLECLR_MASK)

#define I2C_INTENCLR_EVENTTIMEOUTCLR_MASK        (0x1000000U)
#define I2C_INTENCLR_EVENTTIMEOUTCLR_SHIFT       (24U)
/*! EVENTTIMEOUTCLR - Event time-out interrupt clear. */
#define I2C_INTENCLR_EVENTTIMEOUTCLR(x)          (((uint32_t)(((uint32_t)(x)) << I2C_INTENCLR_EVENTTIMEOUTCLR_SHIFT)) & I2C_INTENCLR_EVENTTIMEOUTCLR_MASK)

#define I2C_INTENCLR_SCLTIMEOUTCLR_MASK          (0x2000000U)
#define I2C_INTENCLR_SCLTIMEOUTCLR_SHIFT         (25U)
/*! SCLTIMEOUTCLR - SCL time-out interrupt clear. */
#define I2C_INTENCLR_SCLTIMEOUTCLR(x)            (((uint32_t)(((uint32_t)(x)) << I2C_INTENCLR_SCLTIMEOUTCLR_SHIFT)) & I2C_INTENCLR_SCLTIMEOUTCLR_MASK)
/*! @} */

/*! @name TIMEOUT - Time-out value register. */
/*! @{ */

#define I2C_TIMEOUT_TOMIN_MASK                   (0xFU)
#define I2C_TIMEOUT_TOMIN_SHIFT                  (0U)
/*! TOMIN - Time-out time value, bottom four bits. These are hard-wired to 0xF. This gives a minimum
 *    time-out of 16 I2C function clocks and also a time-out resolution of 16 I2C function clocks.
 */
#define I2C_TIMEOUT_TOMIN(x)                     (((uint32_t)(((uint32_t)(x)) << I2C_TIMEOUT_TOMIN_SHIFT)) & I2C_TIMEOUT_TOMIN_MASK)

#define I2C_TIMEOUT_TO_MASK                      (0xFFF0U)
#define I2C_TIMEOUT_TO_SHIFT                     (4U)
/*! TO - Time-out time value. Specifies the time-out interval value in increments of 16 I 2C
 *    function clocks, as defined by the CLKDIV register. To change this value while I2C is in operation,
 *    disable all time-outs, write a new value to TIMEOUT, then re-enable time-outs. 0x000 = A
 *    time-out will occur after 16 counts of the I2C function clock. 0x001 = A time-out will occur after
 *    32 counts of the I2C function clock. 0xFFF = A time-out will occur after 65,536 counts of the
 *    I2C function clock.
 */
#define I2C_TIMEOUT_TO(x)                        (((uint32_t)(((uint32_t)(x)) << I2C_TIMEOUT_TO_SHIFT)) & I2C_TIMEOUT_TO_MASK)
/*! @} */

/*! @name CLKDIV - Clock pre-divider for the entire I2C interface. This determines what time increments are used for the MSTTIME register, and controls some timing of the Slave function. */
/*! @{ */

#define I2C_CLKDIV_DIVVAL_MASK                   (0xFFFFU)
#define I2C_CLKDIV_DIVVAL_SHIFT                  (0U)
/*! DIVVAL - This field controls how the Flexcomm clock (FCLK) is used by the I2C functions that
 *    need an internal clock in order to operate. 0x0000 = FCLK is used directly by the I2C. 0x0001 =
 *    FCLK is divided by 2 before use. 0x0002 = FCLK is divided by 3 before use. 0xFFFF = FCLK is
 *    divided by 65,536 before use.
 */
#define I2C_CLKDIV_DIVVAL(x)                     (((uint32_t)(((uint32_t)(x)) << I2C_CLKDIV_DIVVAL_SHIFT)) & I2C_CLKDIV_DIVVAL_MASK)
/*! @} */

/*! @name INTSTAT - Interrupt Status register for Master, Slave, and Monitor functions. */
/*! @{ */

#define I2C_INTSTAT_MSTPENDING_MASK              (0x1U)
#define I2C_INTSTAT_MSTPENDING_SHIFT             (0U)
/*! MSTPENDING - Master Pending. */
#define I2C_INTSTAT_MSTPENDING(x)                (((uint32_t)(((uint32_t)(x)) << I2C_INTSTAT_MSTPENDING_SHIFT)) & I2C_INTSTAT_MSTPENDING_MASK)

#define I2C_INTSTAT_MSTARBLOSS_MASK              (0x10U)
#define I2C_INTSTAT_MSTARBLOSS_SHIFT             (4U)
/*! MSTARBLOSS - Master Arbitration Loss flag. */
#define I2C_INTSTAT_MSTARBLOSS(x)                (((uint32_t)(((uint32_t)(x)) << I2C_INTSTAT_MSTARBLOSS_SHIFT)) & I2C_INTSTAT_MSTARBLOSS_MASK)

#define I2C_INTSTAT_MSTSTSTPERR_MASK             (0x40U)
#define I2C_INTSTAT_MSTSTSTPERR_SHIFT            (6U)
/*! MSTSTSTPERR - Master Start/Stop Error flag. */
#define I2C_INTSTAT_MSTSTSTPERR(x)               (((uint32_t)(((uint32_t)(x)) << I2C_INTSTAT_MSTSTSTPERR_SHIFT)) & I2C_INTSTAT_MSTSTSTPERR_MASK)

#define I2C_INTSTAT_SLVPENDING_MASK              (0x100U)
#define I2C_INTSTAT_SLVPENDING_SHIFT             (8U)
/*! SLVPENDING - Slave Pending. */
#define I2C_INTSTAT_SLVPENDING(x)                (((uint32_t)(((uint32_t)(x)) << I2C_INTSTAT_SLVPENDING_SHIFT)) & I2C_INTSTAT_SLVPENDING_MASK)

#define I2C_INTSTAT_SLVNOTSTR_MASK               (0x800U)
#define I2C_INTSTAT_SLVNOTSTR_SHIFT              (11U)
/*! SLVNOTSTR - Slave Not Stretching status. */
#define I2C_INTSTAT_SLVNOTSTR(x)                 (((uint32_t)(((uint32_t)(x)) << I2C_INTSTAT_SLVNOTSTR_SHIFT)) & I2C_INTSTAT_SLVNOTSTR_MASK)

#define I2C_INTSTAT_SLVDESEL_MASK                (0x8000U)
#define I2C_INTSTAT_SLVDESEL_SHIFT               (15U)
/*! SLVDESEL - Slave Deselected flag. */
#define I2C_INTSTAT_SLVDESEL(x)                  (((uint32_t)(((uint32_t)(x)) << I2C_INTSTAT_SLVDESEL_SHIFT)) & I2C_INTSTAT_SLVDESEL_MASK)

#define I2C_INTSTAT_MONRDY_MASK                  (0x10000U)
#define I2C_INTSTAT_MONRDY_SHIFT                 (16U)
/*! MONRDY - Monitor Ready. */
#define I2C_INTSTAT_MONRDY(x)                    (((uint32_t)(((uint32_t)(x)) << I2C_INTSTAT_MONRDY_SHIFT)) & I2C_INTSTAT_MONRDY_MASK)

#define I2C_INTSTAT_MONOV_MASK                   (0x20000U)
#define I2C_INTSTAT_MONOV_SHIFT                  (17U)
/*! MONOV - Monitor Overflow flag. */
#define I2C_INTSTAT_MONOV(x)                     (((uint32_t)(((uint32_t)(x)) << I2C_INTSTAT_MONOV_SHIFT)) & I2C_INTSTAT_MONOV_MASK)

#define I2C_INTSTAT_MONIDLE_MASK                 (0x80000U)
#define I2C_INTSTAT_MONIDLE_SHIFT                (19U)
/*! MONIDLE - Monitor Idle flag. */
#define I2C_INTSTAT_MONIDLE(x)                   (((uint32_t)(((uint32_t)(x)) << I2C_INTSTAT_MONIDLE_SHIFT)) & I2C_INTSTAT_MONIDLE_MASK)

#define I2C_INTSTAT_EVENTTIMEOUT_MASK            (0x1000000U)
#define I2C_INTSTAT_EVENTTIMEOUT_SHIFT           (24U)
/*! EVENTTIMEOUT - Event time-out Interrupt flag. */
#define I2C_INTSTAT_EVENTTIMEOUT(x)              (((uint32_t)(((uint32_t)(x)) << I2C_INTSTAT_EVENTTIMEOUT_SHIFT)) & I2C_INTSTAT_EVENTTIMEOUT_MASK)

#define I2C_INTSTAT_SCLTIMEOUT_MASK              (0x2000000U)
#define I2C_INTSTAT_SCLTIMEOUT_SHIFT             (25U)
/*! SCLTIMEOUT - SCL time-out Interrupt flag. */
#define I2C_INTSTAT_SCLTIMEOUT(x)                (((uint32_t)(((uint32_t)(x)) << I2C_INTSTAT_SCLTIMEOUT_SHIFT)) & I2C_INTSTAT_SCLTIMEOUT_MASK)
/*! @} */

/*! @name MSTCTL - Master control register. */
/*! @{ */

#define I2C_MSTCTL_MSTCONTINUE_MASK              (0x1U)
#define I2C_MSTCTL_MSTCONTINUE_SHIFT             (0U)
/*! MSTCONTINUE - Master Continue.
 *  0b0..No effect.
 *  0b1..Informs the Master function to continue to the next operation.
 */
#define I2C_MSTCTL_MSTCONTINUE(x)                (((uint32_t)(((uint32_t)(x)) << I2C_MSTCTL_MSTCONTINUE_SHIFT)) & I2C_MSTCTL_MSTCONTINUE_MASK)

#define I2C_MSTCTL_MSTSTART_MASK                 (0x2U)
#define I2C_MSTCTL_MSTSTART_SHIFT                (1U)
/*! MSTSTART - Master Start control.
 *  0b0..No effect.
 *  0b1..Start. A Start will be generated on the I2C bus at the next allowed time.
 */
#define I2C_MSTCTL_MSTSTART(x)                   (((uint32_t)(((uint32_t)(x)) << I2C_MSTCTL_MSTSTART_SHIFT)) & I2C_MSTCTL_MSTSTART_MASK)

#define I2C_MSTCTL_MSTSTOP_MASK                  (0x4U)
#define I2C_MSTCTL_MSTSTOP_SHIFT                 (2U)
/*! MSTSTOP - Master Stop control.
 *  0b0..No effect.
 *  0b1..Stop. A Stop will be generated on the I2C bus at the next allowed time, preceded by a NACK to the slave
 *       if the master is receiving data from the slave (Master Receiver mode).
 */
#define I2C_MSTCTL_MSTSTOP(x)                    (((uint32_t)(((uint32_t)(x)) << I2C_MSTCTL_MSTSTOP_SHIFT)) & I2C_MSTCTL_MSTSTOP_MASK)
/*! @} */

/*! @name MSTTIME - Master timing configuration. */
/*! @{ */

#define I2C_MSTTIME_MSTSCLLOW_MASK               (0x7U)
#define I2C_MSTTIME_MSTSCLLOW_SHIFT              (0U)
/*! MSTSCLLOW - Master SCL Low time. Specifies the minimum low time that will be asserted by this
 *    master on SCL. Other devices on the bus (masters or slaves) could lengthen this time. This
 *    corresponds to the parameter t LOW in the I2C bus specification. I2C bus specification parameters
 *    tBUF and tSU;STA have the same values and are also controlled by MSTSCLLOW.
 *  0b000..2 clocks. Minimum SCL low time is 2 clocks of the I2C clock pre-divider.
 *  0b001..3 clocks. Minimum SCL low time is 3 clocks of the I2C clock pre-divider.
 *  0b010..4 clocks. Minimum SCL low time is 4 clocks of the I2C clock pre-divider.
 *  0b011..5 clocks. Minimum SCL low time is 5 clocks of the I2C clock pre-divider.
 *  0b100..6 clocks. Minimum SCL low time is 6 clocks of the I2C clock pre-divider.
 *  0b101..7 clocks. Minimum SCL low time is 7 clocks of the I2C clock pre-divider.
 *  0b110..8 clocks. Minimum SCL low time is 8 clocks of the I2C clock pre-divider.
 *  0b111..9 clocks. Minimum SCL low time is 9 clocks of the I2C clock pre-divider.
 */
#define I2C_MSTTIME_MSTSCLLOW(x)                 (((uint32_t)(((uint32_t)(x)) << I2C_MSTTIME_MSTSCLLOW_SHIFT)) & I2C_MSTTIME_MSTSCLLOW_MASK)

#define I2C_MSTTIME_MSTSCLHIGH_MASK              (0x70U)
#define I2C_MSTTIME_MSTSCLHIGH_SHIFT             (4U)
/*! MSTSCLHIGH - Master SCL High time. Specifies the minimum high time that will be asserted by this
 *    master on SCL. Other masters in a multi-master system could shorten this time. This
 *    corresponds to the parameter tHIGH in the I2C bus specification. I2C bus specification parameters
 *    tSU;STO and tHD;STA have the same values and are also controlled by MSTSCLHIGH.
 *  0b000..2 clocks. Minimum SCL high time is 2 clock of the I2C clock pre-divider.
 *  0b001..3 clocks. Minimum SCL high time is 3 clocks of the I2C clock pre-divider .
 *  0b010..4 clocks. Minimum SCL high time is 4 clock of the I2C clock pre-divider.
 *  0b011..5 clocks. Minimum SCL high time is 5 clock of the I2C clock pre-divider.
 *  0b100..6 clocks. Minimum SCL high time is 6 clock of the I2C clock pre-divider.
 *  0b101..7 clocks. Minimum SCL high time is 7 clock of the I2C clock pre-divider.
 *  0b110..8 clocks. Minimum SCL high time is 8 clock of the I2C clock pre-divider.
 *  0b111..9 clocks. Minimum SCL high time is 9 clocks of the I2C clock pre-divider.
 */
#define I2C_MSTTIME_MSTSCLHIGH(x)                (((uint32_t)(((uint32_t)(x)) << I2C_MSTTIME_MSTSCLHIGH_SHIFT)) & I2C_MSTTIME_MSTSCLHIGH_MASK)
/*! @} */

/*! @name MSTDAT - Combined Master receiver and transmitter data register. */
/*! @{ */

#define I2C_MSTDAT_DATA_MASK                     (0xFFU)
#define I2C_MSTDAT_DATA_SHIFT                    (0U)
/*! DATA - Master function data register. Read: read the most recently received data for the Master
 *    function. Write: transmit data using the Master function.
 */
#define I2C_MSTDAT_DATA(x)                       (((uint32_t)(((uint32_t)(x)) << I2C_MSTDAT_DATA_SHIFT)) & I2C_MSTDAT_DATA_MASK)
/*! @} */

/*! @name SLVCTL - Slave control register. */
/*! @{ */

#define I2C_SLVCTL_SLVCONTINUE_MASK              (0x1U)
#define I2C_SLVCTL_SLVCONTINUE_SHIFT             (0U)
/*! SLVCONTINUE - Slave Continue.
 *  0b0..No effect.
 *  0b1..Informs the Slave function to continue to the next operation.
 */
#define I2C_SLVCTL_SLVCONTINUE(x)                (((uint32_t)(((uint32_t)(x)) << I2C_SLVCTL_SLVCONTINUE_SHIFT)) & I2C_SLVCTL_SLVCONTINUE_MASK)

#define I2C_SLVCTL_SLVNACK_MASK                  (0x2U)
#define I2C_SLVCTL_SLVNACK_SHIFT                 (1U)
/*! SLVNACK - Slave NACK.
 *  0b0..No effect.
 *  0b1..NACK. Causes the Slave function to NACK the master when the slave is receiving data from the master (Slave Receiver mode).
 */
#define I2C_SLVCTL_SLVNACK(x)                    (((uint32_t)(((uint32_t)(x)) << I2C_SLVCTL_SLVNACK_SHIFT)) & I2C_SLVCTL_SLVNACK_MASK)
/*! @} */

/*! @name SLVDAT - Combined Slave receiver and transmitter data register. */
/*! @{ */

#define I2C_SLVDAT_DATA_MASK                     (0xFFU)
#define I2C_SLVDAT_DATA_SHIFT                    (0U)
/*! DATA - Slave function data register. Read: read the most recently received data for the Slave
 *    function. Write: transmit data using the Slave function.
 */
#define I2C_SLVDAT_DATA(x)                       (((uint32_t)(((uint32_t)(x)) << I2C_SLVDAT_DATA_SHIFT)) & I2C_SLVDAT_DATA_MASK)
/*! @} */

/*! @name SLVADR - Slave address register. */
/*! @{ */

#define I2C_SLVADR_SADISABLE_MASK                (0x1U)
#define I2C_SLVADR_SADISABLE_SHIFT               (0U)
/*! SADISABLE - Slave Address n Disable.
 *  0b0..Enabled. Slave Address n is enabled.
 *  0b1..Ignored Slave Address n is ignored.
 */
#define I2C_SLVADR_SADISABLE(x)                  (((uint32_t)(((uint32_t)(x)) << I2C_SLVADR_SADISABLE_SHIFT)) & I2C_SLVADR_SADISABLE_MASK)

#define I2C_SLVADR_SLVADR_MASK                   (0xFEU)
#define I2C_SLVADR_SLVADR_SHIFT                  (1U)
/*! SLVADR - Slave Address. Seven bit slave address that is compared to received addresses if enabled. */
#define I2C_SLVADR_SLVADR(x)                     (((uint32_t)(((uint32_t)(x)) << I2C_SLVADR_SLVADR_SHIFT)) & I2C_SLVADR_SLVADR_MASK)
/*! @} */

/*! @name SLVQUAL0 - Slave Qualification for address 0. */
/*! @{ */

#define I2C_SLVQUAL0_QUALMODE0_MASK              (0x1U)
#define I2C_SLVQUAL0_QUALMODE0_SHIFT             (0U)
/*! QUALMODE0 - Qualify mode for slave address 0.
 *  0b0..Mask. The SLVQUAL0 field is used as a logical mask for matching address 0.
 *  0b1..Extend. The SLVQUAL0 field is used to extend address 0 matching in a range of addresses.
 */
#define I2C_SLVQUAL0_QUALMODE0(x)                (((uint32_t)(((uint32_t)(x)) << I2C_SLVQUAL0_QUALMODE0_SHIFT)) & I2C_SLVQUAL0_QUALMODE0_MASK)

#define I2C_SLVQUAL0_SLVQUAL0_MASK               (0xFEU)
#define I2C_SLVQUAL0_SLVQUAL0_SHIFT              (1U)
/*! SLVQUAL0 - Slave address Qualifier for address 0. A value of 0 causes the address in SLVADR0 to
 *    be used as-is, assuming that it is enabled. If QUALMODE0 = 0, any bit in this field which is
 *    set to 1 will cause an automatic match of the corresponding bit of the received address when it
 *    is compared to the SLVADR0 register. If QUALMODE0 = 1, an address range is matched for
 *    address 0. This range extends from the value defined by SLVADR0 to the address defined by SLVQUAL0
 *    (address matches when SLVADR0[7:1] <= received address <= SLVQUAL0[7:1]).
 */
#define I2C_SLVQUAL0_SLVQUAL0(x)                 (((uint32_t)(((uint32_t)(x)) << I2C_SLVQUAL0_SLVQUAL0_SHIFT)) & I2C_SLVQUAL0_SLVQUAL0_MASK)
/*! @} */

/*! @name MONRXDAT - Monitor receiver data register. */
/*! @{ */

#define I2C_MONRXDAT_MONRXDAT_MASK               (0xFFU)
#define I2C_MONRXDAT_MONRXDAT_SHIFT              (0U)
/*! MONRXDAT - Monitor function Receiver Data. This reflects every data byte that passes on the I2C pins. */
#define I2C_MONRXDAT_MONRXDAT(x)                 (((uint32_t)(((uint32_t)(x)) << I2C_MONRXDAT_MONRXDAT_SHIFT)) & I2C_MONRXDAT_MONRXDAT_MASK)

#define I2C_MONRXDAT_MONSTART_MASK               (0x100U)
#define I2C_MONRXDAT_MONSTART_SHIFT              (8U)
/*! MONSTART - Monitor Received Start.
 *  0b0..No start detected. The Monitor function has not detected a Start event on the I2C bus.
 *  0b1..Start detected. The Monitor function has detected a Start event on the I2C bus.
 */
#define I2C_MONRXDAT_MONSTART(x)                 (((uint32_t)(((uint32_t)(x)) << I2C_MONRXDAT_MONSTART_SHIFT)) & I2C_MONRXDAT_MONSTART_MASK)

#define I2C_MONRXDAT_MONRESTART_MASK             (0x200U)
#define I2C_MONRXDAT_MONRESTART_SHIFT            (9U)
/*! MONRESTART - Monitor Received Repeated Start.
 *  0b0..No repeated start detected. The Monitor function has not detected a Repeated Start event on the I2C bus.
 *  0b1..Repeated start detected. The Monitor function has detected a Repeated Start event on the I2C bus.
 */
#define I2C_MONRXDAT_MONRESTART(x)               (((uint32_t)(((uint32_t)(x)) << I2C_MONRXDAT_MONRESTART_SHIFT)) & I2C_MONRXDAT_MONRESTART_MASK)

#define I2C_MONRXDAT_MONNACK_MASK                (0x400U)
#define I2C_MONRXDAT_MONNACK_SHIFT               (10U)
/*! MONNACK - Monitor Received NACK.
 *  0b0..Acknowledged. The data currently being provided by the Monitor function was acknowledged by at least one master or slave receiver.
 *  0b1..Not acknowledged. The data currently being provided by the Monitor function was not acknowledged by any receiver.
 */
#define I2C_MONRXDAT_MONNACK(x)                  (((uint32_t)(((uint32_t)(x)) << I2C_MONRXDAT_MONNACK_SHIFT)) & I2C_MONRXDAT_MONNACK_MASK)
/*! @} */


/*!
 * @}
 */ /* end of group I2C_Register_Masks */


/*!
 * @}
 */ /* end of group I2C_Peripheral_Access_Layer */


/*
** End of section using anonymous unions
*/

#if defined(__ARMCC_VERSION)
  #if (__ARMCC_VERSION >= 6010050)
    #pragma clang diagnostic pop
  #else
    #pragma pop
  #endif
#elif defined(__GNUC__)
  /* leave anonymous unions enabled */
#elif defined(__IAR_SYSTEMS_ICC__)
  #pragma language=default
#else
  #error Not supported compiler type
#endif

/*!
 * @}
 */ /* end of group Peripheral_access_layer */


#endif  /* I2C_H_ */
