spyadrian/digital-scale-pcb-firmware/firmware/device/periph5/PERI_SPI.h

/*
** ###################################################################
**     Processors:          LPC804M101JDH20
**                          LPC804M101JDH24
**                          LPC804M101JHI33
**                          LPC804M111JDH24
**                          LPC804UK
**
**     Version:             rev. 1.0, 2018-01-09
**     Build:               b240704
**
**     Abstract:
**         CMSIS Peripheral Access Layer for SPI
**
**     Copyright 1997-2016 Freescale Semiconductor, Inc.
**     Copyright 2016-2024 NXP
**     SPDX-License-Identifier: BSD-3-Clause
**
**     http:                 www.nxp.com
**     mail:                 support@nxp.com
**
**     Revisions:
**     - rev. 1.0 (2018-01-09)
**         Initial version.
**
** ###################################################################
*/

/*!
 * @file SPI.h
 * @version 1.0
 * @date 2018-01-09
 * @brief CMSIS Peripheral Access Layer for SPI
 *
 * CMSIS Peripheral Access Layer for SPI
 */

#if !defined(SPI_H_)
#define SPI_H_                                   /**< Symbol preventing repeated inclusion */

#if (defined(CPU_LPC804M101JDH20) || defined(CPU_LPC804M101JDH24) || defined(CPU_LPC804M101JHI33) || defined(CPU_LPC804M111JDH24) || defined(CPU_LPC804UK))
#include "LPC804_COMMON.h"
#else
  #error "No valid CPU defined!"
#endif

/* ----------------------------------------------------------------------------
   -- Device Peripheral Access Layer
   ---------------------------------------------------------------------------- */

/*!
 * @addtogroup Peripheral_access_layer Device Peripheral Access Layer
 * @{
 */


/*
** Start of section using anonymous unions
*/

#if defined(__ARMCC_VERSION)
  #if (__ARMCC_VERSION >= 6010050)
    #pragma clang diagnostic push
  #else
    #pragma push
    #pragma anon_unions
  #endif
#elif defined(__GNUC__)
  /* anonymous unions are enabled by default */
#elif defined(__IAR_SYSTEMS_ICC__)
  #pragma language=extended
#else
  #error Not supported compiler type
#endif

/* ----------------------------------------------------------------------------
   -- SPI Peripheral Access Layer
   ---------------------------------------------------------------------------- */

/*!
 * @addtogroup SPI_Peripheral_Access_Layer SPI Peripheral Access Layer
 * @{
 */

/** SPI - Register Layout Typedef */
typedef struct {
  __IO uint32_t CFG;                               /**< SPI Configuration register, offset: 0x0 */
  __IO uint32_t DLY;                               /**< SPI Delay register, offset: 0x4 */
  __IO uint32_t STAT;                              /**< SPI Status. Some status flags can be cleared by writing a 1 to that bit position, offset: 0x8 */
  __IO uint32_t INTENSET;                          /**< SPI Interrupt Enable read and Set. A complete value may be read from this register. Writing a 1 to any implemented bit position causes that bit to be set., offset: 0xC */
  __O  uint32_t INTENCLR;                          /**< SPI Interrupt Enable Clear. Writing a 1 to any implemented bit position causes the corresponding bit in INTENSET to be cleared., offset: 0x10 */
  __I  uint32_t RXDAT;                             /**< SPI Receive Data, offset: 0x14 */
  __IO uint32_t TXDATCTL;                          /**< SPI Transmit Data with Control, offset: 0x18 */
  __IO uint32_t TXDAT;                             /**< SPI Transmit Data., offset: 0x1C */
  __IO uint32_t TXCTL;                             /**< SPI Transmit Control, offset: 0x20 */
  __IO uint32_t DIV;                               /**< SPI clock Divider, offset: 0x24 */
  __I  uint32_t INTSTAT;                           /**< SPI Interrupt Status, offset: 0x28 */
} SPI_Type;

/* ----------------------------------------------------------------------------
   -- SPI Register Masks
   ---------------------------------------------------------------------------- */

/*!
 * @addtogroup SPI_Register_Masks SPI Register Masks
 * @{
 */

/*! @name CFG - SPI Configuration register */
/*! @{ */

#define SPI_CFG_ENABLE_MASK                      (0x1U)
#define SPI_CFG_ENABLE_SHIFT                     (0U)
/*! ENABLE - SPI enable.
 *  0b0..Disabled. The SPI is disabled and the internal state machine and counters are reset.
 *  0b1..Enabled. The SPI is enabled for operation.
 */
#define SPI_CFG_ENABLE(x)                        (((uint32_t)(((uint32_t)(x)) << SPI_CFG_ENABLE_SHIFT)) & SPI_CFG_ENABLE_MASK)

#define SPI_CFG_MASTER_MASK                      (0x4U)
#define SPI_CFG_MASTER_SHIFT                     (2U)
/*! MASTER - Master mode select.
 *  0b0..Slave mode. The SPI will operate in slave mode. SCK, MOSI, and the SSEL signals are inputs, MISO is an output.
 *  0b1..Master mode. The SPI will operate in master mode. SCK, MOSI, and the SSEL signals are outputs, MISO is an input.
 */
#define SPI_CFG_MASTER(x)                        (((uint32_t)(((uint32_t)(x)) << SPI_CFG_MASTER_SHIFT)) & SPI_CFG_MASTER_MASK)

#define SPI_CFG_LSBF_MASK                        (0x8U)
#define SPI_CFG_LSBF_SHIFT                       (3U)
/*! LSBF - LSB First mode enable.
 *  0b0..Standard. Data is transmitted and received in standard MSB first order.
 *  0b1..Reverse. Data is transmitted and received in reverse order (LSB first).
 */
#define SPI_CFG_LSBF(x)                          (((uint32_t)(((uint32_t)(x)) << SPI_CFG_LSBF_SHIFT)) & SPI_CFG_LSBF_MASK)

#define SPI_CFG_CPHA_MASK                        (0x10U)
#define SPI_CFG_CPHA_SHIFT                       (4U)
/*! CPHA - Clock Phase select.
 *  0b0..Change. The SPI captures serial data on the first clock transition of the transfer (when the clock
 *       changes away from the rest state). Data is changed on the following edge.
 *  0b1..Capture. The SPI changes serial data on the first clock transition of the transfer (when the clock
 *       changes away from the rest state). Data is captured on the following edge.
 */
#define SPI_CFG_CPHA(x)                          (((uint32_t)(((uint32_t)(x)) << SPI_CFG_CPHA_SHIFT)) & SPI_CFG_CPHA_MASK)

#define SPI_CFG_CPOL_MASK                        (0x20U)
#define SPI_CFG_CPOL_SHIFT                       (5U)
/*! CPOL - Clock Polarity select.
 *  0b0..Low. The rest state of the clock (between transfers) is low.
 *  0b1..High. The rest state of the clock (between transfers) is high.
 */
#define SPI_CFG_CPOL(x)                          (((uint32_t)(((uint32_t)(x)) << SPI_CFG_CPOL_SHIFT)) & SPI_CFG_CPOL_MASK)

#define SPI_CFG_LOOP_MASK                        (0x80U)
#define SPI_CFG_LOOP_SHIFT                       (7U)
/*! LOOP - Loopback mode enable. Loopback mode applies only to Master mode, and connects transmit
 *    and receive data connected together to allow simple software testing.
 *  0b0..Disabled.
 *  0b1..Enabled.
 */
#define SPI_CFG_LOOP(x)                          (((uint32_t)(((uint32_t)(x)) << SPI_CFG_LOOP_SHIFT)) & SPI_CFG_LOOP_MASK)

#define SPI_CFG_SPOL0_MASK                       (0x100U)
#define SPI_CFG_SPOL0_SHIFT                      (8U)
/*! SPOL0 - SSEL0 Polarity select.
 *  0b0..Low. The SSEL0 pin is active low.
 *  0b1..High. The SSEL0 pin is active high.
 */
#define SPI_CFG_SPOL0(x)                         (((uint32_t)(((uint32_t)(x)) << SPI_CFG_SPOL0_SHIFT)) & SPI_CFG_SPOL0_MASK)

#define SPI_CFG_SPOL1_MASK                       (0x200U)
#define SPI_CFG_SPOL1_SHIFT                      (9U)
/*! SPOL1 - SSEL1 Polarity select.
 *  0b0..Low. The SSEL1 pin is active low.
 *  0b1..High. The SSEL1 pin is active high.
 */
#define SPI_CFG_SPOL1(x)                         (((uint32_t)(((uint32_t)(x)) << SPI_CFG_SPOL1_SHIFT)) & SPI_CFG_SPOL1_MASK)
/*! @} */

/*! @name DLY - SPI Delay register */
/*! @{ */

#define SPI_DLY_PRE_DELAY_MASK                   (0xFU)
#define SPI_DLY_PRE_DELAY_SHIFT                  (0U)
/*! PRE_DELAY - Controls the amount of time between SSEL assertion and the beginning of a data
 *    transfer. There is always one SPI clock time between SSEL assertion and the first clock edge. This
 *    is not considered part of the pre-delay. 0x0 = No additional time is inserted. 0x1 = 1 SPI
 *    clock time is inserted. 0x2 = 2 SPI clock times are inserted. 0xF = 15 SPI clock times are
 *    inserted.
 */
#define SPI_DLY_PRE_DELAY(x)                     (((uint32_t)(((uint32_t)(x)) << SPI_DLY_PRE_DELAY_SHIFT)) & SPI_DLY_PRE_DELAY_MASK)

#define SPI_DLY_POST_DELAY_MASK                  (0xF0U)
#define SPI_DLY_POST_DELAY_SHIFT                 (4U)
/*! POST_DELAY - Controls the amount of time between the end of a data transfer and SSEL
 *    deassertion. 0x0 = No additional time is inserted. 0x1 = 1 SPI clock time is inserted. 0x2 = 2 SPI clock
 *    times are inserted. 0xF = 15 SPI clock times are inserted.
 */
#define SPI_DLY_POST_DELAY(x)                    (((uint32_t)(((uint32_t)(x)) << SPI_DLY_POST_DELAY_SHIFT)) & SPI_DLY_POST_DELAY_MASK)

#define SPI_DLY_FRAME_DELAY_MASK                 (0xF00U)
#define SPI_DLY_FRAME_DELAY_SHIFT                (8U)
/*! FRAME_DELAY - If the EOF flag is set, controls the minimum amount of time between the current
 *    frame and the next frame (or SSEL deassertion if EOT). 0x0 = No additional time is inserted. 0x1
 *    = 1 SPI clock time is inserted. 0x2 = 2 SPI clock times are inserted. 0xF = 15 SPI clock
 *    times are inserted.
 */
#define SPI_DLY_FRAME_DELAY(x)                   (((uint32_t)(((uint32_t)(x)) << SPI_DLY_FRAME_DELAY_SHIFT)) & SPI_DLY_FRAME_DELAY_MASK)

#define SPI_DLY_TRANSFER_DELAY_MASK              (0xF000U)
#define SPI_DLY_TRANSFER_DELAY_SHIFT             (12U)
/*! TRANSFER_DELAY - Controls the minimum amount of time that the SSEL is deasserted between
 *    transfers. 0x0 = The minimum time that SSEL is deasserted is 1 SPI clock time. (Zero added time.) 0x1
 *    = The minimum time that SSEL is deasserted is 2 SPI clock times. 0x2 = The minimum time that
 *    SSEL is deasserted is 3 SPI clock times. 0xF = The minimum time that SSEL is deasserted is 16
 *    SPI clock times.
 */
#define SPI_DLY_TRANSFER_DELAY(x)                (((uint32_t)(((uint32_t)(x)) << SPI_DLY_TRANSFER_DELAY_SHIFT)) & SPI_DLY_TRANSFER_DELAY_MASK)
/*! @} */

/*! @name STAT - SPI Status. Some status flags can be cleared by writing a 1 to that bit position */
/*! @{ */

#define SPI_STAT_RXRDY_MASK                      (0x1U)
#define SPI_STAT_RXRDY_SHIFT                     (0U)
/*! RXRDY - Receiver Ready flag. When 1, indicates that data is available to be read from the
 *    receiver buffer. Cleared after a read of the RXDAT register.
 */
#define SPI_STAT_RXRDY(x)                        (((uint32_t)(((uint32_t)(x)) << SPI_STAT_RXRDY_SHIFT)) & SPI_STAT_RXRDY_MASK)

#define SPI_STAT_TXRDY_MASK                      (0x2U)
#define SPI_STAT_TXRDY_SHIFT                     (1U)
/*! TXRDY - Transmitter Ready flag. When 1, this bit indicates that data may be written to the
 *    transmit buffer. Previous data may still be in the process of being transmitted. Cleared when data
 *    is written to TXDAT or TXDATCTL until the data is moved to the transmit shift register.
 */
#define SPI_STAT_TXRDY(x)                        (((uint32_t)(((uint32_t)(x)) << SPI_STAT_TXRDY_SHIFT)) & SPI_STAT_TXRDY_MASK)

#define SPI_STAT_RXOV_MASK                       (0x4U)
#define SPI_STAT_RXOV_SHIFT                      (2U)
/*! RXOV - Receiver Overrun interrupt flag. This flag applies only to slave mode (Master = 0). This
 *    flag is set when the beginning of a received character is detected while the receiver buffer
 *    is still in use. If this occurs, the receiver buffer contents are preserved, and the incoming
 *    data is lost. Data received by the SPI should be considered undefined if RxOv is set.
 */
#define SPI_STAT_RXOV(x)                         (((uint32_t)(((uint32_t)(x)) << SPI_STAT_RXOV_SHIFT)) & SPI_STAT_RXOV_MASK)

#define SPI_STAT_TXUR_MASK                       (0x8U)
#define SPI_STAT_TXUR_SHIFT                      (3U)
/*! TXUR - Transmitter Underrun interrupt flag. This flag applies only to slave mode (Master = 0).
 *    In this case, the transmitter must begin sending new data on the next input clock if the
 *    transmitter is idle. If that data is not available in the transmitter holding register at that
 *    point, there is no data to transmit and the TXUR flag is set. Data transmitted by the SPI should be
 *    considered undefined if TXUR is set.
 */
#define SPI_STAT_TXUR(x)                         (((uint32_t)(((uint32_t)(x)) << SPI_STAT_TXUR_SHIFT)) & SPI_STAT_TXUR_MASK)

#define SPI_STAT_SSA_MASK                        (0x10U)
#define SPI_STAT_SSA_SHIFT                       (4U)
/*! SSA - Slave Select Assert. This flag is set whenever any slave select transitions from
 *    deasserted to asserted, in both master and slave modes. This allows determining when the SPI
 *    transmit/receive functions become busy, and allows waking up the device from reduced power modes when a
 *    slave mode access begins. This flag is cleared by software.
 */
#define SPI_STAT_SSA(x)                          (((uint32_t)(((uint32_t)(x)) << SPI_STAT_SSA_SHIFT)) & SPI_STAT_SSA_MASK)

#define SPI_STAT_SSD_MASK                        (0x20U)
#define SPI_STAT_SSD_SHIFT                       (5U)
/*! SSD - Slave Select Deassert. This flag is set whenever any asserted slave selects transition to
 *    deasserted, in both master and slave modes. This allows determining when the SPI
 *    transmit/receive functions become idle. This flag is cleared by software.
 */
#define SPI_STAT_SSD(x)                          (((uint32_t)(((uint32_t)(x)) << SPI_STAT_SSD_SHIFT)) & SPI_STAT_SSD_MASK)

#define SPI_STAT_STALLED_MASK                    (0x40U)
#define SPI_STAT_STALLED_SHIFT                   (6U)
/*! STALLED - Stalled status flag. This indicates whether the SPI is currently in a stall condition. */
#define SPI_STAT_STALLED(x)                      (((uint32_t)(((uint32_t)(x)) << SPI_STAT_STALLED_SHIFT)) & SPI_STAT_STALLED_MASK)

#define SPI_STAT_ENDTRANSFER_MASK                (0x80U)
#define SPI_STAT_ENDTRANSFER_SHIFT               (7U)
/*! ENDTRANSFER - End Transfer control bit. Software can set this bit to force an end to the current
 *    transfer when the transmitter finishes any activity already in progress, as if the EOT flag
 *    had been set prior to the last transmission. This capability is included to support cases where
 *    it is not known when transmit data is written that it will be the end of a transfer. The bit
 *    is cleared when the transmitter becomes idle as the transfer comes to an end. Forcing an end
 *    of transfer in this manner causes any specified FRAME_DELAY and TRANSFER_DELAY to be inserted.
 */
#define SPI_STAT_ENDTRANSFER(x)                  (((uint32_t)(((uint32_t)(x)) << SPI_STAT_ENDTRANSFER_SHIFT)) & SPI_STAT_ENDTRANSFER_MASK)

#define SPI_STAT_MSTIDLE_MASK                    (0x100U)
#define SPI_STAT_MSTIDLE_SHIFT                   (8U)
/*! MSTIDLE - Master idle status flag. This bit is 1 whenever the SPI master function is fully idle.
 *    This means that the transmit holding register is empty and the transmitter is not in the
 *    process of sending data.
 */
#define SPI_STAT_MSTIDLE(x)                      (((uint32_t)(((uint32_t)(x)) << SPI_STAT_MSTIDLE_SHIFT)) & SPI_STAT_MSTIDLE_MASK)
/*! @} */

/*! @name INTENSET - SPI Interrupt Enable read and Set. A complete value may be read from this register. Writing a 1 to any implemented bit position causes that bit to be set. */
/*! @{ */

#define SPI_INTENSET_RXRDYEN_MASK                (0x1U)
#define SPI_INTENSET_RXRDYEN_SHIFT               (0U)
/*! RXRDYEN - Determines whether an interrupt occurs when receiver data is available.
 *  0b0..No interrupt will be generated when receiver data is available.
 *  0b1..An interrupt will be generated when receiver data is available in the RXDAT register.
 */
#define SPI_INTENSET_RXRDYEN(x)                  (((uint32_t)(((uint32_t)(x)) << SPI_INTENSET_RXRDYEN_SHIFT)) & SPI_INTENSET_RXRDYEN_MASK)

#define SPI_INTENSET_TXRDYEN_MASK                (0x2U)
#define SPI_INTENSET_TXRDYEN_SHIFT               (1U)
/*! TXRDYEN - Determines whether an interrupt occurs when the transmitter holding register is available.
 *  0b0..No interrupt will be generated when the transmitter holding register is available.
 *  0b1..An interrupt will be generated when data may be written to TXDAT.
 */
#define SPI_INTENSET_TXRDYEN(x)                  (((uint32_t)(((uint32_t)(x)) << SPI_INTENSET_TXRDYEN_SHIFT)) & SPI_INTENSET_TXRDYEN_MASK)

#define SPI_INTENSET_RXOVEN_MASK                 (0x4U)
#define SPI_INTENSET_RXOVEN_SHIFT                (2U)
/*! RXOVEN - Determines whether an interrupt occurs when a receiver overrun occurs. This happens in
 *    slave mode when there is a need for the receiver to move newly received data to the RXDAT
 *    register when it is already in use. The interface prevents receiver overrun in Master mode by not
 *    allowing a new transmission to begin when a receiver overrun would otherwise occur.
 *  0b0..No interrupt will be generated when a receiver overrun occurs.
 *  0b1..An interrupt will be generated if a receiver overrun occurs.
 */
#define SPI_INTENSET_RXOVEN(x)                   (((uint32_t)(((uint32_t)(x)) << SPI_INTENSET_RXOVEN_SHIFT)) & SPI_INTENSET_RXOVEN_MASK)

#define SPI_INTENSET_TXUREN_MASK                 (0x8U)
#define SPI_INTENSET_TXUREN_SHIFT                (3U)
/*! TXUREN - Determines whether an interrupt occurs when a transmitter underrun occurs. This happens
 *    in slave mode when there is a need to transmit data when none is available.
 *  0b0..No interrupt will be generated when the transmitter underruns.
 *  0b1..An interrupt will be generated if the transmitter underruns.
 */
#define SPI_INTENSET_TXUREN(x)                   (((uint32_t)(((uint32_t)(x)) << SPI_INTENSET_TXUREN_SHIFT)) & SPI_INTENSET_TXUREN_MASK)

#define SPI_INTENSET_SSAEN_MASK                  (0x10U)
#define SPI_INTENSET_SSAEN_SHIFT                 (4U)
/*! SSAEN - Determines whether an interrupt occurs when the Slave Select is asserted.
 *  0b0..No interrupt will be generated when any Slave Select transitions from deasserted to asserted.
 *  0b1..An interrupt will be generated when any Slave Select transitions from deasserted to asserted.
 */
#define SPI_INTENSET_SSAEN(x)                    (((uint32_t)(((uint32_t)(x)) << SPI_INTENSET_SSAEN_SHIFT)) & SPI_INTENSET_SSAEN_MASK)

#define SPI_INTENSET_SSDEN_MASK                  (0x20U)
#define SPI_INTENSET_SSDEN_SHIFT                 (5U)
/*! SSDEN - Determines whether an interrupt occurs when the Slave Select is deasserted.
 *  0b0..No interrupt will be generated when all asserted Slave Selects transition to deasserted.
 *  0b1..An interrupt will be generated when all asserted Slave Selects transition to deasserted.
 */
#define SPI_INTENSET_SSDEN(x)                    (((uint32_t)(((uint32_t)(x)) << SPI_INTENSET_SSDEN_SHIFT)) & SPI_INTENSET_SSDEN_MASK)

#define SPI_INTENSET_MSTIDLEEN_MASK              (0x100U)
#define SPI_INTENSET_MSTIDLEEN_SHIFT             (8U)
/*! MSTIDLEEN - Determines whether an interrupt occurs when the MSTIDLE enable
 *  0b0..No interrupt will be generated when MSTIDLE enabled.
 *  0b1..An interrupt will be generated when MSTIDLE enabled.
 */
#define SPI_INTENSET_MSTIDLEEN(x)                (((uint32_t)(((uint32_t)(x)) << SPI_INTENSET_MSTIDLEEN_SHIFT)) & SPI_INTENSET_MSTIDLEEN_MASK)
/*! @} */

/*! @name INTENCLR - SPI Interrupt Enable Clear. Writing a 1 to any implemented bit position causes the corresponding bit in INTENSET to be cleared. */
/*! @{ */

#define SPI_INTENCLR_RXRDYEN_MASK                (0x1U)
#define SPI_INTENCLR_RXRDYEN_SHIFT               (0U)
/*! RXRDYEN - Writing 1 clears the corresponding bits in the INTENSET register. */
#define SPI_INTENCLR_RXRDYEN(x)                  (((uint32_t)(((uint32_t)(x)) << SPI_INTENCLR_RXRDYEN_SHIFT)) & SPI_INTENCLR_RXRDYEN_MASK)

#define SPI_INTENCLR_TXRDYEN_MASK                (0x2U)
#define SPI_INTENCLR_TXRDYEN_SHIFT               (1U)
/*! TXRDYEN - Writing 1 clears the corresponding bits in the INTENSET register. */
#define SPI_INTENCLR_TXRDYEN(x)                  (((uint32_t)(((uint32_t)(x)) << SPI_INTENCLR_TXRDYEN_SHIFT)) & SPI_INTENCLR_TXRDYEN_MASK)

#define SPI_INTENCLR_RXOVEN_MASK                 (0x4U)
#define SPI_INTENCLR_RXOVEN_SHIFT                (2U)
/*! RXOVEN - Writing 1 clears the corresponding bits in the INTENSET register. */
#define SPI_INTENCLR_RXOVEN(x)                   (((uint32_t)(((uint32_t)(x)) << SPI_INTENCLR_RXOVEN_SHIFT)) & SPI_INTENCLR_RXOVEN_MASK)

#define SPI_INTENCLR_TXUREN_MASK                 (0x8U)
#define SPI_INTENCLR_TXUREN_SHIFT                (3U)
/*! TXUREN - Writing 1 clears the corresponding bits in the INTENSET register. */
#define SPI_INTENCLR_TXUREN(x)                   (((uint32_t)(((uint32_t)(x)) << SPI_INTENCLR_TXUREN_SHIFT)) & SPI_INTENCLR_TXUREN_MASK)

#define SPI_INTENCLR_SSAEN_MASK                  (0x10U)
#define SPI_INTENCLR_SSAEN_SHIFT                 (4U)
/*! SSAEN - Writing 1 clears the corresponding bits in the INTENSET register. */
#define SPI_INTENCLR_SSAEN(x)                    (((uint32_t)(((uint32_t)(x)) << SPI_INTENCLR_SSAEN_SHIFT)) & SPI_INTENCLR_SSAEN_MASK)

#define SPI_INTENCLR_SSDEN_MASK                  (0x20U)
#define SPI_INTENCLR_SSDEN_SHIFT                 (5U)
/*! SSDEN - Writing 1 clears the corresponding bits in the INTENSET register. */
#define SPI_INTENCLR_SSDEN(x)                    (((uint32_t)(((uint32_t)(x)) << SPI_INTENCLR_SSDEN_SHIFT)) & SPI_INTENCLR_SSDEN_MASK)

#define SPI_INTENCLR_MSTIDLE_MASK                (0x100U)
#define SPI_INTENCLR_MSTIDLE_SHIFT               (8U)
/*! MSTIDLE - Writing 1 clears the corresponding bits in the INTENSET register. */
#define SPI_INTENCLR_MSTIDLE(x)                  (((uint32_t)(((uint32_t)(x)) << SPI_INTENCLR_MSTIDLE_SHIFT)) & SPI_INTENCLR_MSTIDLE_MASK)
/*! @} */

/*! @name RXDAT - SPI Receive Data */
/*! @{ */

#define SPI_RXDAT_RXDAT_MASK                     (0xFFFFU)
#define SPI_RXDAT_RXDAT_SHIFT                    (0U)
/*! RXDAT - Receiver Data. This contains the next piece of received data. The number of bits that
 *    are used depends on the LEN setting in TXCTL / TXDATCTL.
 */
#define SPI_RXDAT_RXDAT(x)                       (((uint32_t)(((uint32_t)(x)) << SPI_RXDAT_RXDAT_SHIFT)) & SPI_RXDAT_RXDAT_MASK)

#define SPI_RXDAT_RXSSEL0_N_MASK                 (0x10000U)
#define SPI_RXDAT_RXSSEL0_N_SHIFT                (16U)
/*! RXSSEL0_N - Slave Select for receive. This field allows the state of the SSEL0 pin to be saved
 *    along with received data. The value will reflect the SSEL0 pin for both master and slave
 *    operation. A zero indicates that a slave select is active. The actual polarity of each slave select
 *    pin is configured by the related SPOL bit in CFG.
 */
#define SPI_RXDAT_RXSSEL0_N(x)                   (((uint32_t)(((uint32_t)(x)) << SPI_RXDAT_RXSSEL0_N_SHIFT)) & SPI_RXDAT_RXSSEL0_N_MASK)

#define SPI_RXDAT_RXSSEL1_N_MASK                 (0x20000U)
#define SPI_RXDAT_RXSSEL1_N_SHIFT                (17U)
/*! RXSSEL1_N - Slave Select for receive. This field allows the state of the SSEL1 pin to be saved
 *    along with received data. The value will reflect the SSEL1 pin for both master and slave
 *    operation. A zero indicates that a slave select is active. The actual polarity of each slave select
 *    pin is configured by the related SPOL bit in CFG.
 */
#define SPI_RXDAT_RXSSEL1_N(x)                   (((uint32_t)(((uint32_t)(x)) << SPI_RXDAT_RXSSEL1_N_SHIFT)) & SPI_RXDAT_RXSSEL1_N_MASK)

#define SPI_RXDAT_RXSSEL2_N_MASK                 (0x40000U)
#define SPI_RXDAT_RXSSEL2_N_SHIFT                (18U)
/*! RXSSEL2_N - Slave Select for receive. This field allows the state of the SSEL2 pin to be saved
 *    along with received data. The value will reflect the SSEL2 pin for both master and slave
 *    operation. A zero indicates that a slave select is active. The actual polarity of each slave select
 *    pin is configured by the related SPOL bit in CFG.
 */
#define SPI_RXDAT_RXSSEL2_N(x)                   (((uint32_t)(((uint32_t)(x)) << SPI_RXDAT_RXSSEL2_N_SHIFT)) & SPI_RXDAT_RXSSEL2_N_MASK)

#define SPI_RXDAT_RXSSEL3_N_MASK                 (0x80000U)
#define SPI_RXDAT_RXSSEL3_N_SHIFT                (19U)
/*! RXSSEL3_N - Slave Select for receive. This field allows the state of the SSEL3 pin to be saved
 *    along with received data. The value will reflect the SSEL3 pin for both master and slave
 *    operation. A zero indicates that a slave select is active. The actual polarity of each slave select
 *    pin is configured by the related SPOL bit in CFG.
 */
#define SPI_RXDAT_RXSSEL3_N(x)                   (((uint32_t)(((uint32_t)(x)) << SPI_RXDAT_RXSSEL3_N_SHIFT)) & SPI_RXDAT_RXSSEL3_N_MASK)

#define SPI_RXDAT_SOT_MASK                       (0x100000U)
#define SPI_RXDAT_SOT_SHIFT                      (20U)
/*! SOT - Start of Transfer flag. This flag will be 1 if this is the first data after the SSELs went
 *    from deasserted to asserted (i.e., any previous transfer has ended). This information can be
 *    used to identify the first piece of data in cases where the transfer length is greater than 16
 *    bit.
 */
#define SPI_RXDAT_SOT(x)                         (((uint32_t)(((uint32_t)(x)) << SPI_RXDAT_SOT_SHIFT)) & SPI_RXDAT_SOT_MASK)
/*! @} */

/*! @name TXDATCTL - SPI Transmit Data with Control */
/*! @{ */

#define SPI_TXDATCTL_TXDAT_MASK                  (0xFFFFU)
#define SPI_TXDATCTL_TXDAT_SHIFT                 (0U)
/*! TXDAT - Transmit Data. This field provides from 1 to 16 bits of data to be transmitted. */
#define SPI_TXDATCTL_TXDAT(x)                    (((uint32_t)(((uint32_t)(x)) << SPI_TXDATCTL_TXDAT_SHIFT)) & SPI_TXDATCTL_TXDAT_MASK)

#define SPI_TXDATCTL_TXSSEL0_N_MASK              (0x10000U)
#define SPI_TXDATCTL_TXSSEL0_N_SHIFT             (16U)
/*! TXSSEL0_N - Transmit Slave Select. This field asserts SSEL0 in master mode. The output on the
 *    pin is active LOW by default. Remark: The active state of the SSEL0 pin is configured by bits in
 *    the CFG register.
 *  0b0..SSEL0 asserted.
 *  0b1..SSEL0 not asserted.
 */
#define SPI_TXDATCTL_TXSSEL0_N(x)                (((uint32_t)(((uint32_t)(x)) << SPI_TXDATCTL_TXSSEL0_N_SHIFT)) & SPI_TXDATCTL_TXSSEL0_N_MASK)

#define SPI_TXDATCTL_TXSSEL1_N_MASK              (0x20000U)
#define SPI_TXDATCTL_TXSSEL1_N_SHIFT             (17U)
/*! TXSSEL1_N - Transmit Slave Select. This field asserts SSEL1 in master mode. The output on the
 *    pin is active LOW by default. Remark: The active state of the SSEL1 pin is configured by bits in
 *    the CFG register.
 *  0b0..SSEL1 asserted.
 *  0b1..SSEL1 not asserted.
 */
#define SPI_TXDATCTL_TXSSEL1_N(x)                (((uint32_t)(((uint32_t)(x)) << SPI_TXDATCTL_TXSSEL1_N_SHIFT)) & SPI_TXDATCTL_TXSSEL1_N_MASK)

#define SPI_TXDATCTL_EOT_MASK                    (0x100000U)
#define SPI_TXDATCTL_EOT_SHIFT                   (20U)
/*! EOT - End of Transfer. The asserted SSEL will be deasserted at the end of a transfer, and remain
 *    so for at least the time specified by the Transfer_delay value in the DLY register.
 *  0b0..This piece of data is not treated as the end of a transfer. SSEL will not be deasserted at the end of this data.
 *  0b1..This piece of data is treated as the end of a transfer. SSEL will be deasserted at the end of this piece of data.
 */
#define SPI_TXDATCTL_EOT(x)                      (((uint32_t)(((uint32_t)(x)) << SPI_TXDATCTL_EOT_SHIFT)) & SPI_TXDATCTL_EOT_MASK)

#define SPI_TXDATCTL_EOF_MASK                    (0x200000U)
#define SPI_TXDATCTL_EOF_SHIFT                   (21U)
/*! EOF - End of Frame. Between frames, a delay may be inserted, as defined by the FRAME_DELAY value
 *    in the DLY register. The end of a frame may not be particularly meaningful if the FRAME_DELAY
 *    value = 0. This control can be used as part of the support for frame lengths greater than 16
 *    bits.
 *  0b0..This piece of data transmitted is not treated as the end of a frame.
 *  0b1..This piece of data is treated as the end of a frame, causing the FRAME_DELAY time to be inserted before subsequent data is transmitted.
 */
#define SPI_TXDATCTL_EOF(x)                      (((uint32_t)(((uint32_t)(x)) << SPI_TXDATCTL_EOF_SHIFT)) & SPI_TXDATCTL_EOF_MASK)

#define SPI_TXDATCTL_RXIGNORE_MASK               (0x400000U)
#define SPI_TXDATCTL_RXIGNORE_SHIFT              (22U)
/*! RXIGNORE - Receive Ignore. This allows data to be transmitted using the SPI without the need to
 *    read unneeded data from the receiver.Setting this bit simplifies the transmit process and can
 *    be used with the DMA.
 *  0b0..Received data must be read in order to allow transmission to progress. In slave mode, an overrun error
 *       will occur if received data is not read before new data is received.
 *  0b1..Received data is ignored, allowing transmission without reading unneeded received data. No receiver flags are generated.
 */
#define SPI_TXDATCTL_RXIGNORE(x)                 (((uint32_t)(((uint32_t)(x)) << SPI_TXDATCTL_RXIGNORE_SHIFT)) & SPI_TXDATCTL_RXIGNORE_MASK)

#define SPI_TXDATCTL_LEN_MASK                    (0xF000000U)
#define SPI_TXDATCTL_LEN_SHIFT                   (24U)
/*! LEN - Data Length. Specifies the data length from 1 to 16 bits. Note that transfer lengths
 *    greater than 16 bits are supported by implementing multiple sequential transmits. 0x0 = Data
 *    transfer is 1 bit in length. 0x1 = Data transfer is 2 bits in length. 0x2 = Data transfer is 3 bits
 *    in length. ... 0xF = Data transfer is 16 bits in length.
 *  0b0000..
 *  0b0001..Data transfer is 1 bit in length.
 *  0b0010..Data transfer is 2 bit in length.
 *  0b0011..Data transfer is 3 bit in length.
 *  0b0100..Data transfer is 4 bit in length.
 *  0b0101..Data transfer is 5 bit in length.
 *  0b0110..Data transfer is 6 bit in length.
 *  0b0111..Data transfer is 7 bit in length.
 *  0b1000..Data transfer is 8 bit in length.
 *  0b1001..Data transfer is 9 bit in length.
 *  0b1010..Data transfer is 10 bit in length.
 *  0b1011..Data transfer is 11 bit in length.
 *  0b1100..Data transfer is 12 bit in length.
 *  0b1101..Data transfer is 13 bit in length.
 *  0b1110..Data transfer is 14 bit in length.
 *  0b1111..Data transfer is 15 bit in length.
 */
#define SPI_TXDATCTL_LEN(x)                      (((uint32_t)(((uint32_t)(x)) << SPI_TXDATCTL_LEN_SHIFT)) & SPI_TXDATCTL_LEN_MASK)
/*! @} */

/*! @name TXDAT - SPI Transmit Data. */
/*! @{ */

#define SPI_TXDAT_DATA_MASK                      (0xFFFFU)
#define SPI_TXDAT_DATA_SHIFT                     (0U)
/*! DATA - Transmit Data. This field provides from 4 to 16 bits of data to be transmitted. */
#define SPI_TXDAT_DATA(x)                        (((uint32_t)(((uint32_t)(x)) << SPI_TXDAT_DATA_SHIFT)) & SPI_TXDAT_DATA_MASK)
/*! @} */

/*! @name TXCTL - SPI Transmit Control */
/*! @{ */

#define SPI_TXCTL_TXSSEL0_N_MASK                 (0x10000U)
#define SPI_TXCTL_TXSSEL0_N_SHIFT                (16U)
/*! TXSSEL0_N - Transmit Slave Select 0. */
#define SPI_TXCTL_TXSSEL0_N(x)                   (((uint32_t)(((uint32_t)(x)) << SPI_TXCTL_TXSSEL0_N_SHIFT)) & SPI_TXCTL_TXSSEL0_N_MASK)

#define SPI_TXCTL_TXSSEL1_N_MASK                 (0x20000U)
#define SPI_TXCTL_TXSSEL1_N_SHIFT                (17U)
/*! TXSSEL1_N - Transmit Slave Select 1. */
#define SPI_TXCTL_TXSSEL1_N(x)                   (((uint32_t)(((uint32_t)(x)) << SPI_TXCTL_TXSSEL1_N_SHIFT)) & SPI_TXCTL_TXSSEL1_N_MASK)

#define SPI_TXCTL_EOT_MASK                       (0x100000U)
#define SPI_TXCTL_EOT_SHIFT                      (20U)
/*! EOT - End of Transfer. */
#define SPI_TXCTL_EOT(x)                         (((uint32_t)(((uint32_t)(x)) << SPI_TXCTL_EOT_SHIFT)) & SPI_TXCTL_EOT_MASK)

#define SPI_TXCTL_EOF_MASK                       (0x200000U)
#define SPI_TXCTL_EOF_SHIFT                      (21U)
/*! EOF - End of Frame. */
#define SPI_TXCTL_EOF(x)                         (((uint32_t)(((uint32_t)(x)) << SPI_TXCTL_EOF_SHIFT)) & SPI_TXCTL_EOF_MASK)

#define SPI_TXCTL_RXIGNORE_MASK                  (0x400000U)
#define SPI_TXCTL_RXIGNORE_SHIFT                 (22U)
/*! RXIGNORE - Receive Ignore. */
#define SPI_TXCTL_RXIGNORE(x)                    (((uint32_t)(((uint32_t)(x)) << SPI_TXCTL_RXIGNORE_SHIFT)) & SPI_TXCTL_RXIGNORE_MASK)

#define SPI_TXCTL_LEN_MASK                       (0xF000000U)
#define SPI_TXCTL_LEN_SHIFT                      (24U)
/*! LEN - Data transfer Length. */
#define SPI_TXCTL_LEN(x)                         (((uint32_t)(((uint32_t)(x)) << SPI_TXCTL_LEN_SHIFT)) & SPI_TXCTL_LEN_MASK)
/*! @} */

/*! @name DIV - SPI clock Divider */
/*! @{ */

#define SPI_DIV_DIVVAL_MASK                      (0xFFFFU)
#define SPI_DIV_DIVVAL_SHIFT                     (0U)
/*! DIVVAL - Rate divider value. Specifies how the Flexcomm clock (FCLK) is divided to produce the
 *    SPI clock rate in master mode. DIVVAL is -1 encoded such that the value 0 results in FCLK/1,
 *    the value 1 results in FCLK/2, up to the maximum possible divide value of 0xFFFF, which results
 *    in FCLK/65536.
 */
#define SPI_DIV_DIVVAL(x)                        (((uint32_t)(((uint32_t)(x)) << SPI_DIV_DIVVAL_SHIFT)) & SPI_DIV_DIVVAL_MASK)
/*! @} */

/*! @name INTSTAT - SPI Interrupt Status */
/*! @{ */

#define SPI_INTSTAT_RXRDY_MASK                   (0x1U)
#define SPI_INTSTAT_RXRDY_SHIFT                  (0U)
/*! RXRDY - Receiver Ready flag. */
#define SPI_INTSTAT_RXRDY(x)                     (((uint32_t)(((uint32_t)(x)) << SPI_INTSTAT_RXRDY_SHIFT)) & SPI_INTSTAT_RXRDY_MASK)

#define SPI_INTSTAT_TXRDY_MASK                   (0x2U)
#define SPI_INTSTAT_TXRDY_SHIFT                  (1U)
/*! TXRDY - Transmitter Ready flag. */
#define SPI_INTSTAT_TXRDY(x)                     (((uint32_t)(((uint32_t)(x)) << SPI_INTSTAT_TXRDY_SHIFT)) & SPI_INTSTAT_TXRDY_MASK)

#define SPI_INTSTAT_RXOV_MASK                    (0x4U)
#define SPI_INTSTAT_RXOV_SHIFT                   (2U)
/*! RXOV - Receiver Overrun interrupt flag. */
#define SPI_INTSTAT_RXOV(x)                      (((uint32_t)(((uint32_t)(x)) << SPI_INTSTAT_RXOV_SHIFT)) & SPI_INTSTAT_RXOV_MASK)

#define SPI_INTSTAT_TXUR_MASK                    (0x8U)
#define SPI_INTSTAT_TXUR_SHIFT                   (3U)
/*! TXUR - Transmitter Underrun interrupt flag. */
#define SPI_INTSTAT_TXUR(x)                      (((uint32_t)(((uint32_t)(x)) << SPI_INTSTAT_TXUR_SHIFT)) & SPI_INTSTAT_TXUR_MASK)

#define SPI_INTSTAT_SSA_MASK                     (0x10U)
#define SPI_INTSTAT_SSA_SHIFT                    (4U)
/*! SSA - Slave Select Assert. */
#define SPI_INTSTAT_SSA(x)                       (((uint32_t)(((uint32_t)(x)) << SPI_INTSTAT_SSA_SHIFT)) & SPI_INTSTAT_SSA_MASK)

#define SPI_INTSTAT_SSD_MASK                     (0x20U)
#define SPI_INTSTAT_SSD_SHIFT                    (5U)
/*! SSD - Slave Select Deassert. */
#define SPI_INTSTAT_SSD(x)                       (((uint32_t)(((uint32_t)(x)) << SPI_INTSTAT_SSD_SHIFT)) & SPI_INTSTAT_SSD_MASK)

#define SPI_INTSTAT_MSTIDLE_MASK                 (0x100U)
#define SPI_INTSTAT_MSTIDLE_SHIFT                (8U)
/*! MSTIDLE - Master Idle status flag. */
#define SPI_INTSTAT_MSTIDLE(x)                   (((uint32_t)(((uint32_t)(x)) << SPI_INTSTAT_MSTIDLE_SHIFT)) & SPI_INTSTAT_MSTIDLE_MASK)
/*! @} */


/*!
 * @}
 */ /* end of group SPI_Register_Masks */


/*!
 * @}
 */ /* end of group SPI_Peripheral_Access_Layer */


/*
** End of section using anonymous unions
*/

#if defined(__ARMCC_VERSION)
  #if (__ARMCC_VERSION >= 6010050)
    #pragma clang diagnostic pop
  #else
    #pragma pop
  #endif
#elif defined(__GNUC__)
  /* leave anonymous unions enabled */
#elif defined(__IAR_SYSTEMS_ICC__)
  #pragma language=default
#else
  #error Not supported compiler type
#endif

/*!
 * @}
 */ /* end of group Peripheral_access_layer */


#endif  /* SPI_H_ */
