spyadrian/digital-scale-pcb-firmware/firmware/device/periph5/PERI_MRT.h

/*
** ###################################################################
**     Processors:          LPC804M101JDH20
**                          LPC804M101JDH24
**                          LPC804M101JHI33
**                          LPC804M111JDH24
**                          LPC804UK
**
**     Version:             rev. 1.0, 2018-01-09
**     Build:               b240704
**
**     Abstract:
**         CMSIS Peripheral Access Layer for MRT
**
**     Copyright 1997-2016 Freescale Semiconductor, Inc.
**     Copyright 2016-2024 NXP
**     SPDX-License-Identifier: BSD-3-Clause
**
**     http:                 www.nxp.com
**     mail:                 support@nxp.com
**
**     Revisions:
**     - rev. 1.0 (2018-01-09)
**         Initial version.
**
** ###################################################################
*/

/*!
 * @file MRT.h
 * @version 1.0
 * @date 2018-01-09
 * @brief CMSIS Peripheral Access Layer for MRT
 *
 * CMSIS Peripheral Access Layer for MRT
 */

#if !defined(MRT_H_)
#define MRT_H_                                   /**< Symbol preventing repeated inclusion */

#if (defined(CPU_LPC804M101JDH20) || defined(CPU_LPC804M101JDH24) || defined(CPU_LPC804M101JHI33) || defined(CPU_LPC804M111JDH24) || defined(CPU_LPC804UK))
#include "LPC804_COMMON.h"
#else
  #error "No valid CPU defined!"
#endif

/* ----------------------------------------------------------------------------
   -- Device Peripheral Access Layer
   ---------------------------------------------------------------------------- */

/*!
 * @addtogroup Peripheral_access_layer Device Peripheral Access Layer
 * @{
 */


/*
** Start of section using anonymous unions
*/

#if defined(__ARMCC_VERSION)
  #if (__ARMCC_VERSION >= 6010050)
    #pragma clang diagnostic push
  #else
    #pragma push
    #pragma anon_unions
  #endif
#elif defined(__GNUC__)
  /* anonymous unions are enabled by default */
#elif defined(__IAR_SYSTEMS_ICC__)
  #pragma language=extended
#else
  #error Not supported compiler type
#endif

/* ----------------------------------------------------------------------------
   -- MRT Peripheral Access Layer
   ---------------------------------------------------------------------------- */

/*!
 * @addtogroup MRT_Peripheral_Access_Layer MRT Peripheral Access Layer
 * @{
 */

/** MRT - Size of Registers Arrays */
#define MRT_CHANNEL_COUNT                         4u

/** MRT - Register Layout Typedef */
typedef struct {
  struct {                                         /* offset: 0x0, array step: 0x10 */
    __IO uint32_t INTVAL;                            /**< MRT Time interval value register. This value is loaded into the TIMER register., array offset: 0x0, array step: 0x10 */
    __I  uint32_t TIMER;                             /**< MRT Timer register. This register reads the value of the down-counter., array offset: 0x4, array step: 0x10 */
    __IO uint32_t CTRL;                              /**< MRT Control register. This register controls the MRT modes., array offset: 0x8, array step: 0x10 */
    __IO uint32_t STAT;                              /**< MRT Status register., array offset: 0xC, array step: 0x10 */
  } CHANNEL[MRT_CHANNEL_COUNT];
       uint8_t RESERVED_0[176];
  __I  uint32_t MODCFG;                            /**< Module Configuration register. This register provides information about this particular MRT instance., offset: 0xF0 */
  __I  uint32_t IDLE_CH;                           /**< Idle channel register. This register returns the number of the first idle channel., offset: 0xF4 */
  __IO uint32_t IRQ_FLAG;                          /**< Global interrupt flag register, offset: 0xF8 */
} MRT_Type;

/* ----------------------------------------------------------------------------
   -- MRT Register Masks
   ---------------------------------------------------------------------------- */

/*!
 * @addtogroup MRT_Register_Masks MRT Register Masks
 * @{
 */

/*! @name CHANNEL_INTVAL - MRT Time interval value register. This value is loaded into the TIMER register. */
/*! @{ */

#define MRT_CHANNEL_INTVAL_IVALUE_MASK           (0x7FFFFFFFU)
#define MRT_CHANNEL_INTVAL_IVALUE_SHIFT          (0U)
/*! IVALUE - Time interval load value. This value is loaded into the TIMERn register and the MRT
 *    channel n starts counting down from IVALUE -1. If the timer is idle, writing a non-zero value to
 *    this bit field starts the timer immediately. If the timer is running, writing a zero to this
 *    bit field does the following: If LOAD = 1, the timer stops immediately. If LOAD = 0, the timer
 *    stops at the end of the time interval.
 */
#define MRT_CHANNEL_INTVAL_IVALUE(x)             (((uint32_t)(((uint32_t)(x)) << MRT_CHANNEL_INTVAL_IVALUE_SHIFT)) & MRT_CHANNEL_INTVAL_IVALUE_MASK)

#define MRT_CHANNEL_INTVAL_LOAD_MASK             (0x80000000U)
#define MRT_CHANNEL_INTVAL_LOAD_SHIFT            (31U)
/*! LOAD - Determines how the timer interval value IVALUE -1 is loaded into the TIMERn register.
 *    This bit is write-only. Reading this bit always returns 0.
 *  0b0..No force load. The load from the INTVALn register to the TIMERn register is processed at the end of the
 *       time interval if the repeat mode is selected.
 *  0b1..Force load. The INTVALn interval value IVALUE -1 is immediately loaded into the TIMERn register while TIMERn is running.
 */
#define MRT_CHANNEL_INTVAL_LOAD(x)               (((uint32_t)(((uint32_t)(x)) << MRT_CHANNEL_INTVAL_LOAD_SHIFT)) & MRT_CHANNEL_INTVAL_LOAD_MASK)
/*! @} */

/* The count of MRT_CHANNEL_INTVAL */
#define MRT_CHANNEL_INTVAL_COUNT                 (4U)

/*! @name CHANNEL_TIMER - MRT Timer register. This register reads the value of the down-counter. */
/*! @{ */

#define MRT_CHANNEL_TIMER_VALUE_MASK             (0x7FFFFFFFU)
#define MRT_CHANNEL_TIMER_VALUE_SHIFT            (0U)
/*! VALUE - Holds the current timer value of the down-counter. The initial value of the TIMERn
 *    register is loaded as IVALUE - 1 from the INTVALn register either at the end of the time interval
 *    or immediately in the following cases: INTVALn register is updated in the idle state. INTVALn
 *    register is updated with LOAD = 1. When the timer is in idle state, reading this bit fields
 *    returns -1 (0x00FF FFFF).
 */
#define MRT_CHANNEL_TIMER_VALUE(x)               (((uint32_t)(((uint32_t)(x)) << MRT_CHANNEL_TIMER_VALUE_SHIFT)) & MRT_CHANNEL_TIMER_VALUE_MASK)
/*! @} */

/* The count of MRT_CHANNEL_TIMER */
#define MRT_CHANNEL_TIMER_COUNT                  (4U)

/*! @name CHANNEL_CTRL - MRT Control register. This register controls the MRT modes. */
/*! @{ */

#define MRT_CHANNEL_CTRL_INTEN_MASK              (0x1U)
#define MRT_CHANNEL_CTRL_INTEN_SHIFT             (0U)
/*! INTEN - Enable the TIMERn interrupt.
 *  0b0..Disabled. TIMERn interrupt is disabled.
 *  0b1..Enabled. TIMERn interrupt is enabled.
 */
#define MRT_CHANNEL_CTRL_INTEN(x)                (((uint32_t)(((uint32_t)(x)) << MRT_CHANNEL_CTRL_INTEN_SHIFT)) & MRT_CHANNEL_CTRL_INTEN_MASK)

#define MRT_CHANNEL_CTRL_MODE_MASK               (0x6U)
#define MRT_CHANNEL_CTRL_MODE_SHIFT              (1U)
/*! MODE - Selects timer mode.
 *  0b00..Repeat interrupt mode.
 *  0b01..One-shot interrupt mode.
 *  0b10..One-shot stall mode.
 *  0b11..Reserved.
 */
#define MRT_CHANNEL_CTRL_MODE(x)                 (((uint32_t)(((uint32_t)(x)) << MRT_CHANNEL_CTRL_MODE_SHIFT)) & MRT_CHANNEL_CTRL_MODE_MASK)
/*! @} */

/* The count of MRT_CHANNEL_CTRL */
#define MRT_CHANNEL_CTRL_COUNT                   (4U)

/*! @name CHANNEL_STAT - MRT Status register. */
/*! @{ */

#define MRT_CHANNEL_STAT_INTFLAG_MASK            (0x1U)
#define MRT_CHANNEL_STAT_INTFLAG_SHIFT           (0U)
/*! INTFLAG - Monitors the interrupt flag.
 *  0b0..No pending interrupt. Writing a zero is equivalent to no operation.
 *  0b1..Pending interrupt. The interrupt is pending because TIMERn has reached the end of the time interval. If
 *       the INTEN bit in the CONTROLn is also set to 1, the interrupt for timer channel n and the global interrupt
 *       are raised. Writing a 1 to this bit clears the interrupt request.
 */
#define MRT_CHANNEL_STAT_INTFLAG(x)              (((uint32_t)(((uint32_t)(x)) << MRT_CHANNEL_STAT_INTFLAG_SHIFT)) & MRT_CHANNEL_STAT_INTFLAG_MASK)

#define MRT_CHANNEL_STAT_RUN_MASK                (0x2U)
#define MRT_CHANNEL_STAT_RUN_SHIFT               (1U)
/*! RUN - Indicates the state of TIMERn. This bit is read-only.
 *  0b0..Idle state. TIMERn is stopped.
 *  0b1..Running. TIMERn is running.
 */
#define MRT_CHANNEL_STAT_RUN(x)                  (((uint32_t)(((uint32_t)(x)) << MRT_CHANNEL_STAT_RUN_SHIFT)) & MRT_CHANNEL_STAT_RUN_MASK)
/*! @} */

/* The count of MRT_CHANNEL_STAT */
#define MRT_CHANNEL_STAT_COUNT                   (4U)

/*! @name MODCFG - Module Configuration register. This register provides information about this particular MRT instance. */
/*! @{ */

#define MRT_MODCFG_NOC_MASK                      (0xFU)
#define MRT_MODCFG_NOC_SHIFT                     (0U)
/*! NOC - Identifies the number of channels in this MRT.(4 channels on this device.) */
#define MRT_MODCFG_NOC(x)                        (((uint32_t)(((uint32_t)(x)) << MRT_MODCFG_NOC_SHIFT)) & MRT_MODCFG_NOC_MASK)

#define MRT_MODCFG_NOB_MASK                      (0x1F0U)
#define MRT_MODCFG_NOB_SHIFT                     (4U)
/*! NOB - Identifies the number of timer bits in this MRT. (31 bits wide on this device.) */
#define MRT_MODCFG_NOB(x)                        (((uint32_t)(((uint32_t)(x)) << MRT_MODCFG_NOB_SHIFT)) & MRT_MODCFG_NOB_MASK)
/*! @} */

/*! @name IDLE_CH - Idle channel register. This register returns the number of the first idle channel. */
/*! @{ */

#define MRT_IDLE_CH_CHAN_MASK                    (0xF0U)
#define MRT_IDLE_CH_CHAN_SHIFT                   (4U)
/*! CHAN - Idle channel. Reading the CHAN bits, returns the lowest idle timer channel. The number is
 *    positioned such that it can be used as an offset from the MRT base address in order to access
 *    the registers for the allocated channel. If all timer channels are running, CHAN = 0xF. See
 *    text above for more details.
 */
#define MRT_IDLE_CH_CHAN(x)                      (((uint32_t)(((uint32_t)(x)) << MRT_IDLE_CH_CHAN_SHIFT)) & MRT_IDLE_CH_CHAN_MASK)
/*! @} */

/*! @name IRQ_FLAG - Global interrupt flag register */
/*! @{ */

#define MRT_IRQ_FLAG_GFLAG0_MASK                 (0x1U)
#define MRT_IRQ_FLAG_GFLAG0_SHIFT                (0U)
/*! GFLAG0 - Monitors the interrupt flag of TIMER0.
 *  0b0..No pending interrupt. Writing a zero is equivalent to no operation.
 *  0b1..Pending interrupt. The interrupt is pending because TIMER0 has reached the end of the time interval. If
 *       the INTEN bit in the CONTROL0 register is also set to 1, the interrupt for timer channel 0 and the global
 *       interrupt are raised. Writing a 1 to this bit clears the interrupt request.
 */
#define MRT_IRQ_FLAG_GFLAG0(x)                   (((uint32_t)(((uint32_t)(x)) << MRT_IRQ_FLAG_GFLAG0_SHIFT)) & MRT_IRQ_FLAG_GFLAG0_MASK)

#define MRT_IRQ_FLAG_GFLAG1_MASK                 (0x2U)
#define MRT_IRQ_FLAG_GFLAG1_SHIFT                (1U)
/*! GFLAG1 - Monitors the interrupt flag of TIMER1. See description of channel 0. */
#define MRT_IRQ_FLAG_GFLAG1(x)                   (((uint32_t)(((uint32_t)(x)) << MRT_IRQ_FLAG_GFLAG1_SHIFT)) & MRT_IRQ_FLAG_GFLAG1_MASK)
/*! @} */


/*!
 * @}
 */ /* end of group MRT_Register_Masks */


/*!
 * @}
 */ /* end of group MRT_Peripheral_Access_Layer */


/*
** End of section using anonymous unions
*/

#if defined(__ARMCC_VERSION)
  #if (__ARMCC_VERSION >= 6010050)
    #pragma clang diagnostic pop
  #else
    #pragma pop
  #endif
#elif defined(__GNUC__)
  /* leave anonymous unions enabled */
#elif defined(__IAR_SYSTEMS_ICC__)
  #pragma language=default
#else
  #error Not supported compiler type
#endif

/*!
 * @}
 */ /* end of group Peripheral_access_layer */


#endif  /* MRT_H_ */
