spyadrian/digital-scale-pcb-firmware/firmware/device/periph5/PERI_CTIMER.h

/*
** ###################################################################
**     Processors:          LPC804M101JDH20
**                          LPC804M101JDH24
**                          LPC804M101JHI33
**                          LPC804M111JDH24
**                          LPC804UK
**
**     Version:             rev. 1.0, 2018-01-09
**     Build:               b240704
**
**     Abstract:
**         CMSIS Peripheral Access Layer for CTIMER
**
**     Copyright 1997-2016 Freescale Semiconductor, Inc.
**     Copyright 2016-2024 NXP
**     SPDX-License-Identifier: BSD-3-Clause
**
**     http:                 www.nxp.com
**     mail:                 support@nxp.com
**
**     Revisions:
**     - rev. 1.0 (2018-01-09)
**         Initial version.
**
** ###################################################################
*/

/*!
 * @file CTIMER.h
 * @version 1.0
 * @date 2018-01-09
 * @brief CMSIS Peripheral Access Layer for CTIMER
 *
 * CMSIS Peripheral Access Layer for CTIMER
 */

#if !defined(CTIMER_H_)
#define CTIMER_H_                                /**< Symbol preventing repeated inclusion */

#if (defined(CPU_LPC804M101JDH20) || defined(CPU_LPC804M101JDH24) || defined(CPU_LPC804M101JHI33) || defined(CPU_LPC804M111JDH24) || defined(CPU_LPC804UK))
#include "LPC804_COMMON.h"
#else
  #error "No valid CPU defined!"
#endif

/* ----------------------------------------------------------------------------
   -- Device Peripheral Access Layer
   ---------------------------------------------------------------------------- */

/*!
 * @addtogroup Peripheral_access_layer Device Peripheral Access Layer
 * @{
 */


/*
** Start of section using anonymous unions
*/

#if defined(__ARMCC_VERSION)
  #if (__ARMCC_VERSION >= 6010050)
    #pragma clang diagnostic push
  #else
    #pragma push
    #pragma anon_unions
  #endif
#elif defined(__GNUC__)
  /* anonymous unions are enabled by default */
#elif defined(__IAR_SYSTEMS_ICC__)
  #pragma language=extended
#else
  #error Not supported compiler type
#endif

/* ----------------------------------------------------------------------------
   -- CTIMER Peripheral Access Layer
   ---------------------------------------------------------------------------- */

/*!
 * @addtogroup CTIMER_Peripheral_Access_Layer CTIMER Peripheral Access Layer
 * @{
 */

/** CTIMER - Size of Registers Arrays */
#define CTIMER_MR_COUNT                           4u
#define CTIMER_CR_COUNT                           3u
#define CTIMER_MSR_COUNT                          4u

/** CTIMER - Register Layout Typedef */
typedef struct {
  __IO uint32_t IR;                                /**< Interrupt Register. The IR can be written to clear interrupts. The IR can be read to identify which of eight possible interrupt sources are pending., offset: 0x0 */
  __IO uint32_t TCR;                               /**< Timer Control Register. The TCR is used to control the Timer Counter functions. The Timer Counter can be disabled or reset through the TCR., offset: 0x4 */
  __IO uint32_t TC;                                /**< Timer Counter. The 32 bit TC is incremented every PR+1 cycles of the APB bus clock. The TC is controlled through the TCR., offset: 0x8 */
  __IO uint32_t PR;                                /**< Prescale Register. When the Prescale Counter (PC) is equal to this value, the next clock increments the TC and clears the PC., offset: 0xC */
  __IO uint32_t PC;                                /**< Prescale Counter. The 32 bit PC is a counter which is incremented to the value stored in PR. When the value in PR is reached, the TC is incremented and the PC is cleared. The PC is observable and controllable through the bus interface., offset: 0x10 */
  __IO uint32_t MCR;                               /**< Match Control Register. The MCR is used to control if an interrupt is generated and if the TC is reset when a Match occurs., offset: 0x14 */
  __IO uint32_t MR[CTIMER_MR_COUNT];               /**< Match Register . MR can be enabled through the MCR to reset the TC, stop both the TC and PC, and/or generate an interrupt every time MR matches the TC., array offset: 0x18, array step: 0x4 */
  __IO uint32_t CCR;                               /**< Capture Control Register. The CCR controls which edges of the capture inputs are used to load the Capture Registers and whether or not an interrupt is generated when a capture takes place., offset: 0x28 */
  __I  uint32_t CR[CTIMER_CR_COUNT];               /**< Capture Register . CR is loaded with the value of TC when there is an event on the CAPn. input., array offset: 0x2C, array step: 0x4 */
       uint8_t RESERVED_0[4];
  __IO uint32_t EMR;                               /**< External Match Register. The EMR controls the match function and the external match pins., offset: 0x3C */
       uint8_t RESERVED_1[48];
  __IO uint32_t CTCR;                              /**< Count Control Register. The CTCR selects between Timer and Counter mode, and in Counter mode selects the signal and edge(s) for counting., offset: 0x70 */
  __IO uint32_t PWMC;                              /**< PWM Control Register. The PWMCON enables PWM mode for the external match pins., offset: 0x74 */
  __IO uint32_t MSR[CTIMER_MSR_COUNT];             /**< Match Shadow Register . If enabled, the Match Register will be automatically reloaded with the contents of this register whenever the TC is reset to zero., array offset: 0x78, array step: 0x4 */
} CTIMER_Type;

/* ----------------------------------------------------------------------------
   -- CTIMER Register Masks
   ---------------------------------------------------------------------------- */

/*!
 * @addtogroup CTIMER_Register_Masks CTIMER Register Masks
 * @{
 */

/*! @name IR - Interrupt Register. The IR can be written to clear interrupts. The IR can be read to identify which of eight possible interrupt sources are pending. */
/*! @{ */

#define CTIMER_IR_MR0INT_MASK                    (0x1U)
#define CTIMER_IR_MR0INT_SHIFT                   (0U)
/*! MR0INT - Interrupt flag for match channel 0. */
#define CTIMER_IR_MR0INT(x)                      (((uint32_t)(((uint32_t)(x)) << CTIMER_IR_MR0INT_SHIFT)) & CTIMER_IR_MR0INT_MASK)

#define CTIMER_IR_MR1INT_MASK                    (0x2U)
#define CTIMER_IR_MR1INT_SHIFT                   (1U)
/*! MR1INT - Interrupt flag for match channel 1. */
#define CTIMER_IR_MR1INT(x)                      (((uint32_t)(((uint32_t)(x)) << CTIMER_IR_MR1INT_SHIFT)) & CTIMER_IR_MR1INT_MASK)

#define CTIMER_IR_MR2INT_MASK                    (0x4U)
#define CTIMER_IR_MR2INT_SHIFT                   (2U)
/*! MR2INT - Interrupt flag for match channel 2. */
#define CTIMER_IR_MR2INT(x)                      (((uint32_t)(((uint32_t)(x)) << CTIMER_IR_MR2INT_SHIFT)) & CTIMER_IR_MR2INT_MASK)

#define CTIMER_IR_MR3INT_MASK                    (0x8U)
#define CTIMER_IR_MR3INT_SHIFT                   (3U)
/*! MR3INT - Interrupt flag for match channel 3. */
#define CTIMER_IR_MR3INT(x)                      (((uint32_t)(((uint32_t)(x)) << CTIMER_IR_MR3INT_SHIFT)) & CTIMER_IR_MR3INT_MASK)

#define CTIMER_IR_CR0INT_MASK                    (0x10U)
#define CTIMER_IR_CR0INT_SHIFT                   (4U)
/*! CR0INT - Interrupt flag for capture channel 0 event. */
#define CTIMER_IR_CR0INT(x)                      (((uint32_t)(((uint32_t)(x)) << CTIMER_IR_CR0INT_SHIFT)) & CTIMER_IR_CR0INT_MASK)

#define CTIMER_IR_CR1INT_MASK                    (0x20U)
#define CTIMER_IR_CR1INT_SHIFT                   (5U)
/*! CR1INT - Interrupt flag for capture channel 1 event. */
#define CTIMER_IR_CR1INT(x)                      (((uint32_t)(((uint32_t)(x)) << CTIMER_IR_CR1INT_SHIFT)) & CTIMER_IR_CR1INT_MASK)

#define CTIMER_IR_CR2INT_MASK                    (0x40U)
#define CTIMER_IR_CR2INT_SHIFT                   (6U)
/*! CR2INT - Interrupt flag for capture channel 2 event. */
#define CTIMER_IR_CR2INT(x)                      (((uint32_t)(((uint32_t)(x)) << CTIMER_IR_CR2INT_SHIFT)) & CTIMER_IR_CR2INT_MASK)
/*! @} */

/*! @name TCR - Timer Control Register. The TCR is used to control the Timer Counter functions. The Timer Counter can be disabled or reset through the TCR. */
/*! @{ */

#define CTIMER_TCR_CEN_MASK                      (0x1U)
#define CTIMER_TCR_CEN_SHIFT                     (0U)
/*! CEN - Counter enable.
 *  0b0..Disabled.The counters are disabled.
 *  0b1..Enabled. The Timer Counter and Prescale Counter are enabled.
 */
#define CTIMER_TCR_CEN(x)                        (((uint32_t)(((uint32_t)(x)) << CTIMER_TCR_CEN_SHIFT)) & CTIMER_TCR_CEN_MASK)

#define CTIMER_TCR_CRST_MASK                     (0x2U)
#define CTIMER_TCR_CRST_SHIFT                    (1U)
/*! CRST - Counter reset.
 *  0b0..Disabled. Do nothing.
 *  0b1..Enabled. The Timer Counter and the Prescale Counter are synchronously reset on the next positive edge of
 *       the APB bus clock. The counters remain reset until TCR[1] is returned to zero.
 */
#define CTIMER_TCR_CRST(x)                       (((uint32_t)(((uint32_t)(x)) << CTIMER_TCR_CRST_SHIFT)) & CTIMER_TCR_CRST_MASK)
/*! @} */

/*! @name TC - Timer Counter. The 32 bit TC is incremented every PR+1 cycles of the APB bus clock. The TC is controlled through the TCR. */
/*! @{ */

#define CTIMER_TC_TCVAL_MASK                     (0xFFFFFFFFU)
#define CTIMER_TC_TCVAL_SHIFT                    (0U)
/*! TCVAL - Timer counter value. */
#define CTIMER_TC_TCVAL(x)                       (((uint32_t)(((uint32_t)(x)) << CTIMER_TC_TCVAL_SHIFT)) & CTIMER_TC_TCVAL_MASK)
/*! @} */

/*! @name PR - Prescale Register. When the Prescale Counter (PC) is equal to this value, the next clock increments the TC and clears the PC. */
/*! @{ */

#define CTIMER_PR_PRVAL_MASK                     (0xFFFFFFFFU)
#define CTIMER_PR_PRVAL_SHIFT                    (0U)
/*! PRVAL - Prescale counter value. */
#define CTIMER_PR_PRVAL(x)                       (((uint32_t)(((uint32_t)(x)) << CTIMER_PR_PRVAL_SHIFT)) & CTIMER_PR_PRVAL_MASK)
/*! @} */

/*! @name PC - Prescale Counter. The 32 bit PC is a counter which is incremented to the value stored in PR. When the value in PR is reached, the TC is incremented and the PC is cleared. The PC is observable and controllable through the bus interface. */
/*! @{ */

#define CTIMER_PC_PCVAL_MASK                     (0xFFFFFFFFU)
#define CTIMER_PC_PCVAL_SHIFT                    (0U)
/*! PCVAL - Prescale counter value. */
#define CTIMER_PC_PCVAL(x)                       (((uint32_t)(((uint32_t)(x)) << CTIMER_PC_PCVAL_SHIFT)) & CTIMER_PC_PCVAL_MASK)
/*! @} */

/*! @name MCR - Match Control Register. The MCR is used to control if an interrupt is generated and if the TC is reset when a Match occurs. */
/*! @{ */

#define CTIMER_MCR_MR0I_MASK                     (0x1U)
#define CTIMER_MCR_MR0I_SHIFT                    (0U)
/*! MR0I - Interrupt on MR0: an interrupt is generated when MR0 matches the value in the TC. 0 = disabled. 1 = enabled. */
#define CTIMER_MCR_MR0I(x)                       (((uint32_t)(((uint32_t)(x)) << CTIMER_MCR_MR0I_SHIFT)) & CTIMER_MCR_MR0I_MASK)

#define CTIMER_MCR_MR0R_MASK                     (0x2U)
#define CTIMER_MCR_MR0R_SHIFT                    (1U)
/*! MR0R - Reset on MR0: the TC will be reset if MR0 matches it. 0 = disabled. 1 = enabled. */
#define CTIMER_MCR_MR0R(x)                       (((uint32_t)(((uint32_t)(x)) << CTIMER_MCR_MR0R_SHIFT)) & CTIMER_MCR_MR0R_MASK)

#define CTIMER_MCR_MR0S_MASK                     (0x4U)
#define CTIMER_MCR_MR0S_SHIFT                    (2U)
/*! MR0S - Stop on MR0: the TC and PC will be stopped and TCR[0] will be set to 0 if MR0 matches the TC. 0 = disabled. 1 = enabled. */
#define CTIMER_MCR_MR0S(x)                       (((uint32_t)(((uint32_t)(x)) << CTIMER_MCR_MR0S_SHIFT)) & CTIMER_MCR_MR0S_MASK)

#define CTIMER_MCR_MR1I_MASK                     (0x8U)
#define CTIMER_MCR_MR1I_SHIFT                    (3U)
/*! MR1I - Interrupt on MR1: an interrupt is generated when MR1 matches the value in the TC. 0 =
 *    disabled. 1 = enabled. 0 = disabled. 1 = enabled.
 */
#define CTIMER_MCR_MR1I(x)                       (((uint32_t)(((uint32_t)(x)) << CTIMER_MCR_MR1I_SHIFT)) & CTIMER_MCR_MR1I_MASK)

#define CTIMER_MCR_MR1R_MASK                     (0x10U)
#define CTIMER_MCR_MR1R_SHIFT                    (4U)
/*! MR1R - Reset on MR1: the TC will be reset if MR1 matches it. 0 = disabled. 1 = enabled. */
#define CTIMER_MCR_MR1R(x)                       (((uint32_t)(((uint32_t)(x)) << CTIMER_MCR_MR1R_SHIFT)) & CTIMER_MCR_MR1R_MASK)

#define CTIMER_MCR_MR1S_MASK                     (0x20U)
#define CTIMER_MCR_MR1S_SHIFT                    (5U)
/*! MR1S - Stop on MR1: the TC and PC will be stopped and TCR[0] will be set to 0 if MR1 matches the TC. 0 = disabled. 1 = enabled. */
#define CTIMER_MCR_MR1S(x)                       (((uint32_t)(((uint32_t)(x)) << CTIMER_MCR_MR1S_SHIFT)) & CTIMER_MCR_MR1S_MASK)

#define CTIMER_MCR_MR2I_MASK                     (0x40U)
#define CTIMER_MCR_MR2I_SHIFT                    (6U)
/*! MR2I - Interrupt on MR2: an interrupt is generated when MR2 matches the value in the TC. 0 = disabled. 1 = enabled. */
#define CTIMER_MCR_MR2I(x)                       (((uint32_t)(((uint32_t)(x)) << CTIMER_MCR_MR2I_SHIFT)) & CTIMER_MCR_MR2I_MASK)

#define CTIMER_MCR_MR2R_MASK                     (0x80U)
#define CTIMER_MCR_MR2R_SHIFT                    (7U)
/*! MR2R - Reset on MR2: the TC will be reset if MR2 matches it. 0 = disabled. 1 = enabled. */
#define CTIMER_MCR_MR2R(x)                       (((uint32_t)(((uint32_t)(x)) << CTIMER_MCR_MR2R_SHIFT)) & CTIMER_MCR_MR2R_MASK)

#define CTIMER_MCR_MR2S_MASK                     (0x100U)
#define CTIMER_MCR_MR2S_SHIFT                    (8U)
/*! MR2S - Stop on MR2: the TC and PC will be stopped and TCR[0] will be set to 0 if MR2 matches the TC. 0 = disabled. 1 = enabled. */
#define CTIMER_MCR_MR2S(x)                       (((uint32_t)(((uint32_t)(x)) << CTIMER_MCR_MR2S_SHIFT)) & CTIMER_MCR_MR2S_MASK)

#define CTIMER_MCR_MR3I_MASK                     (0x200U)
#define CTIMER_MCR_MR3I_SHIFT                    (9U)
/*! MR3I - Interrupt on MR3: an interrupt is generated when MR3 matches the value in the TC. 0 = disabled. 1 = enabled. */
#define CTIMER_MCR_MR3I(x)                       (((uint32_t)(((uint32_t)(x)) << CTIMER_MCR_MR3I_SHIFT)) & CTIMER_MCR_MR3I_MASK)

#define CTIMER_MCR_MR3R_MASK                     (0x400U)
#define CTIMER_MCR_MR3R_SHIFT                    (10U)
/*! MR3R - Reset on MR3: the TC will be reset if MR3 matches it. 0 = disabled. 1 = enabled. */
#define CTIMER_MCR_MR3R(x)                       (((uint32_t)(((uint32_t)(x)) << CTIMER_MCR_MR3R_SHIFT)) & CTIMER_MCR_MR3R_MASK)

#define CTIMER_MCR_MR3S_MASK                     (0x800U)
#define CTIMER_MCR_MR3S_SHIFT                    (11U)
/*! MR3S - Stop on MR3: the TC and PC will be stopped and TCR[0] will be set to 0 if MR3 matches the TC. 0 = disabled. 1 = enabled. */
#define CTIMER_MCR_MR3S(x)                       (((uint32_t)(((uint32_t)(x)) << CTIMER_MCR_MR3S_SHIFT)) & CTIMER_MCR_MR3S_MASK)

#define CTIMER_MCR_MR0RL_MASK                    (0x1000000U)
#define CTIMER_MCR_MR0RL_SHIFT                   (24U)
/*! MR0RL - Reload MR0 with the contents of the Match 0 Shadow Register when the TC is reset to zero
 *    (either via a match event or a write to bit 1 of the TCR). 0 = disabled. 1 = enabled.
 */
#define CTIMER_MCR_MR0RL(x)                      (((uint32_t)(((uint32_t)(x)) << CTIMER_MCR_MR0RL_SHIFT)) & CTIMER_MCR_MR0RL_MASK)

#define CTIMER_MCR_MR1RL_MASK                    (0x2000000U)
#define CTIMER_MCR_MR1RL_SHIFT                   (25U)
/*! MR1RL - Reload MR1 with the contents of the Match 1 Shadow Register when the TC is reset to zero
 *    (either via a match event or a write to bit 1 of the TCR). 0 = disabled. 1 = enabled.
 */
#define CTIMER_MCR_MR1RL(x)                      (((uint32_t)(((uint32_t)(x)) << CTIMER_MCR_MR1RL_SHIFT)) & CTIMER_MCR_MR1RL_MASK)

#define CTIMER_MCR_MR2RL_MASK                    (0x4000000U)
#define CTIMER_MCR_MR2RL_SHIFT                   (26U)
/*! MR2RL - Reload MR2 with the contents of the Match 2 Shadow Register when the TC is reset to zero
 *    (either via a match event or a write to bit 1 of the TCR). 0 = disabled. 1 = enabled.
 */
#define CTIMER_MCR_MR2RL(x)                      (((uint32_t)(((uint32_t)(x)) << CTIMER_MCR_MR2RL_SHIFT)) & CTIMER_MCR_MR2RL_MASK)

#define CTIMER_MCR_MR3RL_MASK                    (0x8000000U)
#define CTIMER_MCR_MR3RL_SHIFT                   (27U)
/*! MR3RL - Reload MR3 with the contents of the Match 3 Shadow Register when the TC is reset to zero
 *    (either via a match event or a write to bit 1 of the TCR). 0 = disabled. 1 = enabled.
 */
#define CTIMER_MCR_MR3RL(x)                      (((uint32_t)(((uint32_t)(x)) << CTIMER_MCR_MR3RL_SHIFT)) & CTIMER_MCR_MR3RL_MASK)
/*! @} */

/*! @name MR - Match Register . MR can be enabled through the MCR to reset the TC, stop both the TC and PC, and/or generate an interrupt every time MR matches the TC. */
/*! @{ */

#define CTIMER_MR_MATCH_MASK                     (0xFFFFFFFFU)
#define CTIMER_MR_MATCH_SHIFT                    (0U)
/*! MATCH - Timer counter match value. */
#define CTIMER_MR_MATCH(x)                       (((uint32_t)(((uint32_t)(x)) << CTIMER_MR_MATCH_SHIFT)) & CTIMER_MR_MATCH_MASK)
/*! @} */

/*! @name CCR - Capture Control Register. The CCR controls which edges of the capture inputs are used to load the Capture Registers and whether or not an interrupt is generated when a capture takes place. */
/*! @{ */

#define CTIMER_CCR_CAP0RE_MASK                   (0x1U)
#define CTIMER_CCR_CAP0RE_SHIFT                  (0U)
/*! CAP0RE - Rising edge of capture channel 0: a sequence of 0 then 1 causes CR0 to be loaded with
 *    the contents of TC. 0 = disabled. 1 = enabled.
 */
#define CTIMER_CCR_CAP0RE(x)                     (((uint32_t)(((uint32_t)(x)) << CTIMER_CCR_CAP0RE_SHIFT)) & CTIMER_CCR_CAP0RE_MASK)

#define CTIMER_CCR_CAP0FE_MASK                   (0x2U)
#define CTIMER_CCR_CAP0FE_SHIFT                  (1U)
/*! CAP0FE - Falling edge of capture channel 0: a sequence of 1 then 0 causes CR0 to be loaded with
 *    the contents of TC. 0 = disabled. 1 = enabled.
 */
#define CTIMER_CCR_CAP0FE(x)                     (((uint32_t)(((uint32_t)(x)) << CTIMER_CCR_CAP0FE_SHIFT)) & CTIMER_CCR_CAP0FE_MASK)

#define CTIMER_CCR_CAP0I_MASK                    (0x4U)
#define CTIMER_CCR_CAP0I_SHIFT                   (2U)
/*! CAP0I - Generate interrupt on channel 0 capture event: a CR0 load generates an interrupt. */
#define CTIMER_CCR_CAP0I(x)                      (((uint32_t)(((uint32_t)(x)) << CTIMER_CCR_CAP0I_SHIFT)) & CTIMER_CCR_CAP0I_MASK)

#define CTIMER_CCR_CAP1RE_MASK                   (0x8U)
#define CTIMER_CCR_CAP1RE_SHIFT                  (3U)
/*! CAP1RE - Rising edge of capture channel 1: a sequence of 0 then 1 causes CR1 to be loaded with
 *    the contents of TC. 0 = disabled. 1 = enabled.
 */
#define CTIMER_CCR_CAP1RE(x)                     (((uint32_t)(((uint32_t)(x)) << CTIMER_CCR_CAP1RE_SHIFT)) & CTIMER_CCR_CAP1RE_MASK)

#define CTIMER_CCR_CAP1FE_MASK                   (0x10U)
#define CTIMER_CCR_CAP1FE_SHIFT                  (4U)
/*! CAP1FE - Falling edge of capture channel 1: a sequence of 1 then 0 causes CR1 to be loaded with
 *    the contents of TC. 0 = disabled. 1 = enabled.
 */
#define CTIMER_CCR_CAP1FE(x)                     (((uint32_t)(((uint32_t)(x)) << CTIMER_CCR_CAP1FE_SHIFT)) & CTIMER_CCR_CAP1FE_MASK)

#define CTIMER_CCR_CAP1I_MASK                    (0x20U)
#define CTIMER_CCR_CAP1I_SHIFT                   (5U)
/*! CAP1I - Generate interrupt on channel 1 capture event: a CR1 load generates an interrupt. */
#define CTIMER_CCR_CAP1I(x)                      (((uint32_t)(((uint32_t)(x)) << CTIMER_CCR_CAP1I_SHIFT)) & CTIMER_CCR_CAP1I_MASK)

#define CTIMER_CCR_CAP2RE_MASK                   (0x40U)
#define CTIMER_CCR_CAP2RE_SHIFT                  (6U)
/*! CAP2RE - Rising edge of capture channel 2: a sequence of 0 then 1 causes CR2 to be loaded with
 *    the contents of TC. 0 = disabled. 1 = enabled.
 */
#define CTIMER_CCR_CAP2RE(x)                     (((uint32_t)(((uint32_t)(x)) << CTIMER_CCR_CAP2RE_SHIFT)) & CTIMER_CCR_CAP2RE_MASK)

#define CTIMER_CCR_CAP2FE_MASK                   (0x80U)
#define CTIMER_CCR_CAP2FE_SHIFT                  (7U)
/*! CAP2FE - Falling edge of capture channel 2: a sequence of 1 then 0 causes CR2 to be loaded with
 *    the contents of TC. 0 = disabled. 1 = enabled.
 */
#define CTIMER_CCR_CAP2FE(x)                     (((uint32_t)(((uint32_t)(x)) << CTIMER_CCR_CAP2FE_SHIFT)) & CTIMER_CCR_CAP2FE_MASK)

#define CTIMER_CCR_CAP2I_MASK                    (0x100U)
#define CTIMER_CCR_CAP2I_SHIFT                   (8U)
/*! CAP2I - Generate interrupt on channel 2 capture event: a CR2 load generates an interrupt. */
#define CTIMER_CCR_CAP2I(x)                      (((uint32_t)(((uint32_t)(x)) << CTIMER_CCR_CAP2I_SHIFT)) & CTIMER_CCR_CAP2I_MASK)
/*! @} */

/*! @name CR - Capture Register . CR is loaded with the value of TC when there is an event on the CAPn. input. */
/*! @{ */

#define CTIMER_CR_CAP_MASK                       (0xFFFFFFFFU)
#define CTIMER_CR_CAP_SHIFT                      (0U)
/*! CAP - Timer counter capture value. */
#define CTIMER_CR_CAP(x)                         (((uint32_t)(((uint32_t)(x)) << CTIMER_CR_CAP_SHIFT)) & CTIMER_CR_CAP_MASK)
/*! @} */

/*! @name EMR - External Match Register. The EMR controls the match function and the external match pins. */
/*! @{ */

#define CTIMER_EMR_EM0_MASK                      (0x1U)
#define CTIMER_EMR_EM0_SHIFT                     (0U)
/*! EM0 - External Match 0. This bit reflects the state of output MAT0, whether or not this output
 *    is connected to a pin. When a match occurs between the TC and MR0, this bit can either toggle,
 *    go LOW, go HIGH, or do nothing, as selected by EMR[5:4]. This bit is driven to the MAT pins if
 *    the match function is selected via IOCON. 0 = LOW. 1 = HIGH.
 */
#define CTIMER_EMR_EM0(x)                        (((uint32_t)(((uint32_t)(x)) << CTIMER_EMR_EM0_SHIFT)) & CTIMER_EMR_EM0_MASK)

#define CTIMER_EMR_EM1_MASK                      (0x2U)
#define CTIMER_EMR_EM1_SHIFT                     (1U)
/*! EM1 - External Match 1. This bit reflects the state of output MAT1, whether or not this output
 *    is connected to a pin. When a match occurs between the TC and MR1, this bit can either toggle,
 *    go LOW, go HIGH, or do nothing, as selected by EMR[7:6]. This bit is driven to the MAT pins if
 *    the match function is selected via IOCON. 0 = LOW. 1 = HIGH.
 */
#define CTIMER_EMR_EM1(x)                        (((uint32_t)(((uint32_t)(x)) << CTIMER_EMR_EM1_SHIFT)) & CTIMER_EMR_EM1_MASK)

#define CTIMER_EMR_EM2_MASK                      (0x4U)
#define CTIMER_EMR_EM2_SHIFT                     (2U)
/*! EM2 - External Match 2. This bit reflects the state of output MAT2, whether or not this output
 *    is connected to a pin. When a match occurs between the TC and MR2, this bit can either toggle,
 *    go LOW, go HIGH, or do nothing, as selected by EMR[9:8]. This bit is driven to the MAT pins if
 *    the match function is selected via IOCON. 0 = LOW. 1 = HIGH.
 */
#define CTIMER_EMR_EM2(x)                        (((uint32_t)(((uint32_t)(x)) << CTIMER_EMR_EM2_SHIFT)) & CTIMER_EMR_EM2_MASK)

#define CTIMER_EMR_EM3_MASK                      (0x8U)
#define CTIMER_EMR_EM3_SHIFT                     (3U)
/*! EM3 - External Match 3. This bit reflects the state of output MAT3, whether or not this output
 *    is connected to a pin. When a match occurs between the TC and MR3, this bit can either toggle,
 *    go LOW, go HIGH, or do nothing, as selected by MR[11:10]. This bit is driven to the MAT pins
 *    if the match function is selected via IOCON. 0 = LOW. 1 = HIGH.
 */
#define CTIMER_EMR_EM3(x)                        (((uint32_t)(((uint32_t)(x)) << CTIMER_EMR_EM3_SHIFT)) & CTIMER_EMR_EM3_MASK)

#define CTIMER_EMR_EMC0_MASK                     (0x30U)
#define CTIMER_EMR_EMC0_SHIFT                    (4U)
/*! EMC0 - External Match Control 0. Determines the functionality of External Match 0.
 *  0b00..Do Nothing.
 *  0b01..Clear. Clear the corresponding External Match bit/output to 0 (MAT0 pin is LOW if pinned out).
 *  0b10..Set. Set the corresponding External Match bit/output to 1 (MAT0 pin is HIGH if pinned out).
 *  0b11..Toggle. Toggle the corresponding External Match bit/output.
 */
#define CTIMER_EMR_EMC0(x)                       (((uint32_t)(((uint32_t)(x)) << CTIMER_EMR_EMC0_SHIFT)) & CTIMER_EMR_EMC0_MASK)

#define CTIMER_EMR_EMC1_MASK                     (0xC0U)
#define CTIMER_EMR_EMC1_SHIFT                    (6U)
/*! EMC1 - External Match Control 1. Determines the functionality of External Match 1.
 *  0b00..Do Nothing.
 *  0b01..Clear. Clear the corresponding External Match bit/output to 0 (MAT1 pin is LOW if pinned out).
 *  0b10..Set. Set the corresponding External Match bit/output to 1 (MAT1 pin is HIGH if pinned out).
 *  0b11..Toggle. Toggle the corresponding External Match bit/output.
 */
#define CTIMER_EMR_EMC1(x)                       (((uint32_t)(((uint32_t)(x)) << CTIMER_EMR_EMC1_SHIFT)) & CTIMER_EMR_EMC1_MASK)

#define CTIMER_EMR_EMC2_MASK                     (0x300U)
#define CTIMER_EMR_EMC2_SHIFT                    (8U)
/*! EMC2 - External Match Control 2. Determines the functionality of External Match 2.
 *  0b00..Do Nothing.
 *  0b01..Clear. Clear the corresponding External Match bit/output to 0 (MAT2 pin is LOW if pinned out).
 *  0b10..Set. Set the corresponding External Match bit/output to 1 (MAT2 pin is HIGH if pinned out).
 *  0b11..Toggle. Toggle the corresponding External Match bit/output.
 */
#define CTIMER_EMR_EMC2(x)                       (((uint32_t)(((uint32_t)(x)) << CTIMER_EMR_EMC2_SHIFT)) & CTIMER_EMR_EMC2_MASK)

#define CTIMER_EMR_EMC3_MASK                     (0xC00U)
#define CTIMER_EMR_EMC3_SHIFT                    (10U)
/*! EMC3 - External Match Control 3. Determines the functionality of External Match 3.
 *  0b00..Do Nothing.
 *  0b01..Clear. Clear the corresponding External Match bit/output to 0 (MAT3 pin is LOW if pinned out).
 *  0b10..Set. Set the corresponding External Match bit/output to 1 (MAT3 pin is HIGH if pinned out).
 *  0b11..Toggle. Toggle the corresponding External Match bit/output.
 */
#define CTIMER_EMR_EMC3(x)                       (((uint32_t)(((uint32_t)(x)) << CTIMER_EMR_EMC3_SHIFT)) & CTIMER_EMR_EMC3_MASK)
/*! @} */

/*! @name CTCR - Count Control Register. The CTCR selects between Timer and Counter mode, and in Counter mode selects the signal and edge(s) for counting. */
/*! @{ */

#define CTIMER_CTCR_CTMODE_MASK                  (0x3U)
#define CTIMER_CTCR_CTMODE_SHIFT                 (0U)
/*! CTMODE - Counter/Timer Mode This field selects which rising APB bus clock edges can increment
 *    Timer's Prescale Counter (PC), or clear PC and increment Timer Counter (TC). Timer Mode: the TC
 *    is incremented when the Prescale Counter matches the Prescale Register.
 *  0b00..Timer Mode. Incremented every rising APB bus clock edge.
 *  0b01..Counter Mode rising edge. TC is incremented on rising edges on the CAP input selected by bits 3:2.
 *  0b10..Counter Mode falling edge. TC is incremented on falling edges on the CAP input selected by bits 3:2.
 *  0b11..Counter Mode dual edge. TC is incremented on both edges on the CAP input selected by bits 3:2.
 */
#define CTIMER_CTCR_CTMODE(x)                    (((uint32_t)(((uint32_t)(x)) << CTIMER_CTCR_CTMODE_SHIFT)) & CTIMER_CTCR_CTMODE_MASK)

#define CTIMER_CTCR_CINSEL_MASK                  (0xCU)
#define CTIMER_CTCR_CINSEL_SHIFT                 (2U)
/*! CINSEL - Count Input Select When bits 1:0 in this register are not 00, these bits select which
 *    CAP pin is sampled for clocking. Note: If Counter mode is selected for a particular CAPn input
 *    in the CTCR, the 3 bits for that input in the Capture Control Register (CCR) must be
 *    programmed as 000. However, capture and/or interrupt can be selected for the other 3 CAPn inputs in the
 *    same timer.
 *  0b00..Channel 0. CAPn.0 for CTIMERn
 *  0b01..Channel 1. CAPn.1 for CTIMERn
 *  0b10..Channel 2. CAPn.2 for CTIMERn
 *  0b11..Channel 3. CAPn.3 for CTIMERn
 */
#define CTIMER_CTCR_CINSEL(x)                    (((uint32_t)(((uint32_t)(x)) << CTIMER_CTCR_CINSEL_SHIFT)) & CTIMER_CTCR_CINSEL_MASK)

#define CTIMER_CTCR_ENCC_MASK                    (0x10U)
#define CTIMER_CTCR_ENCC_SHIFT                   (4U)
/*! ENCC - Setting this bit to 1 enables clearing of the timer and the prescaler when the
 *    capture-edge event specified in bits 7:5 occurs.
 */
#define CTIMER_CTCR_ENCC(x)                      (((uint32_t)(((uint32_t)(x)) << CTIMER_CTCR_ENCC_SHIFT)) & CTIMER_CTCR_ENCC_MASK)

#define CTIMER_CTCR_SELCC_MASK                   (0xE0U)
#define CTIMER_CTCR_SELCC_SHIFT                  (5U)
/*! SELCC - Edge select. When bit 4 is 1, these bits select which capture input edge will cause the
 *    timer and prescaler to be cleared. These bits have no effect when bit 4 is low. Values 0x2 to
 *    0x3 and 0x6 to 0x7 are reserved.
 *  0b000..Channel 0 Rising Edge. Rising edge of the signal on capture channel 0 clears the timer (if bit 4 is set).
 *  0b001..Channel 0 Falling Edge. Falling edge of the signal on capture channel 0 clears the timer (if bit 4 is set).
 *  0b010..Channel 1 Rising Edge. Rising edge of the signal on capture channel 1 clears the timer (if bit 4 is set).
 *  0b011..Channel 1 Falling Edge. Falling edge of the signal on capture channel 1 clears the timer (if bit 4 is set).
 *  0b100..Channel 2 Rising Edge. Rising edge of the signal on capture channel 2 clears the timer (if bit 4 is set).
 *  0b101..Channel 2 Falling Edge. Falling edge of the signal on capture channel 2 clears the timer (if bit 4 is set).
 */
#define CTIMER_CTCR_SELCC(x)                     (((uint32_t)(((uint32_t)(x)) << CTIMER_CTCR_SELCC_SHIFT)) & CTIMER_CTCR_SELCC_MASK)
/*! @} */

/*! @name PWMC - PWM Control Register. The PWMCON enables PWM mode for the external match pins. */
/*! @{ */

#define CTIMER_PWMC_PWMEN0_MASK                  (0x1U)
#define CTIMER_PWMC_PWMEN0_SHIFT                 (0U)
/*! PWMEN0 - PWM mode enable for channel0.
 *  0b0..Match. CTIMERn_MAT0 is controlled by EM0.
 *  0b1..PWM. PWM mode is enabled for CTIMERn_MAT0.
 */
#define CTIMER_PWMC_PWMEN0(x)                    (((uint32_t)(((uint32_t)(x)) << CTIMER_PWMC_PWMEN0_SHIFT)) & CTIMER_PWMC_PWMEN0_MASK)

#define CTIMER_PWMC_PWMEN1_MASK                  (0x2U)
#define CTIMER_PWMC_PWMEN1_SHIFT                 (1U)
/*! PWMEN1 - PWM mode enable for channel1.
 *  0b0..Match. CTIMERn_MAT01 is controlled by EM1.
 *  0b1..PWM. PWM mode is enabled for CTIMERn_MAT1.
 */
#define CTIMER_PWMC_PWMEN1(x)                    (((uint32_t)(((uint32_t)(x)) << CTIMER_PWMC_PWMEN1_SHIFT)) & CTIMER_PWMC_PWMEN1_MASK)

#define CTIMER_PWMC_PWMEN2_MASK                  (0x4U)
#define CTIMER_PWMC_PWMEN2_SHIFT                 (2U)
/*! PWMEN2 - PWM mode enable for channel2.
 *  0b0..Match. CTIMERn_MAT2 is controlled by EM2.
 *  0b1..PWM. PWM mode is enabled for CTIMERn_MAT2.
 */
#define CTIMER_PWMC_PWMEN2(x)                    (((uint32_t)(((uint32_t)(x)) << CTIMER_PWMC_PWMEN2_SHIFT)) & CTIMER_PWMC_PWMEN2_MASK)

#define CTIMER_PWMC_PWMEN3_MASK                  (0x8U)
#define CTIMER_PWMC_PWMEN3_SHIFT                 (3U)
/*! PWMEN3 - PWM mode enable for channel3. Note: It is recommended to use match channel 3 to set the PWM cycle.
 *  0b0..Match. CTIMERn_MAT3 is controlled by EM3.
 *  0b1..PWM. PWM mode is enabled for CT132Bn_MAT3.
 */
#define CTIMER_PWMC_PWMEN3(x)                    (((uint32_t)(((uint32_t)(x)) << CTIMER_PWMC_PWMEN3_SHIFT)) & CTIMER_PWMC_PWMEN3_MASK)
/*! @} */

/*! @name MSR - Match Shadow Register . If enabled, the Match Register will be automatically reloaded with the contents of this register whenever the TC is reset to zero. */
/*! @{ */

#define CTIMER_MSR_MATCH_SHADOW_MASK             (0xFFFFFFFFU)
#define CTIMER_MSR_MATCH_SHADOW_SHIFT            (0U)
/*! MATCH_Shadow - Timer counter match value. */
#define CTIMER_MSR_MATCH_SHADOW(x)               (((uint32_t)(((uint32_t)(x)) << CTIMER_MSR_MATCH_SHADOW_SHIFT)) & CTIMER_MSR_MATCH_SHADOW_MASK)
/*! @} */


/*!
 * @}
 */ /* end of group CTIMER_Register_Masks */


/*!
 * @}
 */ /* end of group CTIMER_Peripheral_Access_Layer */


/*
** End of section using anonymous unions
*/

#if defined(__ARMCC_VERSION)
  #if (__ARMCC_VERSION >= 6010050)
    #pragma clang diagnostic pop
  #else
    #pragma pop
  #endif
#elif defined(__GNUC__)
  /* leave anonymous unions enabled */
#elif defined(__IAR_SYSTEMS_ICC__)
  #pragma language=default
#else
  #error Not supported compiler type
#endif

/*!
 * @}
 */ /* end of group Peripheral_access_layer */


#endif  /* CTIMER_H_ */
