spyadrian/digital-scale-pcb-firmware/firmware/device/periph5/PERI_USART.h

/*
** ###################################################################
**     Processors:          LPC804M101JDH20
**                          LPC804M101JDH24
**                          LPC804M101JHI33
**                          LPC804M111JDH24
**                          LPC804UK
**
**     Version:             rev. 1.0, 2018-01-09
**     Build:               b240704
**
**     Abstract:
**         CMSIS Peripheral Access Layer for USART
**
**     Copyright 1997-2016 Freescale Semiconductor, Inc.
**     Copyright 2016-2024 NXP
**     SPDX-License-Identifier: BSD-3-Clause
**
**     http:                 www.nxp.com
**     mail:                 support@nxp.com
**
**     Revisions:
**     - rev. 1.0 (2018-01-09)
**         Initial version.
**
** ###################################################################
*/

/*!
 * @file USART.h
 * @version 1.0
 * @date 2018-01-09
 * @brief CMSIS Peripheral Access Layer for USART
 *
 * CMSIS Peripheral Access Layer for USART
 */

#if !defined(USART_H_)
#define USART_H_                                 /**< Symbol preventing repeated inclusion */

#if (defined(CPU_LPC804M101JDH20) || defined(CPU_LPC804M101JDH24) || defined(CPU_LPC804M101JHI33) || defined(CPU_LPC804M111JDH24) || defined(CPU_LPC804UK))
#include "LPC804_COMMON.h"
#else
  #error "No valid CPU defined!"
#endif

/* ----------------------------------------------------------------------------
   -- Device Peripheral Access Layer
   ---------------------------------------------------------------------------- */

/*!
 * @addtogroup Peripheral_access_layer Device Peripheral Access Layer
 * @{
 */


/*
** Start of section using anonymous unions
*/

#if defined(__ARMCC_VERSION)
  #if (__ARMCC_VERSION >= 6010050)
    #pragma clang diagnostic push
  #else
    #pragma push
    #pragma anon_unions
  #endif
#elif defined(__GNUC__)
  /* anonymous unions are enabled by default */
#elif defined(__IAR_SYSTEMS_ICC__)
  #pragma language=extended
#else
  #error Not supported compiler type
#endif

/* ----------------------------------------------------------------------------
   -- USART Peripheral Access Layer
   ---------------------------------------------------------------------------- */

/*!
 * @addtogroup USART_Peripheral_Access_Layer USART Peripheral Access Layer
 * @{
 */

/** USART - Register Layout Typedef */
typedef struct {
  __IO uint32_t CFG;                               /**< USART Configuration register. Basic USART configuration settings that typically are not changed during operation., offset: 0x0 */
  __IO uint32_t CTL;                               /**< USART Control register. USART control settings that are more likely to change during operation., offset: 0x4 */
  __IO uint32_t STAT;                              /**< USART Status register. The complete status value can be read here. Writing ones clears some bits in the register. Some bits can be cleared by writing a 1 to them., offset: 0x8 */
  __IO uint32_t INTENSET;                          /**< Interrupt Enable read and Set register. Contains an individual interrupt enable bit for each potential USART interrupt. A complete value may be read from this register. Writing a 1 to any implemented bit position causes that bit to be set., offset: 0xC */
  __O  uint32_t INTENCLR;                          /**< Interrupt Enable Clear register. Allows clearing any combination of bits in the INTENSET register. Writing a 1 to any implemented bit position causes the corresponding bit to be cleared., offset: 0x10 */
  __I  uint32_t RXDAT;                             /**< Receiver Data register. Contains the last character received., offset: 0x14 */
  __I  uint32_t RXDATSTAT;                         /**< Receiver Data with Status register. Combines the last character received with the current USART receive status. Allows DMA or software to recover incoming data and status together., offset: 0x18 */
  __IO uint32_t TXDAT;                             /**< Transmit Data register. Data to be transmitted is written here., offset: 0x1C */
  __IO uint32_t BRG;                               /**< Baud Rate Generator register. 16-bit integer baud rate divisor value., offset: 0x20 */
  __I  uint32_t INTSTAT;                           /**< Interrupt status register. Reflects interrupts that are currently enabled., offset: 0x24 */
  __IO uint32_t OSR;                               /**< Oversample selection register for asynchronous communication., offset: 0x28 */
  __IO uint32_t ADDR;                              /**< Address register for automatic address matching., offset: 0x2C */
} USART_Type;

/* ----------------------------------------------------------------------------
   -- USART Register Masks
   ---------------------------------------------------------------------------- */

/*!
 * @addtogroup USART_Register_Masks USART Register Masks
 * @{
 */

/*! @name CFG - USART Configuration register. Basic USART configuration settings that typically are not changed during operation. */
/*! @{ */

#define USART_CFG_ENABLE_MASK                    (0x1U)
#define USART_CFG_ENABLE_SHIFT                   (0U)
/*! ENABLE - USART Enable.
 *  0b0..Disabled. The USART is disabled and the internal state machine and counters are reset. While Enable = 0,
 *       all USART interrupts and DMA transfers are disabled. When Enable is set again, CFG and most other control
 *       bits remain unchanged. When re-enabled, the USART will immediately be ready to transmit because the
 *       transmitter has been reset and is therefore available.
 *  0b1..Enabled. The USART is enabled for operation.
 */
#define USART_CFG_ENABLE(x)                      (((uint32_t)(((uint32_t)(x)) << USART_CFG_ENABLE_SHIFT)) & USART_CFG_ENABLE_MASK)

#define USART_CFG_DATALEN_MASK                   (0xCU)
#define USART_CFG_DATALEN_SHIFT                  (2U)
/*! DATALEN - Selects the data size for the USART.
 *  0b00..7 bit Data length.
 *  0b01..8 bit Data length.
 *  0b10..9 bit data length. The 9th bit is commonly used for addressing in multidrop mode. See the ADDRDET bit in the CTL register.
 *  0b11..Reserved.
 */
#define USART_CFG_DATALEN(x)                     (((uint32_t)(((uint32_t)(x)) << USART_CFG_DATALEN_SHIFT)) & USART_CFG_DATALEN_MASK)

#define USART_CFG_PARITYSEL_MASK                 (0x30U)
#define USART_CFG_PARITYSEL_SHIFT                (4U)
/*! PARITYSEL - Selects what type of parity is used by the USART.
 *  0b00..No parity.
 *  0b01..Reserved.
 *  0b10..Even parity. Adds a bit to each character such that the number of 1s in a transmitted character is even,
 *        and the number of 1s in a received character is expected to be even.
 *  0b11..Odd parity. Adds a bit to each character such that the number of 1s in a transmitted character is odd,
 *        and the number of 1s in a received character is expected to be odd.
 */
#define USART_CFG_PARITYSEL(x)                   (((uint32_t)(((uint32_t)(x)) << USART_CFG_PARITYSEL_SHIFT)) & USART_CFG_PARITYSEL_MASK)

#define USART_CFG_STOPLEN_MASK                   (0x40U)
#define USART_CFG_STOPLEN_SHIFT                  (6U)
/*! STOPLEN - Number of stop bits appended to transmitted data. Only a single stop bit is required for received data.
 *  0b0..1 stop bit.
 *  0b1..2 stop bits. This setting should only be used for asynchronous communication.
 */
#define USART_CFG_STOPLEN(x)                     (((uint32_t)(((uint32_t)(x)) << USART_CFG_STOPLEN_SHIFT)) & USART_CFG_STOPLEN_MASK)

#define USART_CFG_CTSEN_MASK                     (0x200U)
#define USART_CFG_CTSEN_SHIFT                    (9U)
/*! CTSEN - CTS Enable. Determines whether CTS is used for flow control. CTS can be from the input
 *    pin, or from the USART's own RTS if loopback mode is enabled.
 *  0b0..No flow control. The transmitter does not receive any automatic flow control signal.
 *  0b1..Flow control enabled. The transmitter uses the CTS input (or RTS output in loopback mode) for flow control purposes.
 */
#define USART_CFG_CTSEN(x)                       (((uint32_t)(((uint32_t)(x)) << USART_CFG_CTSEN_SHIFT)) & USART_CFG_CTSEN_MASK)

#define USART_CFG_SYNCEN_MASK                    (0x800U)
#define USART_CFG_SYNCEN_SHIFT                   (11U)
/*! SYNCEN - Selects synchronous or asynchronous operation.
 *  0b0..Asynchronous mode.
 *  0b1..Synchronous mode.
 */
#define USART_CFG_SYNCEN(x)                      (((uint32_t)(((uint32_t)(x)) << USART_CFG_SYNCEN_SHIFT)) & USART_CFG_SYNCEN_MASK)

#define USART_CFG_CLKPOL_MASK                    (0x1000U)
#define USART_CFG_CLKPOL_SHIFT                   (12U)
/*! CLKPOL - Selects the clock polarity and sampling edge of received data in synchronous mode.
 *  0b0..Falling edge. Un_RXD is sampled on the falling edge of SCLK.
 *  0b1..Rising edge. Un_RXD is sampled on the rising edge of SCLK.
 */
#define USART_CFG_CLKPOL(x)                      (((uint32_t)(((uint32_t)(x)) << USART_CFG_CLKPOL_SHIFT)) & USART_CFG_CLKPOL_MASK)

#define USART_CFG_SYNCMST_MASK                   (0x4000U)
#define USART_CFG_SYNCMST_SHIFT                  (14U)
/*! SYNCMST - Synchronous mode Master select.
 *  0b0..Slave. When synchronous mode is enabled, the USART is a slave.
 *  0b1..Master. When synchronous mode is enabled, the USART is a master.
 */
#define USART_CFG_SYNCMST(x)                     (((uint32_t)(((uint32_t)(x)) << USART_CFG_SYNCMST_SHIFT)) & USART_CFG_SYNCMST_MASK)

#define USART_CFG_LOOP_MASK                      (0x8000U)
#define USART_CFG_LOOP_SHIFT                     (15U)
/*! LOOP - Selects data loopback mode.
 *  0b0..Normal operation.
 *  0b1..Loopback mode. This provides a mechanism to perform diagnostic loopback testing for USART data. Serial
 *       data from the transmitter (Un_TXD) is connected internally to serial input of the receive (Un_RXD). Un_TXD
 *       and Un_RTS activity will also appear on external pins if these functions are configured to appear on device
 *       pins. The receiver RTS signal is also looped back to CTS and performs flow control if enabled by CTSEN.
 */
#define USART_CFG_LOOP(x)                        (((uint32_t)(((uint32_t)(x)) << USART_CFG_LOOP_SHIFT)) & USART_CFG_LOOP_MASK)

#define USART_CFG_OETA_MASK                      (0x40000U)
#define USART_CFG_OETA_SHIFT                     (18U)
/*! OETA - Output Enable Turnaround time enable for RS-485 operation.
 *  0b0..Disabled. If selected by OESEL, the Output Enable signal deasserted at the end of the last stop bit of a transmission.
 *  0b1..Enabled. If selected by OESEL, the Output Enable signal remains asserted for one character time after the
 *       end of the last stop bit of a transmission. OE will also remain asserted if another transmit begins
 *       before it is deasserted.
 */
#define USART_CFG_OETA(x)                        (((uint32_t)(((uint32_t)(x)) << USART_CFG_OETA_SHIFT)) & USART_CFG_OETA_MASK)

#define USART_CFG_AUTOADDR_MASK                  (0x80000U)
#define USART_CFG_AUTOADDR_SHIFT                 (19U)
/*! AUTOADDR - Automatic Address matching enable.
 *  0b0..Disabled. When addressing is enabled by ADDRDET, address matching is done by software. This provides the
 *       possibility of versatile addressing (e.g. respond to more than one address).
 *  0b1..Enabled. When addressing is enabled by ADDRDET, address matching is done by hardware, using the value in
 *       the ADDR register as the address to match.
 */
#define USART_CFG_AUTOADDR(x)                    (((uint32_t)(((uint32_t)(x)) << USART_CFG_AUTOADDR_SHIFT)) & USART_CFG_AUTOADDR_MASK)

#define USART_CFG_OESEL_MASK                     (0x100000U)
#define USART_CFG_OESEL_SHIFT                    (20U)
/*! OESEL - Output Enable Select.
 *  0b0..Standard. The RTS signal is used as the standard flow control function.
 *  0b1..RS-485. The RTS signal configured to provide an output enable signal to control an RS-485 transceiver.
 */
#define USART_CFG_OESEL(x)                       (((uint32_t)(((uint32_t)(x)) << USART_CFG_OESEL_SHIFT)) & USART_CFG_OESEL_MASK)

#define USART_CFG_OEPOL_MASK                     (0x200000U)
#define USART_CFG_OEPOL_SHIFT                    (21U)
/*! OEPOL - Output Enable Polarity.
 *  0b0..Low. If selected by OESEL, the output enable is active low.
 *  0b1..High. If selected by OESEL, the output enable is active high.
 */
#define USART_CFG_OEPOL(x)                       (((uint32_t)(((uint32_t)(x)) << USART_CFG_OEPOL_SHIFT)) & USART_CFG_OEPOL_MASK)

#define USART_CFG_RXPOL_MASK                     (0x400000U)
#define USART_CFG_RXPOL_SHIFT                    (22U)
/*! RXPOL - Receive data polarity.
 *  0b0..Standard. The RX signal is used as it arrives from the pin. This means that the RX rest value is 1, start
 *       bit is 0, data is not inverted, and the stop bit is 1.
 *  0b1..Inverted. The RX signal is inverted before being used by the USART. This means that the RX rest value is
 *       0, start bit is 1, data is inverted, and the stop bit is 0.
 */
#define USART_CFG_RXPOL(x)                       (((uint32_t)(((uint32_t)(x)) << USART_CFG_RXPOL_SHIFT)) & USART_CFG_RXPOL_MASK)

#define USART_CFG_TXPOL_MASK                     (0x800000U)
#define USART_CFG_TXPOL_SHIFT                    (23U)
/*! TXPOL - Transmit data polarity.
 *  0b0..Standard. The TX signal is sent out without change. This means that the TX rest value is 1, start bit is
 *       0, data is not inverted, and the stop bit is 1.
 *  0b1..Inverted. The TX signal is inverted by the USART before being sent out. This means that the TX rest value
 *       is 0, start bit is 1, data is inverted, and the stop bit is 0.
 */
#define USART_CFG_TXPOL(x)                       (((uint32_t)(((uint32_t)(x)) << USART_CFG_TXPOL_SHIFT)) & USART_CFG_TXPOL_MASK)
/*! @} */

/*! @name CTL - USART Control register. USART control settings that are more likely to change during operation. */
/*! @{ */

#define USART_CTL_TXBRKEN_MASK                   (0x2U)
#define USART_CTL_TXBRKEN_SHIFT                  (1U)
/*! TXBRKEN - Break Enable.
 *  0b0..Normal operation.
 *  0b1..Continuous break. Continuous break is sent immediately when this bit is set, and remains until this bit
 *       is cleared. A break may be sent without danger of corrupting any currently transmitting character if the
 *       transmitter is first disabled (TXDIS in CTL is set) and then waiting for the transmitter to be disabled
 *       (TXDISINT in STAT = 1) before writing 1 to TXBRKEN.
 */
#define USART_CTL_TXBRKEN(x)                     (((uint32_t)(((uint32_t)(x)) << USART_CTL_TXBRKEN_SHIFT)) & USART_CTL_TXBRKEN_MASK)

#define USART_CTL_ADDRDET_MASK                   (0x4U)
#define USART_CTL_ADDRDET_SHIFT                  (2U)
/*! ADDRDET - Enable address detect mode.
 *  0b0..Disabled. The USART presents all incoming data.
 *  0b1..Enabled. The USART receiver ignores incoming data that does not have the most significant bit of the data
 *       (typically the 9th bit) = 1. When the data MSB bit = 1, the receiver treats the incoming data normally,
 *       generating a received data interrupt. Software can then check the data to see if this is an address that
 *       should be handled. If it is, the ADDRDET bit is cleared by software and further incoming data is handled
 *       normally.
 */
#define USART_CTL_ADDRDET(x)                     (((uint32_t)(((uint32_t)(x)) << USART_CTL_ADDRDET_SHIFT)) & USART_CTL_ADDRDET_MASK)

#define USART_CTL_TXDIS_MASK                     (0x40U)
#define USART_CTL_TXDIS_SHIFT                    (6U)
/*! TXDIS - Transmit Disable.
 *  0b0..Not disabled. USART transmitter is not disabled.
 *  0b1..Disabled. USART transmitter is disabled after any character currently being transmitted is complete. This
 *       feature can be used to facilitate software flow control.
 */
#define USART_CTL_TXDIS(x)                       (((uint32_t)(((uint32_t)(x)) << USART_CTL_TXDIS_SHIFT)) & USART_CTL_TXDIS_MASK)

#define USART_CTL_CC_MASK                        (0x100U)
#define USART_CTL_CC_SHIFT                       (8U)
/*! CC - Continuous Clock generation. By default, SCLK is only output while data is being transmitted in synchronous mode.
 *  0b0..Clock on character. In synchronous mode, SCLK cycles only when characters are being sent on Un_TXD or to
 *       complete a character that is being received.
 *  0b1..Continuous clock. SCLK runs continuously in synchronous mode, allowing characters to be received on
 *       Un_RxD independently from transmission on Un_TXD).
 */
#define USART_CTL_CC(x)                          (((uint32_t)(((uint32_t)(x)) << USART_CTL_CC_SHIFT)) & USART_CTL_CC_MASK)

#define USART_CTL_CLRCCONRX_MASK                 (0x200U)
#define USART_CTL_CLRCCONRX_SHIFT                (9U)
/*! CLRCCONRX - Clear Continuous Clock.
 *  0b0..No effect. No effect on the CC bit.
 *  0b1..Auto-clear. The CC bit is automatically cleared when a complete character has been received. This bit is cleared at the same time.
 */
#define USART_CTL_CLRCCONRX(x)                   (((uint32_t)(((uint32_t)(x)) << USART_CTL_CLRCCONRX_SHIFT)) & USART_CTL_CLRCCONRX_MASK)

#define USART_CTL_AUTOBAUD_MASK                  (0x10000U)
#define USART_CTL_AUTOBAUD_SHIFT                 (16U)
/*! AUTOBAUD - Autobaud enable.
 *  0b0..Disabled. USART is in normal operating mode.
 *  0b1..Enabled. USART is in autobaud mode. This bit should only be set when the USART receiver is idle. The
 *       first start bit of RX is measured and used the update the BRG register to match the received data rate.
 *       AUTOBAUD is cleared once this process is complete, or if there is an AERR.
 */
#define USART_CTL_AUTOBAUD(x)                    (((uint32_t)(((uint32_t)(x)) << USART_CTL_AUTOBAUD_SHIFT)) & USART_CTL_AUTOBAUD_MASK)
/*! @} */

/*! @name STAT - USART Status register. The complete status value can be read here. Writing ones clears some bits in the register. Some bits can be cleared by writing a 1 to them. */
/*! @{ */

#define USART_STAT_RXRDY_MASK                    (0x1U)
#define USART_STAT_RXRDY_SHIFT                   (0U)
/*! RXRDY - Receiver Ready flag. When 1, indicates that data is available to be read from the
 *    receiver buffer. Cleared after a read of the RXDAT or RXDATSTAT registers.
 */
#define USART_STAT_RXRDY(x)                      (((uint32_t)(((uint32_t)(x)) << USART_STAT_RXRDY_SHIFT)) & USART_STAT_RXRDY_MASK)

#define USART_STAT_RXIDLE_MASK                   (0x2U)
#define USART_STAT_RXIDLE_SHIFT                  (1U)
/*! RXIDLE - Receiver Idle. When 0, indicates that the receiver is currently in the process of
 *    receiving data. When 1, indicates that the receiver is not currently in the process of receiving
 *    data.
 */
#define USART_STAT_RXIDLE(x)                     (((uint32_t)(((uint32_t)(x)) << USART_STAT_RXIDLE_SHIFT)) & USART_STAT_RXIDLE_MASK)

#define USART_STAT_TXRDY_MASK                    (0x4U)
#define USART_STAT_TXRDY_SHIFT                   (2U)
/*! TXRDY - Transmitter Ready flag. When 1, this bit indicates that data may be written to the
 *    transmit buffer. Previous data may still be in the process of being transmitted. Cleared when data
 *    is written to TXDAT. Set when the data is moved from the transmit buffer to the transmit shift
 *    register.
 */
#define USART_STAT_TXRDY(x)                      (((uint32_t)(((uint32_t)(x)) << USART_STAT_TXRDY_SHIFT)) & USART_STAT_TXRDY_MASK)

#define USART_STAT_TXIDLE_MASK                   (0x8U)
#define USART_STAT_TXIDLE_SHIFT                  (3U)
/*! TXIDLE - Transmitter Idle. When 0, indicates that the transmitter is currently in the process of
 *    sending data.When 1, indicate that the transmitter is not currently in the process of sending
 *    data.
 */
#define USART_STAT_TXIDLE(x)                     (((uint32_t)(((uint32_t)(x)) << USART_STAT_TXIDLE_SHIFT)) & USART_STAT_TXIDLE_MASK)

#define USART_STAT_CTS_MASK                      (0x10U)
#define USART_STAT_CTS_SHIFT                     (4U)
/*! CTS - This bit reflects the current state of the CTS signal, regardless of the setting of the
 *    CTSEN bit in the CFG register. This will be the value of the CTS input pin unless loopback mode
 *    is enabled.
 */
#define USART_STAT_CTS(x)                        (((uint32_t)(((uint32_t)(x)) << USART_STAT_CTS_SHIFT)) & USART_STAT_CTS_MASK)

#define USART_STAT_DELTACTS_MASK                 (0x20U)
#define USART_STAT_DELTACTS_SHIFT                (5U)
/*! DELTACTS - This bit is set when a change in the state is detected for the CTS flag above. This bit is cleared by software. */
#define USART_STAT_DELTACTS(x)                   (((uint32_t)(((uint32_t)(x)) << USART_STAT_DELTACTS_SHIFT)) & USART_STAT_DELTACTS_MASK)

#define USART_STAT_TXDISSTAT_MASK                (0x40U)
#define USART_STAT_TXDISSTAT_SHIFT               (6U)
/*! TXDISSTAT - Transmitter Disabled Interrupt flag. When 1, this bit indicates that the USART
 *    transmitter is fully idle after being disabled via the TXDIS in the CTL register (TXDIS = 1).
 */
#define USART_STAT_TXDISSTAT(x)                  (((uint32_t)(((uint32_t)(x)) << USART_STAT_TXDISSTAT_SHIFT)) & USART_STAT_TXDISSTAT_MASK)

#define USART_STAT_OVERRUNINT_MASK               (0x100U)
#define USART_STAT_OVERRUNINT_SHIFT              (8U)
/*! OVERRUNINT - Overrun Error interrupt flag. This flag is set when a new character is received
 *    while the receiver buffer is still in use. If this occurs, the newly received character in the
 *    shift register is lost.
 */
#define USART_STAT_OVERRUNINT(x)                 (((uint32_t)(((uint32_t)(x)) << USART_STAT_OVERRUNINT_SHIFT)) & USART_STAT_OVERRUNINT_MASK)

#define USART_STAT_RXBRK_MASK                    (0x400U)
#define USART_STAT_RXBRK_SHIFT                   (10U)
/*! RXBRK - Received Break. This bit reflects the current state of the receiver break detection
 *    logic. It is set when the Un_RXD pin remains low for 16 bit times. Note that FRAMERRINT will also
 *    be set when this condition occurs because the stop bit(s) for the character would be missing.
 *    RXBRK is cleared when the Un_RXD pin goes high.
 */
#define USART_STAT_RXBRK(x)                      (((uint32_t)(((uint32_t)(x)) << USART_STAT_RXBRK_SHIFT)) & USART_STAT_RXBRK_MASK)

#define USART_STAT_DELTARXBRK_MASK               (0x800U)
#define USART_STAT_DELTARXBRK_SHIFT              (11U)
/*! DELTARXBRK - This bit is set when a change in the state of receiver break detection occurs.Cleared by software. */
#define USART_STAT_DELTARXBRK(x)                 (((uint32_t)(((uint32_t)(x)) << USART_STAT_DELTARXBRK_SHIFT)) & USART_STAT_DELTARXBRK_MASK)

#define USART_STAT_START_MASK                    (0x1000U)
#define USART_STAT_START_SHIFT                   (12U)
/*! START - This bit is set when a start is detected on the receiver input. Its purpose is primarily
 *    to allow wake-up from Deep-sleep or Power-down mode immediately when a start is detected.
 *    Cleared by software.
 */
#define USART_STAT_START(x)                      (((uint32_t)(((uint32_t)(x)) << USART_STAT_START_SHIFT)) & USART_STAT_START_MASK)

#define USART_STAT_FRAMERRINT_MASK               (0x2000U)
#define USART_STAT_FRAMERRINT_SHIFT              (13U)
/*! FRAMERRINT - Framing Error interrupt flag. This flag is set when a character is received with a
 *    missing stop bit at the expected location. This could be an indication of a baud rate or
 *    configuration mismatch with the transmitting source.
 */
#define USART_STAT_FRAMERRINT(x)                 (((uint32_t)(((uint32_t)(x)) << USART_STAT_FRAMERRINT_SHIFT)) & USART_STAT_FRAMERRINT_MASK)

#define USART_STAT_PARITYERRINT_MASK             (0x4000U)
#define USART_STAT_PARITYERRINT_SHIFT            (14U)
/*! PARITYERRINT - Parity Error interrupt flag. This flag is set when a parity error is detected in a received character. */
#define USART_STAT_PARITYERRINT(x)               (((uint32_t)(((uint32_t)(x)) << USART_STAT_PARITYERRINT_SHIFT)) & USART_STAT_PARITYERRINT_MASK)

#define USART_STAT_RXNOISEINT_MASK               (0x8000U)
#define USART_STAT_RXNOISEINT_SHIFT              (15U)
/*! RXNOISEINT - Received Noise interrupt flag. Three samples of received data are taken in order to
 *    determine the value of each received data bit, except in synchronous mode. This acts as a
 *    noise filter if one sample disagrees. This flag is set when a received data bit contains one
 *    disagreeing sample. This could indicate line noise, a baud rate or character format mismatch, or
 *    loss of synchronization during data reception.
 */
#define USART_STAT_RXNOISEINT(x)                 (((uint32_t)(((uint32_t)(x)) << USART_STAT_RXNOISEINT_SHIFT)) & USART_STAT_RXNOISEINT_MASK)

#define USART_STAT_ABERR_MASK                    (0x10000U)
#define USART_STAT_ABERR_SHIFT                   (16U)
/*! ABERR - Autobaud Error. An autobaud error can occur if the BRG counts to its limit before the
 *    end of the start bit that is being measured, essentially an autobaud time-out.
 */
#define USART_STAT_ABERR(x)                      (((uint32_t)(((uint32_t)(x)) << USART_STAT_ABERR_SHIFT)) & USART_STAT_ABERR_MASK)
/*! @} */

/*! @name INTENSET - Interrupt Enable read and Set register. Contains an individual interrupt enable bit for each potential USART interrupt. A complete value may be read from this register. Writing a 1 to any implemented bit position causes that bit to be set. */
/*! @{ */

#define USART_INTENSET_RXRDYEN_MASK              (0x1U)
#define USART_INTENSET_RXRDYEN_SHIFT             (0U)
/*! RXRDYEN - When 1, enables an interrupt when there is a received character available to be read from the RXDAT register. */
#define USART_INTENSET_RXRDYEN(x)                (((uint32_t)(((uint32_t)(x)) << USART_INTENSET_RXRDYEN_SHIFT)) & USART_INTENSET_RXRDYEN_MASK)

#define USART_INTENSET_TXRDYEN_MASK              (0x4U)
#define USART_INTENSET_TXRDYEN_SHIFT             (2U)
/*! TXRDYEN - When 1, enables an interrupt when the TXDAT register is available to take another character to transmit. */
#define USART_INTENSET_TXRDYEN(x)                (((uint32_t)(((uint32_t)(x)) << USART_INTENSET_TXRDYEN_SHIFT)) & USART_INTENSET_TXRDYEN_MASK)

#define USART_INTENSET_TXIDLEEN_MASK             (0x8U)
#define USART_INTENSET_TXIDLEEN_SHIFT            (3U)
/*! TXIDLEEN - When 1, enables an interrupt when the transmitter becomes idle (TXIDLE = 1). */
#define USART_INTENSET_TXIDLEEN(x)               (((uint32_t)(((uint32_t)(x)) << USART_INTENSET_TXIDLEEN_SHIFT)) & USART_INTENSET_TXIDLEEN_MASK)

#define USART_INTENSET_DELTACTSEN_MASK           (0x20U)
#define USART_INTENSET_DELTACTSEN_SHIFT          (5U)
/*! DELTACTSEN - When 1, enables an interrupt when there is a change in the state of the CTS input. */
#define USART_INTENSET_DELTACTSEN(x)             (((uint32_t)(((uint32_t)(x)) << USART_INTENSET_DELTACTSEN_SHIFT)) & USART_INTENSET_DELTACTSEN_MASK)

#define USART_INTENSET_TXDISEN_MASK              (0x40U)
#define USART_INTENSET_TXDISEN_SHIFT             (6U)
/*! TXDISEN - When 1, enables an interrupt when the transmitter is fully disabled as indicated by
 *    the TXDISINT flag in STAT. See description of the TXDISINT bit for details.
 */
#define USART_INTENSET_TXDISEN(x)                (((uint32_t)(((uint32_t)(x)) << USART_INTENSET_TXDISEN_SHIFT)) & USART_INTENSET_TXDISEN_MASK)

#define USART_INTENSET_OVERRUNEN_MASK            (0x100U)
#define USART_INTENSET_OVERRUNEN_SHIFT           (8U)
/*! OVERRUNEN - When 1, enables an interrupt when an overrun error occurred. */
#define USART_INTENSET_OVERRUNEN(x)              (((uint32_t)(((uint32_t)(x)) << USART_INTENSET_OVERRUNEN_SHIFT)) & USART_INTENSET_OVERRUNEN_MASK)

#define USART_INTENSET_DELTARXBRKEN_MASK         (0x800U)
#define USART_INTENSET_DELTARXBRKEN_SHIFT        (11U)
/*! DELTARXBRKEN - When 1, enables an interrupt when a change of state has occurred in the detection
 *    of a received break condition (break condition asserted or deasserted).
 */
#define USART_INTENSET_DELTARXBRKEN(x)           (((uint32_t)(((uint32_t)(x)) << USART_INTENSET_DELTARXBRKEN_SHIFT)) & USART_INTENSET_DELTARXBRKEN_MASK)

#define USART_INTENSET_STARTEN_MASK              (0x1000U)
#define USART_INTENSET_STARTEN_SHIFT             (12U)
/*! STARTEN - When 1, enables an interrupt when a received start bit has been detected. */
#define USART_INTENSET_STARTEN(x)                (((uint32_t)(((uint32_t)(x)) << USART_INTENSET_STARTEN_SHIFT)) & USART_INTENSET_STARTEN_MASK)

#define USART_INTENSET_FRAMERREN_MASK            (0x2000U)
#define USART_INTENSET_FRAMERREN_SHIFT           (13U)
/*! FRAMERREN - When 1, enables an interrupt when a framing error has been detected. */
#define USART_INTENSET_FRAMERREN(x)              (((uint32_t)(((uint32_t)(x)) << USART_INTENSET_FRAMERREN_SHIFT)) & USART_INTENSET_FRAMERREN_MASK)

#define USART_INTENSET_PARITYERREN_MASK          (0x4000U)
#define USART_INTENSET_PARITYERREN_SHIFT         (14U)
/*! PARITYERREN - When 1, enables an interrupt when a parity error has been detected. */
#define USART_INTENSET_PARITYERREN(x)            (((uint32_t)(((uint32_t)(x)) << USART_INTENSET_PARITYERREN_SHIFT)) & USART_INTENSET_PARITYERREN_MASK)

#define USART_INTENSET_RXNOISEEN_MASK            (0x8000U)
#define USART_INTENSET_RXNOISEEN_SHIFT           (15U)
/*! RXNOISEEN - When 1, enables an interrupt when noise is detected. */
#define USART_INTENSET_RXNOISEEN(x)              (((uint32_t)(((uint32_t)(x)) << USART_INTENSET_RXNOISEEN_SHIFT)) & USART_INTENSET_RXNOISEEN_MASK)

#define USART_INTENSET_ABERREN_MASK              (0x10000U)
#define USART_INTENSET_ABERREN_SHIFT             (16U)
/*! ABERREN - When 1, enables an interrupt when an autobaud error occurs. */
#define USART_INTENSET_ABERREN(x)                (((uint32_t)(((uint32_t)(x)) << USART_INTENSET_ABERREN_SHIFT)) & USART_INTENSET_ABERREN_MASK)
/*! @} */

/*! @name INTENCLR - Interrupt Enable Clear register. Allows clearing any combination of bits in the INTENSET register. Writing a 1 to any implemented bit position causes the corresponding bit to be cleared. */
/*! @{ */

#define USART_INTENCLR_RXRDYCLR_MASK             (0x1U)
#define USART_INTENCLR_RXRDYCLR_SHIFT            (0U)
/*! RXRDYCLR - Writing 1 clears the corresponding bit in the INTENSET register. */
#define USART_INTENCLR_RXRDYCLR(x)               (((uint32_t)(((uint32_t)(x)) << USART_INTENCLR_RXRDYCLR_SHIFT)) & USART_INTENCLR_RXRDYCLR_MASK)

#define USART_INTENCLR_TXRDYCLR_MASK             (0x4U)
#define USART_INTENCLR_TXRDYCLR_SHIFT            (2U)
/*! TXRDYCLR - Writing 1 clears the corresponding bit in the INTENSET register. */
#define USART_INTENCLR_TXRDYCLR(x)               (((uint32_t)(((uint32_t)(x)) << USART_INTENCLR_TXRDYCLR_SHIFT)) & USART_INTENCLR_TXRDYCLR_MASK)

#define USART_INTENCLR_TXIDLECLR_MASK            (0x8U)
#define USART_INTENCLR_TXIDLECLR_SHIFT           (3U)
/*! TXIDLECLR - Writing 1 clears the corresponding bit in the INTENSET register. */
#define USART_INTENCLR_TXIDLECLR(x)              (((uint32_t)(((uint32_t)(x)) << USART_INTENCLR_TXIDLECLR_SHIFT)) & USART_INTENCLR_TXIDLECLR_MASK)

#define USART_INTENCLR_DELTACTSCLR_MASK          (0x20U)
#define USART_INTENCLR_DELTACTSCLR_SHIFT         (5U)
/*! DELTACTSCLR - Writing 1 clears the corresponding bit in the INTENSET register. */
#define USART_INTENCLR_DELTACTSCLR(x)            (((uint32_t)(((uint32_t)(x)) << USART_INTENCLR_DELTACTSCLR_SHIFT)) & USART_INTENCLR_DELTACTSCLR_MASK)

#define USART_INTENCLR_TXDISINTCLR_MASK          (0x40U)
#define USART_INTENCLR_TXDISINTCLR_SHIFT         (6U)
/*! TXDISINTCLR - Writing 1 clears the corresponding bit in the INTENSET register. */
#define USART_INTENCLR_TXDISINTCLR(x)            (((uint32_t)(((uint32_t)(x)) << USART_INTENCLR_TXDISINTCLR_SHIFT)) & USART_INTENCLR_TXDISINTCLR_MASK)

#define USART_INTENCLR_OVERRUNCLR_MASK           (0x100U)
#define USART_INTENCLR_OVERRUNCLR_SHIFT          (8U)
/*! OVERRUNCLR - Writing 1 clears the corresponding bit in the INTENSET register. */
#define USART_INTENCLR_OVERRUNCLR(x)             (((uint32_t)(((uint32_t)(x)) << USART_INTENCLR_OVERRUNCLR_SHIFT)) & USART_INTENCLR_OVERRUNCLR_MASK)

#define USART_INTENCLR_DELTARXBRKCLR_MASK        (0x800U)
#define USART_INTENCLR_DELTARXBRKCLR_SHIFT       (11U)
/*! DELTARXBRKCLR - Writing 1 clears the corresponding bit in the INTENSET register. */
#define USART_INTENCLR_DELTARXBRKCLR(x)          (((uint32_t)(((uint32_t)(x)) << USART_INTENCLR_DELTARXBRKCLR_SHIFT)) & USART_INTENCLR_DELTARXBRKCLR_MASK)

#define USART_INTENCLR_STARTCLR_MASK             (0x1000U)
#define USART_INTENCLR_STARTCLR_SHIFT            (12U)
/*! STARTCLR - Writing 1 clears the corresponding bit in the INTENSET register. */
#define USART_INTENCLR_STARTCLR(x)               (((uint32_t)(((uint32_t)(x)) << USART_INTENCLR_STARTCLR_SHIFT)) & USART_INTENCLR_STARTCLR_MASK)

#define USART_INTENCLR_FRAMERRCLR_MASK           (0x2000U)
#define USART_INTENCLR_FRAMERRCLR_SHIFT          (13U)
/*! FRAMERRCLR - Writing 1 clears the corresponding bit in the INTENSET register. */
#define USART_INTENCLR_FRAMERRCLR(x)             (((uint32_t)(((uint32_t)(x)) << USART_INTENCLR_FRAMERRCLR_SHIFT)) & USART_INTENCLR_FRAMERRCLR_MASK)

#define USART_INTENCLR_PARITYERRCLR_MASK         (0x4000U)
#define USART_INTENCLR_PARITYERRCLR_SHIFT        (14U)
/*! PARITYERRCLR - Writing 1 clears the corresponding bit in the INTENSET register. */
#define USART_INTENCLR_PARITYERRCLR(x)           (((uint32_t)(((uint32_t)(x)) << USART_INTENCLR_PARITYERRCLR_SHIFT)) & USART_INTENCLR_PARITYERRCLR_MASK)

#define USART_INTENCLR_RXNOISECLR_MASK           (0x8000U)
#define USART_INTENCLR_RXNOISECLR_SHIFT          (15U)
/*! RXNOISECLR - Writing 1 clears the corresponding bit in the INTENSET register. */
#define USART_INTENCLR_RXNOISECLR(x)             (((uint32_t)(((uint32_t)(x)) << USART_INTENCLR_RXNOISECLR_SHIFT)) & USART_INTENCLR_RXNOISECLR_MASK)

#define USART_INTENCLR_ABERRCLR_MASK             (0x10000U)
#define USART_INTENCLR_ABERRCLR_SHIFT            (16U)
/*! ABERRCLR - Writing 1 clears the corresponding bit in the INTENSET register. */
#define USART_INTENCLR_ABERRCLR(x)               (((uint32_t)(((uint32_t)(x)) << USART_INTENCLR_ABERRCLR_SHIFT)) & USART_INTENCLR_ABERRCLR_MASK)
/*! @} */

/*! @name RXDAT - Receiver Data register. Contains the last character received. */
/*! @{ */

#define USART_RXDAT_RXDAT_MASK                   (0x1FFU)
#define USART_RXDAT_RXDAT_SHIFT                  (0U)
/*! RXDAT - The USART Receiver Data register contains the next received character. The number of
 *    bits that are relevant depends on the USART configuration settings.
 */
#define USART_RXDAT_RXDAT(x)                     (((uint32_t)(((uint32_t)(x)) << USART_RXDAT_RXDAT_SHIFT)) & USART_RXDAT_RXDAT_MASK)
/*! @} */

/*! @name RXDATSTAT - Receiver Data with Status register. Combines the last character received with the current USART receive status. Allows DMA or software to recover incoming data and status together. */
/*! @{ */

#define USART_RXDATSTAT_RXDAT_MASK               (0x1FFU)
#define USART_RXDATSTAT_RXDAT_SHIFT              (0U)
/*! RXDAT - The USART Receiver Data register contains the next received character. The number of
 *    bits that are relevant depends on the USART configuration settings.
 */
#define USART_RXDATSTAT_RXDAT(x)                 (((uint32_t)(((uint32_t)(x)) << USART_RXDATSTAT_RXDAT_SHIFT)) & USART_RXDATSTAT_RXDAT_MASK)

#define USART_RXDATSTAT_FRAMERR_MASK             (0x2000U)
#define USART_RXDATSTAT_FRAMERR_SHIFT            (13U)
/*! FRAMERR - Framing Error status flag. This bit is valid when there is a character to be read in
 *    the RXDAT register and reflects the status of that character. This bit will set when the
 *    character in RXDAT was received with a missing stop bit at the expected location. This could be an
 *    indication of a baud rate or configuration mismatch with the transmitting source.
 */
#define USART_RXDATSTAT_FRAMERR(x)               (((uint32_t)(((uint32_t)(x)) << USART_RXDATSTAT_FRAMERR_SHIFT)) & USART_RXDATSTAT_FRAMERR_MASK)

#define USART_RXDATSTAT_PARITYERR_MASK           (0x4000U)
#define USART_RXDATSTAT_PARITYERR_SHIFT          (14U)
/*! PARITYERR - Parity Error status flag. This bit is valid when there is a character to be read in
 *    the RXDAT register and reflects the status of that character. This bit will be set when a
 *    parity error is detected in a received character.
 */
#define USART_RXDATSTAT_PARITYERR(x)             (((uint32_t)(((uint32_t)(x)) << USART_RXDATSTAT_PARITYERR_SHIFT)) & USART_RXDATSTAT_PARITYERR_MASK)

#define USART_RXDATSTAT_RXNOISE_MASK             (0x8000U)
#define USART_RXDATSTAT_RXNOISE_SHIFT            (15U)
/*! RXNOISE - Received Noise flag. */
#define USART_RXDATSTAT_RXNOISE(x)               (((uint32_t)(((uint32_t)(x)) << USART_RXDATSTAT_RXNOISE_SHIFT)) & USART_RXDATSTAT_RXNOISE_MASK)
/*! @} */

/*! @name TXDAT - Transmit Data register. Data to be transmitted is written here. */
/*! @{ */

#define USART_TXDAT_TXDAT_MASK                   (0x1FFU)
#define USART_TXDAT_TXDAT_SHIFT                  (0U)
/*! TXDAT - Writing to the USART Transmit Data Register causes the data to be transmitted as soon as
 *    the transmit shift register is available and any conditions for transmitting data are met:
 *    CTS low (if CTSEN bit = 1), TXDIS bit = 0.
 */
#define USART_TXDAT_TXDAT(x)                     (((uint32_t)(((uint32_t)(x)) << USART_TXDAT_TXDAT_SHIFT)) & USART_TXDAT_TXDAT_MASK)
/*! @} */

/*! @name BRG - Baud Rate Generator register. 16-bit integer baud rate divisor value. */
/*! @{ */

#define USART_BRG_BRGVAL_MASK                    (0xFFFFU)
#define USART_BRG_BRGVAL_SHIFT                   (0U)
/*! BRGVAL - This value is used to divide the USART input clock to determine the baud rate, based on
 *    the input clock from the FRG. 0 = FCLK is used directly by the USART function. 1 = FCLK is
 *    divided by 2 before use by the USART function. 2 = FCLK is divided by 3 before use by the USART
 *    function. 0xFFFF = FCLK is divided by 65,536 before use by the USART function.
 */
#define USART_BRG_BRGVAL(x)                      (((uint32_t)(((uint32_t)(x)) << USART_BRG_BRGVAL_SHIFT)) & USART_BRG_BRGVAL_MASK)
/*! @} */

/*! @name INTSTAT - Interrupt status register. Reflects interrupts that are currently enabled. */
/*! @{ */

#define USART_INTSTAT_RXRDY_MASK                 (0x1U)
#define USART_INTSTAT_RXRDY_SHIFT                (0U)
/*! RXRDY - Receiver Ready flag. */
#define USART_INTSTAT_RXRDY(x)                   (((uint32_t)(((uint32_t)(x)) << USART_INTSTAT_RXRDY_SHIFT)) & USART_INTSTAT_RXRDY_MASK)

#define USART_INTSTAT_TXRDY_MASK                 (0x4U)
#define USART_INTSTAT_TXRDY_SHIFT                (2U)
/*! TXRDY - Transmitter Ready flag. */
#define USART_INTSTAT_TXRDY(x)                   (((uint32_t)(((uint32_t)(x)) << USART_INTSTAT_TXRDY_SHIFT)) & USART_INTSTAT_TXRDY_MASK)

#define USART_INTSTAT_TXIDLE_MASK                (0x8U)
#define USART_INTSTAT_TXIDLE_SHIFT               (3U)
/*! TXIDLE - Transmitter idle status. */
#define USART_INTSTAT_TXIDLE(x)                  (((uint32_t)(((uint32_t)(x)) << USART_INTSTAT_TXIDLE_SHIFT)) & USART_INTSTAT_TXIDLE_MASK)

#define USART_INTSTAT_DELTACTS_MASK              (0x20U)
#define USART_INTSTAT_DELTACTS_SHIFT             (5U)
/*! DELTACTS - This bit is set when a change in the state of the CTS input is detected. */
#define USART_INTSTAT_DELTACTS(x)                (((uint32_t)(((uint32_t)(x)) << USART_INTSTAT_DELTACTS_SHIFT)) & USART_INTSTAT_DELTACTS_MASK)

#define USART_INTSTAT_TXDISINT_MASK              (0x40U)
#define USART_INTSTAT_TXDISINT_SHIFT             (6U)
/*! TXDISINT - Transmitter Disabled Interrupt flag. */
#define USART_INTSTAT_TXDISINT(x)                (((uint32_t)(((uint32_t)(x)) << USART_INTSTAT_TXDISINT_SHIFT)) & USART_INTSTAT_TXDISINT_MASK)

#define USART_INTSTAT_OVERRUNINT_MASK            (0x100U)
#define USART_INTSTAT_OVERRUNINT_SHIFT           (8U)
/*! OVERRUNINT - Overrun Error interrupt flag. */
#define USART_INTSTAT_OVERRUNINT(x)              (((uint32_t)(((uint32_t)(x)) << USART_INTSTAT_OVERRUNINT_SHIFT)) & USART_INTSTAT_OVERRUNINT_MASK)

#define USART_INTSTAT_DELTARXBRK_MASK            (0x800U)
#define USART_INTSTAT_DELTARXBRK_SHIFT           (11U)
/*! DELTARXBRK - This bit is set when a change in the state of receiver break detection occurs. */
#define USART_INTSTAT_DELTARXBRK(x)              (((uint32_t)(((uint32_t)(x)) << USART_INTSTAT_DELTARXBRK_SHIFT)) & USART_INTSTAT_DELTARXBRK_MASK)

#define USART_INTSTAT_START_MASK                 (0x1000U)
#define USART_INTSTAT_START_SHIFT                (12U)
/*! START - This bit is set when a start is detected on the receiver input. */
#define USART_INTSTAT_START(x)                   (((uint32_t)(((uint32_t)(x)) << USART_INTSTAT_START_SHIFT)) & USART_INTSTAT_START_MASK)

#define USART_INTSTAT_FRAMERRINT_MASK            (0x2000U)
#define USART_INTSTAT_FRAMERRINT_SHIFT           (13U)
/*! FRAMERRINT - Framing Error interrupt flag. */
#define USART_INTSTAT_FRAMERRINT(x)              (((uint32_t)(((uint32_t)(x)) << USART_INTSTAT_FRAMERRINT_SHIFT)) & USART_INTSTAT_FRAMERRINT_MASK)

#define USART_INTSTAT_PARITYERRINT_MASK          (0x4000U)
#define USART_INTSTAT_PARITYERRINT_SHIFT         (14U)
/*! PARITYERRINT - Parity Error interrupt flag. */
#define USART_INTSTAT_PARITYERRINT(x)            (((uint32_t)(((uint32_t)(x)) << USART_INTSTAT_PARITYERRINT_SHIFT)) & USART_INTSTAT_PARITYERRINT_MASK)

#define USART_INTSTAT_RXNOISEINT_MASK            (0x8000U)
#define USART_INTSTAT_RXNOISEINT_SHIFT           (15U)
/*! RXNOISEINT - Received Noise interrupt flag. */
#define USART_INTSTAT_RXNOISEINT(x)              (((uint32_t)(((uint32_t)(x)) << USART_INTSTAT_RXNOISEINT_SHIFT)) & USART_INTSTAT_RXNOISEINT_MASK)

#define USART_INTSTAT_ABERR_MASK                 (0x10000U)
#define USART_INTSTAT_ABERR_SHIFT                (16U)
/*! ABERR - Autobaud Error flag. */
#define USART_INTSTAT_ABERR(x)                   (((uint32_t)(((uint32_t)(x)) << USART_INTSTAT_ABERR_SHIFT)) & USART_INTSTAT_ABERR_MASK)
/*! @} */

/*! @name OSR - Oversample selection register for asynchronous communication. */
/*! @{ */

#define USART_OSR_OSRVAL_MASK                    (0xFU)
#define USART_OSR_OSRVAL_SHIFT                   (0U)
/*! OSRVAL - Oversample Selection Value. 0 to 3 = not supported 0x4 = 5 function clocks are used to
 *    transmit and receive each data bit. 0x5 = 6 function clocks are used to transmit and receive
 *    each data bit. 0xF= 16 function clocks are used to transmit and receive each data bit.
 */
#define USART_OSR_OSRVAL(x)                      (((uint32_t)(((uint32_t)(x)) << USART_OSR_OSRVAL_SHIFT)) & USART_OSR_OSRVAL_MASK)
/*! @} */

/*! @name ADDR - Address register for automatic address matching. */
/*! @{ */

#define USART_ADDR_ADDRESS_MASK                  (0xFFU)
#define USART_ADDR_ADDRESS_SHIFT                 (0U)
/*! ADDRESS - 8-bit address used with automatic address matching. Used when address detection is
 *    enabled (ADDRDET in CTL = 1) and automatic address matching is enabled (AUTOADDR in CFG = 1).
 */
#define USART_ADDR_ADDRESS(x)                    (((uint32_t)(((uint32_t)(x)) << USART_ADDR_ADDRESS_SHIFT)) & USART_ADDR_ADDRESS_MASK)
/*! @} */


/*!
 * @}
 */ /* end of group USART_Register_Masks */


/*!
 * @}
 */ /* end of group USART_Peripheral_Access_Layer */


/*
** End of section using anonymous unions
*/

#if defined(__ARMCC_VERSION)
  #if (__ARMCC_VERSION >= 6010050)
    #pragma clang diagnostic pop
  #else
    #pragma pop
  #endif
#elif defined(__GNUC__)
  /* leave anonymous unions enabled */
#elif defined(__IAR_SYSTEMS_ICC__)
  #pragma language=default
#else
  #error Not supported compiler type
#endif

/*!
 * @}
 */ /* end of group Peripheral_access_layer */


#endif  /* USART_H_ */
