spyadrian/digital-scale-pcb-firmware/firmware/device/periph5/PERI_WWDT.h

/*
** ###################################################################
**     Processors:          LPC804M101JDH20
**                          LPC804M101JDH24
**                          LPC804M101JHI33
**                          LPC804M111JDH24
**                          LPC804UK
**
**     Version:             rev. 1.0, 2018-01-09
**     Build:               b240704
**
**     Abstract:
**         CMSIS Peripheral Access Layer for WWDT
**
**     Copyright 1997-2016 Freescale Semiconductor, Inc.
**     Copyright 2016-2024 NXP
**     SPDX-License-Identifier: BSD-3-Clause
**
**     http:                 www.nxp.com
**     mail:                 support@nxp.com
**
**     Revisions:
**     - rev. 1.0 (2018-01-09)
**         Initial version.
**
** ###################################################################
*/

/*!
 * @file WWDT.h
 * @version 1.0
 * @date 2018-01-09
 * @brief CMSIS Peripheral Access Layer for WWDT
 *
 * CMSIS Peripheral Access Layer for WWDT
 */

#if !defined(WWDT_H_)
#define WWDT_H_                                  /**< Symbol preventing repeated inclusion */

#if (defined(CPU_LPC804M101JDH20) || defined(CPU_LPC804M101JDH24) || defined(CPU_LPC804M101JHI33) || defined(CPU_LPC804M111JDH24) || defined(CPU_LPC804UK))
#include "LPC804_COMMON.h"
#else
  #error "No valid CPU defined!"
#endif

/* ----------------------------------------------------------------------------
   -- Device Peripheral Access Layer
   ---------------------------------------------------------------------------- */

/*!
 * @addtogroup Peripheral_access_layer Device Peripheral Access Layer
 * @{
 */


/*
** Start of section using anonymous unions
*/

#if defined(__ARMCC_VERSION)
  #if (__ARMCC_VERSION >= 6010050)
    #pragma clang diagnostic push
  #else
    #pragma push
    #pragma anon_unions
  #endif
#elif defined(__GNUC__)
  /* anonymous unions are enabled by default */
#elif defined(__IAR_SYSTEMS_ICC__)
  #pragma language=extended
#else
  #error Not supported compiler type
#endif

/* ----------------------------------------------------------------------------
   -- WWDT Peripheral Access Layer
   ---------------------------------------------------------------------------- */

/*!
 * @addtogroup WWDT_Peripheral_Access_Layer WWDT Peripheral Access Layer
 * @{
 */

/** WWDT - Register Layout Typedef */
typedef struct {
  __IO uint32_t MOD;                               /**< Watchdog mode register. This register contains the basic mode and status of the Watchdog Timer., offset: 0x0 */
  __IO uint32_t TC;                                /**< Watchdog timer constant register. This 24-bit register determines the time-out value., offset: 0x4 */
  __O  uint32_t FEED;                              /**< Watchdog feed sequence register. Writing 0xAA followed by 0x55 to this register reloads the Watchdog timer with the value contained in TC., offset: 0x8 */
  __I  uint32_t TV;                                /**< Watchdog timer value register. This 24-bit register reads out the current value of the Watchdog timer., offset: 0xC */
       uint8_t RESERVED_0[4];
  __IO uint32_t WARNINT;                           /**< Watchdog Warning Interrupt compare value., offset: 0x14 */
  __IO uint32_t WINDOW;                            /**< Watchdog Window compare value., offset: 0x18 */
} WWDT_Type;

/* ----------------------------------------------------------------------------
   -- WWDT Register Masks
   ---------------------------------------------------------------------------- */

/*!
 * @addtogroup WWDT_Register_Masks WWDT Register Masks
 * @{
 */

/*! @name MOD - Watchdog mode register. This register contains the basic mode and status of the Watchdog Timer. */
/*! @{ */

#define WWDT_MOD_WDEN_MASK                       (0x1U)
#define WWDT_MOD_WDEN_SHIFT                      (0U)
/*! WDEN - Watchdog enable bit. Once this bit is set to one and a watchdog feed is performed, the
 *    watchdog timer will run permanently.
 *  0b0..Stop. The watchdog timer is stopped.
 *  0b1..Run. The watchdog timer is running.
 */
#define WWDT_MOD_WDEN(x)                         (((uint32_t)(((uint32_t)(x)) << WWDT_MOD_WDEN_SHIFT)) & WWDT_MOD_WDEN_MASK)

#define WWDT_MOD_WDRESET_MASK                    (0x2U)
#define WWDT_MOD_WDRESET_SHIFT                   (1U)
/*! WDRESET - Watchdog reset enable bit. Once this bit has been written with a 1 it cannot be re-written with a 0.
 *  0b0..Interrupt. A watchdog time-out will not cause a chip reset.
 *  0b1..Reset. A watchdog time-out will cause a chip reset.
 */
#define WWDT_MOD_WDRESET(x)                      (((uint32_t)(((uint32_t)(x)) << WWDT_MOD_WDRESET_SHIFT)) & WWDT_MOD_WDRESET_MASK)

#define WWDT_MOD_WDTOF_MASK                      (0x4U)
#define WWDT_MOD_WDTOF_SHIFT                     (2U)
/*! WDTOF - Watchdog time-out flag. Set when the watchdog timer times out, by a feed error, or by
 *    events associated with WDPROTECT. Cleared by software writing a 0 to this bit position. Causes a
 *    chip reset if WDRESET = 1.
 */
#define WWDT_MOD_WDTOF(x)                        (((uint32_t)(((uint32_t)(x)) << WWDT_MOD_WDTOF_SHIFT)) & WWDT_MOD_WDTOF_MASK)

#define WWDT_MOD_WDINT_MASK                      (0x8U)
#define WWDT_MOD_WDINT_SHIFT                     (3U)
/*! WDINT - Warning interrupt flag. Set when the timer is at or below the value in WDWARNINT.
 *    Cleared by software writing a 1 to this bit position. Note that this bit cannot be cleared while the
 *    WARNINT value is equal to the value of the TV register. This can occur if the value of
 *    WARNINT is 0 and the WDRESET bit is 0 when TV decrements to 0.
 */
#define WWDT_MOD_WDINT(x)                        (((uint32_t)(((uint32_t)(x)) << WWDT_MOD_WDINT_SHIFT)) & WWDT_MOD_WDINT_MASK)

#define WWDT_MOD_WDPROTECT_MASK                  (0x10U)
#define WWDT_MOD_WDPROTECT_SHIFT                 (4U)
/*! WDPROTECT - Watchdog update mode. This bit can be set once by software and is only cleared by a reset.
 *  0b0..Flexible. The watchdog time-out value (TC) can be changed at any time.
 *  0b1..Threshold. The watchdog time-out value (TC) can be changed only after the counter is below the value of WDWARNINT and WDWINDOW.
 */
#define WWDT_MOD_WDPROTECT(x)                    (((uint32_t)(((uint32_t)(x)) << WWDT_MOD_WDPROTECT_SHIFT)) & WWDT_MOD_WDPROTECT_MASK)

#define WWDT_MOD_LOCK_MASK                       (0x20U)
#define WWDT_MOD_LOCK_SHIFT                      (5U)
/*! LOCK - Once this bit is set to one and a watchdog feed is performed, disabling or powering down
 *    the watchdog oscillator is prevented by hardware. This bit can be set once by software and is
 *    only cleared by any reset.
 */
#define WWDT_MOD_LOCK(x)                         (((uint32_t)(((uint32_t)(x)) << WWDT_MOD_LOCK_SHIFT)) & WWDT_MOD_LOCK_MASK)
/*! @} */

/*! @name TC - Watchdog timer constant register. This 24-bit register determines the time-out value. */
/*! @{ */

#define WWDT_TC_COUNT_MASK                       (0xFFFFFFU)
#define WWDT_TC_COUNT_SHIFT                      (0U)
/*! COUNT - Watchdog time-out value. */
#define WWDT_TC_COUNT(x)                         (((uint32_t)(((uint32_t)(x)) << WWDT_TC_COUNT_SHIFT)) & WWDT_TC_COUNT_MASK)
/*! @} */

/*! @name FEED - Watchdog feed sequence register. Writing 0xAA followed by 0x55 to this register reloads the Watchdog timer with the value contained in TC. */
/*! @{ */

#define WWDT_FEED_FEED_MASK                      (0xFFU)
#define WWDT_FEED_FEED_SHIFT                     (0U)
/*! FEED - Feed value should be 0xAA followed by 0x55. */
#define WWDT_FEED_FEED(x)                        (((uint32_t)(((uint32_t)(x)) << WWDT_FEED_FEED_SHIFT)) & WWDT_FEED_FEED_MASK)
/*! @} */

/*! @name TV - Watchdog timer value register. This 24-bit register reads out the current value of the Watchdog timer. */
/*! @{ */

#define WWDT_TV_COUNT_MASK                       (0xFFFFFFU)
#define WWDT_TV_COUNT_SHIFT                      (0U)
/*! COUNT - Counter timer value. */
#define WWDT_TV_COUNT(x)                         (((uint32_t)(((uint32_t)(x)) << WWDT_TV_COUNT_SHIFT)) & WWDT_TV_COUNT_MASK)
/*! @} */

/*! @name WARNINT - Watchdog Warning Interrupt compare value. */
/*! @{ */

#define WWDT_WARNINT_WARNINT_MASK                (0x3FFU)
#define WWDT_WARNINT_WARNINT_SHIFT               (0U)
/*! WARNINT - Watchdog warning interrupt compare value. */
#define WWDT_WARNINT_WARNINT(x)                  (((uint32_t)(((uint32_t)(x)) << WWDT_WARNINT_WARNINT_SHIFT)) & WWDT_WARNINT_WARNINT_MASK)
/*! @} */

/*! @name WINDOW - Watchdog Window compare value. */
/*! @{ */

#define WWDT_WINDOW_WINDOW_MASK                  (0xFFFFFFU)
#define WWDT_WINDOW_WINDOW_SHIFT                 (0U)
/*! WINDOW - Watchdog window value. */
#define WWDT_WINDOW_WINDOW(x)                    (((uint32_t)(((uint32_t)(x)) << WWDT_WINDOW_WINDOW_SHIFT)) & WWDT_WINDOW_WINDOW_MASK)
/*! @} */


/*!
 * @}
 */ /* end of group WWDT_Register_Masks */


/*!
 * @}
 */ /* end of group WWDT_Peripheral_Access_Layer */


/*
** End of section using anonymous unions
*/

#if defined(__ARMCC_VERSION)
  #if (__ARMCC_VERSION >= 6010050)
    #pragma clang diagnostic pop
  #else
    #pragma pop
  #endif
#elif defined(__GNUC__)
  /* leave anonymous unions enabled */
#elif defined(__IAR_SYSTEMS_ICC__)
  #pragma language=default
#else
  #error Not supported compiler type
#endif

/*!
 * @}
 */ /* end of group Peripheral_access_layer */


#endif  /* WWDT_H_ */
