spyadrian/digital-scale-pcb-firmware/firmware/drivers/fsl_clock.c

/*
 * Copyright 2017-2019 NXP
 * All rights reserved.
 *
 * SPDX-License-Identifier: BSD-3-Clause
 */

#include "fsl_clock.h"
#include "fsl_romapi.h"
/*******************************************************************************
 * Definitions
 ******************************************************************************/
/* Component ID definition, used by tools. */
#ifndef FSL_COMPONENT_ID
#define FSL_COMPONENT_ID "platform.drivers.clock"
#endif

/* External clock rate.
 * Either external clk in rate or system oscillator frequency.
 */
volatile uint32_t g_Ext_Clk_Freq = 0U;
/** Lower power oscillator rate in Hz.*/
volatile uint32_t g_LP_Osc_Freq = 1000000U;
/** Fro oscillator rate in Hz */
volatile uint32_t g_Fro_Osc_Freq = 0U;

/*******************************************************************************
 * Variables
 ******************************************************************************/

/*******************************************************************************
 * Prototypes
 ******************************************************************************/

/*
 * @brief   Get FRG input clock frequency.
 * @param fractional clock register base address.
 * @return  input clock frequency.
 */
static uint32_t CLOCK_GetFRGInputClkFreq(volatile uint32_t *base);

/*
 * @brief Update clock source.
 * @param base clock register base address.
 * @param mask clock source update enable bit mask value.
 */
static void CLOCK_UpdateClkSrc(volatile uint32_t *base, uint32_t mask);

/*******************************************************************************
 * Code
 ******************************************************************************/
static uint32_t CLOCK_GetFRGInputClkFreq(volatile uint32_t *base)
{
    uint32_t sel = CLK_FRG_SEL_REG_MAP(base) & SYSCON_FRG_FRGCLKSEL_SEL_MASK;
    uint32_t freq;

    if (sel == 0U)
    {
        freq = CLOCK_GetFroFreq();
    }
    else if (sel == 1U)
    {
        freq = CLOCK_GetMainClkFreq();
    }
    else
    {
        freq = 0;
    }
    return freq;
}
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
