spyadrian/digital-scale-pcb-firmware/(commit log)

2025-05-13 Kitchen scale: hardware, firmware and report
    [PCB1.GBL, PCB1.GBO, PCB1.GBP, PCB1.GBS, PCB1.GTL, PCB1.GTO, PCB1.GTP, PCB1.GTS]
2026-11-13 docs: rewrite README, keep only the compiled report, add figures and license
    - README: hardware blocks with schematics, layout, measurements, firmware
    and an explicit status (load cell not delivered, demo shows random values)
    - Remove the Typst report sources; report and slides as PDF in docs/
    - Demo GIF from the video, photos and figures reorganised under docs/
    - Move the measurement scripts to measurements/
